mumme74/CarTransporter/README.md

# CarTransporter

This repository is for the electronics systems used to make car transporter

Electronic control of airsuspension
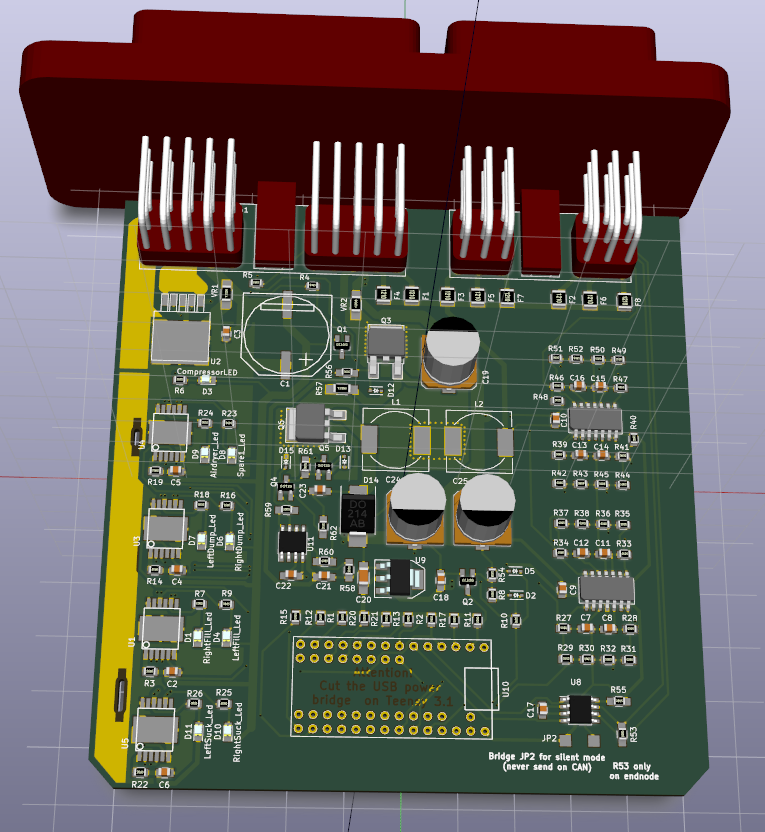
[picture p1: electronics/AirSuspension/airsuspension.png]
pcb


Electronic parkbrakes
