mumme74/CarTransporter/firmware/parkbrake_ECU/readme.txt

*****************************************************************************
** ChibiOS/RT port for ARM-Cortex-M4 STM32F373                            **
*****************************************************************************

** TARGET **

This firmware is supposed to run on the parkbrake baord sesigned within this respoitory
