mumme74/CarTransporter/Airsuspension.odt

L-fill

L-dump

L-suck

R-fill

R-dump

R-suck

SAAB transport Airsuspension

Pneumatic circuit

M

P

system-pressure sensor

Compressor temp. sensor

RR

RF

LR

LF

T

Airdryer bleed valve

R-fill

R-dump

L-dump

L-fill

L-pressure sensor

R-pressure sensor

P

P

Engine vacuum

R-suck

L-suck

Electric circuit inputs

15

5A

1 2 3 1 2 3 1 2 3 1 2 3 1 2 3 Can_hi Can_lo Can_hi Can_lo 120Ω 120Ω K2 30pin K1 30pin A2 18pin A1 18pin B2 18pin B1 18pin C3 18pin C2 18pin C1 18pin D3 18pin D2 18pin D1 18pin E3 18pin E2 18pin E1 18pin F1 18pin H2 30pin H3 30pin G1 30pin H1 30pin

2 (signal)

1 (5V feed)

3 (gnd)

!! TODO

Dbl check pinouts

2 (signal)

1 (5V feed)

3 (gnd)

!! TODO

Dbl check pinouts

P

1 = brown (12V)

2 = black (out 0-5V)

3 = blue (0V)

P

1 = brown (12V)

2 = black (out 0-5V)

3 = blue (0V)

P

1 = brown (12V)

2 = black (out 0-5V)

3 = blue (0V)

t-

Screen node

Park brake node

Left height sensor

Right height sensor

System pressure

Left pressure

Right pressure

Compressor

Temp

Sensor GND

1.5 black

1.5 blue

0.75 blue

0.75 blue

0.75 blue

0.75 brown

0.75 brown

0.75 brown

0.75 orange

0.75 white

0.75 red

0.75 brown

0.75 brown

0.75 yellow

0.75 yellow

0.75 gray

0.75 orange

0.75 yellow

0.75 violet

0.75 green

0.75 green/gray

Electric circuit outputs

30

Note!

2 fuses to distribute load

30A

15A

M M A2 30pin A1 30pin A3 30pin B1 30pin B2 30pin F1 30pin C1 30pin C2 30pin E1 30pin F3 30pin E3 30pin G3 30pin F2 30pin E2 30pin G2 30pin D1 30pin D2 30pin D3 30pin C3 30pin

t+

30

86

30A

Airdryer heater and bleed valve

Compressor

1.5 yellow

1,5 green

6 red

6 red

1.5 gray

1.5 darkblue

1.5 blue

1.5 violett

1.5 green

1.5 white

1.5 orange

1.5 black

1.5 black

1.5 black

1.5 black

6 black

Power GND

1.5 black

Sensor GND and Power GND must be 2 separate groundpoints

87

85

1.5 yellow

6 yellow
