mumme74/CarTransporter/Parkbrake.odt

Parkbrake Car transporter

5A

10A

5A

30

15

58

54

2017-01-08

Rd 1,5

680 1k 1k Can_hi Can_lo Can_hi Can_lo 120Ω 120Ω A2 30pin C3 18pin F3 18pin E3 18pin B1 30pin A1 30pin H3 30pin G3 30pin C1 30pin D1 30pin F3 30pin E3 30pin D2 30pin D3 30pin B2 30pin B3 30pin C2 30pin C3 30pin

Release

Activate

30

31

Non

Invert

Invert

58

15

Backlight

Parkbrake Light

Screen node

Suspension node

5A

5A

Bk 0,75

Bu 0,75

Bu 2,5

Or 0,75

0.75 green

0.75 green/gray

Wh 1,5

Ye 0,75

Gr 0,75

Gr 0,75

Bu 1,5

At cabin/rear section

ABS

L+ sensor

L- sensor

R+ sensor

R- sensor

LF sensor

RF sensor

LR sensor

RR sensor

Bu 2,5

Bu 1,5

D3 18pin A3 30pin

J2 30pin J3 30pin J1 30pin B3 18pin B2 18pin B1 18pin E1 30pin F1 30pin F1 18pin E1 18pin A2 18pin A1 18pin K3 30pin K2 30pin K1 30pin

30A

30A

30

At cabin/rear section

M M M M A3 18pin E2 18pin F2 18pin F2 30pin E2 30pin C1 18pin C2 18pin D1 18pin D2 18pin H1 30pin H2 30pin G1 30pin G2 30pin

30A

30A

Suspension

2.5 black

Power GND

6 black

4 connectorpins to distribute power

RR motor

RF motor

LF motor

LR motor

Pwr Rear

Pwr Front

+ 4 wh

- 4 bn

- 4 bu

- 4 sv

- 4 ye

+ 4 gn/gr

+ 4 gr

+ 4 rd

4 red

4 red

6 red

6 red

2.5 black

Power GND

6 black
