mumme74/CarTransporter/electronics/Parkbrake/Parkbrake.ods

Reference | Quantity | Value | Footprint | Datasheet | part | farnell
C1 C11 C12 C13 C16 C18 C19 C2 C20 C23 C25 C26 C27 C3 C30 C32 C34 C37 C39 C4 C42 C47 C48 C5 C57 C59 C6 C60 C61 C62 C64 C65 C66 C67 C68 C69 C70 C71 C9 C94 C95 C98 | 42 | 100n | Capacitors_SMD:C_0805 |  | 0805B104J500CT | 2496940
C10 C14 C17 C21 C24 C28 C31 C33 C50 C52 C54 C56 C7 C74 C75 C76 C77 C78 C79 C80 C81 C82 C87 C88 C89 C90 C91 | 27 | 1u | Capacitors_SMD:C_1206 |  | GRM31MR71E105JA01L | 2362126
C35 | 1 | 470p | Capacitors_SMD:C_0805 |  | 0805N471J500CT | 2497037
C36 | 1 | 10u | Capacitors_Tantalum_SMD:TantalC_SizeC_EIA-6032_Wave |  | T491C106K035AT | 1457464
C38 | 1 | 680u | Capacitors_Tantalum_SMD:TantalC_SizeD_EIA-7343_Wave |  | TPSE687K006R0060 | 2283882
C40 C41 C92 C93 | 4 | 10u | myfootprints:CP_0805 |  | TMCP0J106KTRF | 2491430
C43 C58 C63 C96 C97 C99 | 6 | 1n | Capacitors_SMD:C_0805 |  | GRM2165C1H102JA01D | 2494247
C44 C45 | 2 | 26p | Capacitors_SMD:C_0805 |  | 0805N270J500CT | 2497027
C46 | 1 | 4.7u | myfootprints:CP_0805 |  | TMCP0J475KTRF | 2491429
C49 C51 C53 C55 | 4 | 10n | Capacitors_SMD:C_0805 |  | 0805B103J500CT | 2496936
C72 C73 | 2 | 33uF | myfootprints:CP_1206 |  | 293D336X96R3A2TE3 | 1754149
C15 C22 C29 C8 | 4 | 220nF | Capacitors_SMD:C_1206 |  | 1206B224J500CT | 2497088
C83 C84 C85 C86 | 4 | 47n | Capacitors_SMD:C_0805 |  | 0805B473J500CT | 2496981
D10 | 1 | RF_Release | LEDs:LED_0805 |  | KP-2012LSGC | 2463991
D11 | 1 | RF_tighten | LEDs:LED_0805 |  | KP-2012SRC-PRV | 1318244
D12 | 1 | RR_Release | LEDs:LED_0805 |  | KP-2012LSGC | 2463991
D13 | 1 | RR_Tighten | LEDs:LED_0805 |  | KP-2012SRC-PRV | 1318244
D14 D15 D16 D17 D18 D19 D20 D21 D22 D23 D24 D25 | 12 | 1n4148W | Diodes_SMD:SOD-323 |  | 1N4148WS | 1466524
D26 | 1 | min 40V 1A | Diodes_SMD:SOD-123 |  | NTS260SFT1G | 2473419
D27 | 1 | min 1.5A | Diodes_SMD:SOD-123 |  | NTS260SFT1G | 2473419
D28 D29 D31 D32 D33 D34 | 6 | 3.3V | Diodes_SMD:SOD-323 |  | MM3Z3V3ST1G | 2463489
D3 D30 D35 D36 D37 D38 D39 D4 D40 D41 | 10 | 1n4148w | Diodes_SMD:SOD-323 |  | 1N4148WS | 1466524
D1 D2 D5 | 3 | 10v | Diodes_SMD:SOD-323 |  | MM3Z10VT1G | 1431190
D6 | 1 | LF_Release | LEDs:LED_0805 |  | KP-2012LSGC | 2463991
D7 | 1 | LF_Tighten | LEDs:LED_0805 |  | KP-2012SRC-PRV | 1318244
D8 | 1 | LR_Release | LEDs:LED_0805 |  | KP-2012LSGC | 2463991
D9 | 1 | LR_Tighten | LEDs:LED_0805 |  | KP-2012SRC-PRV | 1318244
Ha1 | 1 | Box |  |  | 5810130042 | 1282197
Ha2 | 1 | cooling_fin |  |  | 5810000021 | 1282203
Ha3 | 1 | conn_18pin |  |  | 581-01-18-023 | 2099333
Ha4 | 1 | connector_pins |  |  | 4250000872 | 1282209
Ha5 | 1 | box_socket |  |  | 5810148007 | 1282184
Ha6 | 1 | fin_left |  |  | 5810000020 | 1282204
Ha7 | 1 | conn_30pin |  |  | 581-01-30-029 | 2143771
Ha8 | 1 | sealplug_need_10 |  |  | 581-00-00-011 | 2099332
JP1 | 1 | BOOT0 | Resistors_SMD:R_0805_HandSoldering |  | RC1206JR-070RL | 9240276
JP10 | 1 | RF_passth+ | Resistors_SMD:R_0805_HandSoldering |  | RC1206JR-070RL | 9240276
JP11 | 1 | RF+_to_in | Resistors_SMD:R_0805_HandSoldering |  | RC1206JR-070RL | 9240276
JP12 | 1 | soft_R_out- | Resistors_SMD:R_0805_HandSoldering |  | RC1206JR-070RL | 9240276
JP13 | 1 | RF_passth- | Resistors_SMD:R_0805_HandSoldering |  | RC1206JR-070RL | 9240276
JP14 | 1 | RF-_to_in | Resistors_SMD:R_0805_HandSoldering |  | RC1206JR-070RL | 9240276
JP2 | 1 | Jumper_NO_Small | Resistors_SMD:R_0805_HandSoldering |  | RC1206JR-070RL | 9240276
JP3 | 1 | soft_L_out+ | Resistors_SMD:R_0805_HandSoldering |  | RC1206JR-070RL | 9240276
JP4 | 1 | L_passth+ | Resistors_SMD:R_0805_HandSoldering |  | RC1206JR-070RL | 9240276
JP5 | 1 | LF+_to_in | Resistors_SMD:R_0805_HandSoldering |  | RC1206JR-070RL | 9240276
JP6 | 1 | soft_L_out- | Resistors_SMD:R_0805_HandSoldering |  | RC1206JR-070RL | 9240276
JP7 | 1 | L_passth- | Resistors_SMD:R_0805_HandSoldering |  | RC1206JR-070RL | 9240276
JP8 | 1 | LF-_to_in | Resistors_SMD:R_0805_HandSoldering |  | RC1206JR-070RL | 9240276
JP9 | 1 | soft_R_out+ | Resistors_SMD:R_0805_HandSoldering |  | RC1206JR-070RL | 9240276
L1 | 1 | 10uH | myfootprints:inductor_sd54 |  | LQH32CN100K33L | 9522204
L2 | 1 | 33uH | myfootprints:inductor_sd54 |  | SD54-333MLB | 2526983
P1 | 1 | Conn48pin
P2 | 1 | JTAG | Socket_Strips:Socket_Strip_Straight_1x08 |  | 61300811121 | 2356160
P3 | 1 | UART | Socket_Strips:Socket_Strip_Straight_1x03 |  | 826629-3 | 3418297
Q1 Q2 Q31 | 3 | BSS138 | TO_SOT_Packages_SMD:SOT-323 |  | BSS138PW | 1907611
Q3 Q4 | 2 | P-ch -40V 0.0035ohm | TO_SOT_Packages_SMD:TO-252-2Lead |  | PD90P04P4-05 | 2480840
Q32 | 1 | NTS4173 | TO_SOT_Packages_SMD:SOT-323 |  | NTS4173PT1G | 2533203
Q5 Q6 | 2 | BSS308 | TO_SOT_Packages_SMD:SOT-23 |  | BSS308PE H6327 | 2432719
Q12 Q13 Q18 Q19 Q24 Q25 Q30 Q33 Q7 | 9 | NX3008CBKS | SOT363:SOT-363 |  | NX3008CBKS | 2069539
Q10 Q11 Q14 Q15 Q16 Q17 Q20 Q21 Q22 Q23 Q26 Q27 Q28 Q29 Q8 Q9 | 16 | IPD031N06L3 G | TO_SOT_Packages_SMD:TO-252-2Lead |  | IPD031N06L3 G | 2480814
R102 | 1 | 560 | Resistors_SMD:R_0805 |  | MC01W08051560R | 9333363
R103 | 1 | 2.2k | Resistors_SMD:R_Array_Concave_4x0603 |  | EXB38V222JV | 2060102
R104 R110 | 2 | 1k | Resistors_SMD:R_Array_Concave_4x0603 |  | EXB38V102JV | 2060100
R105 | 1 | 100k | Resistors_SMD:R_0805 |  | MC01W08051100K | 9332405
R107 | 1 | 2k | Resistors_SMD:R_0805 |  | MC01W080512K | 9332766
R108 R109 | 2 | 1M | Resistors_SMD:R_0805 |  | MC01W080511M | 9332413
R111 R112 R113 R114 | 4 | 15k | Resistors_SMD:R_0805 |  | ERJP06F1502V | 1750772
R115 R116 | 2 | 16.9k | Resistors_SMD:R_0805 |  | MC01W0805116K9 | 2141858
R17 R34 R51 R68 | 4 | 43 | Resistors_SMD:R_0805 |  | MC01W0805143R | 9333240
R20 R21 R22 R24 R37 R38 R39 R41 R54 R55 R56 R58 R71 R72 R73 R75 | 16 | 0.002 | Resistors_SMD:R_1206 |  | ULR1S-R002FT2 | 1621962
R19 R23 R36 R40 R53 R57 R70 R74 | 8 | 100 | Resistors_SMD:R_0805 |  | MC01W08051100R | 9332375
R14 R15 R25 R26 R31 R32 R42 R43 R48 R49 R59 R60 R65 R66 R76 R77 | 16 | 10 | Resistors_SMD:R_0805 |  | WF08P10R0FTL | 2502783
R101 R106 R3 R4 R6 R7 R8 R84 R9 R99 | 10 | 1k | Resistors_SMD:R_0805 |  | MC01W080511K | 9332383
R1 R10 R100 R11 R117 R118 R119 R12 R120 R13 R16 R18 R2 R27 R28 R29 R30 R33 R35 R44 R45 R46 R47 R5 R50 R52 R61 R62 R63 R64 R67 R69 R78 R83 R86 R88 R90 R91 R94 R95 R96 R97 R98 | 43 | 10k | Resistors_SMD:R_0805 |  | MC01W0805110K | 9332391
R79 | 1 | 0.150 1/2W | Resistors_SMD:R_1206 |  | WW12PR150FTL | 2503066
R80 R82 | 2 | 220k | Resistors_SMD:R_0805 |  | MC01W08051220K | 9332839
R81 | 1 | 12k | Resistors_SMD:R_0805 |  | MC01W0805112K | 9332502
R85 | 1 | 3k | Resistors_SMD:R_0805 |  | MC01W080513K | 9332995
R87 | 1 | 255 | Resistors_SMD:R_0805 |  | ERJ6ENF2550V | 2303484
R89 | 1 | 120 | Resistors_SMD:R_0805 |  | MC01W08051120R | 9332480
R92 R93 | 2 | 330 | Resistors_SMD:R_0805 |  | MC01W08051330R | 9333037
U1 U3 | 2 | 74LVC00 | Housings_SSOP:TSSOP-14_4.4x5mm_Pitch0.65mm |  | SN74LVC00APWR |  | 1105931
U2 U35 U4 | 3 | 74LVC08 | Housings_SSOP:TSSOP-14_4.4x5mm_Pitch0.65mm |  | 74LVC08APW-Q100.11 | 2445097
U21 | 1 | MIC2619 | TO_SOT_Packages_SMD:SOT-23-6 |  | MIC2619YD6-TR | 2509963
U22 | 1 | MC34063 | Housings_SOIC:SOIC-8_3.9x4.9mm_Pitch1.27mm |  | MC34063ABD-TR | 1087205
U23 | 1 | LD1117S33CTR | TO_SOT_Packages_SMD:SOT-223 |  | LD1117S33CTR | 1467779
U24 | 1 | CAT25160_EEPROM | Housings_SSOP:TSSOP-8_4.4x3mm_Pitch0.65mm |  | CAT25160YI-GT3 | 2534647
U25 | 1 | STM32F373RBTx | Housings_QFP:LQFP-64_10x10mm_Pitch0.5mm |  | STM32F373RBT6 | 2333277
U26 | 1 | SN65HVD1050D | Housings_SOIC:SOIC-8_3.9x4.9mm_Pitch1.27mm |  | SN65HVD1050D | 1220984
U27 | 1 | SN74LVC245ADBR | Housings_SSOP:SSOP-20_5.3x7.2mm_Pitch0.65mm |  | SN74LVC245ADBR | 1595415
U28 | 1 | SN74HC20 | Housings_SSOP:TSSOP-14_4.4x5mm_Pitch0.65mm |  | SN74HC20PW | 1741207
U29 | 1 | SN74HC02 | Housings_SSOP:TSSOP-14_4.4x5mm_Pitch0.65mm |  | SN74HC02PWR | 9590927
U30 | 1 | SN74HC132 | Housings_SSOP:TSSOP-14_4.4x5mm_Pitch0.65mm |  | SN74HC132PWR | 2342491
U31 U32 | 2 | MAX232 | Housings_SSOP:TSSOP-16_4.4x5mm_Pitch0.65mm |  | MAX202IPW | 2335478
U33 U34 | 2 | NCV1124 | Housings_SOIC:SOIC-8_3.9x4.9mm_Pitch1.27mm |  | NCV1124DR2G | 2534601
U13 U17 U5 U9 | 4 | LM2903 | Housings_SSOP:TSSOP-8_4.4x3mm_Pitch0.65mm |  | LM2903PT | 1094243
U11 U15 U19 U7 | 4 | ZXCT1082 | TO_SOT_Packages_SMD:SOT-23-5 |  | ZXCT1082E5TA | 1904025
U10 U12 U14 U16 U18 U20 U6 U8 | 8 | IRS2304 | Housings_SOIC:SOIC-8_3.9x4.9mm_Pitch1.27mm |  | IRS2304SPBF | 1498208
VR1 VR2 VR3 | 3 | VR | Resistors_SMD:R_1206 |  | VCAS120614A300DP | 2346678
W1 | 1 | TP_Safe_to_release | Measurement_Points:Measurement_Point_Round-SMD-Pad_Small
W2 | 1 | TP_Tighten_cmd | Measurement_Points:Measurement_Point_Round-SMD-Pad_Small
Y1 | 1 | 24Mhz | Crystals:ABM3 |  | ABM3-24.000MHZ-D2Y-T | 2467794
