mumme74/CarTransporter/electronics/Parkbrake/Parkbrake.kicad_pcb

## KiCad design electronics/Parkbrake/Parkbrake.kicad_pcb (2018-07-20)

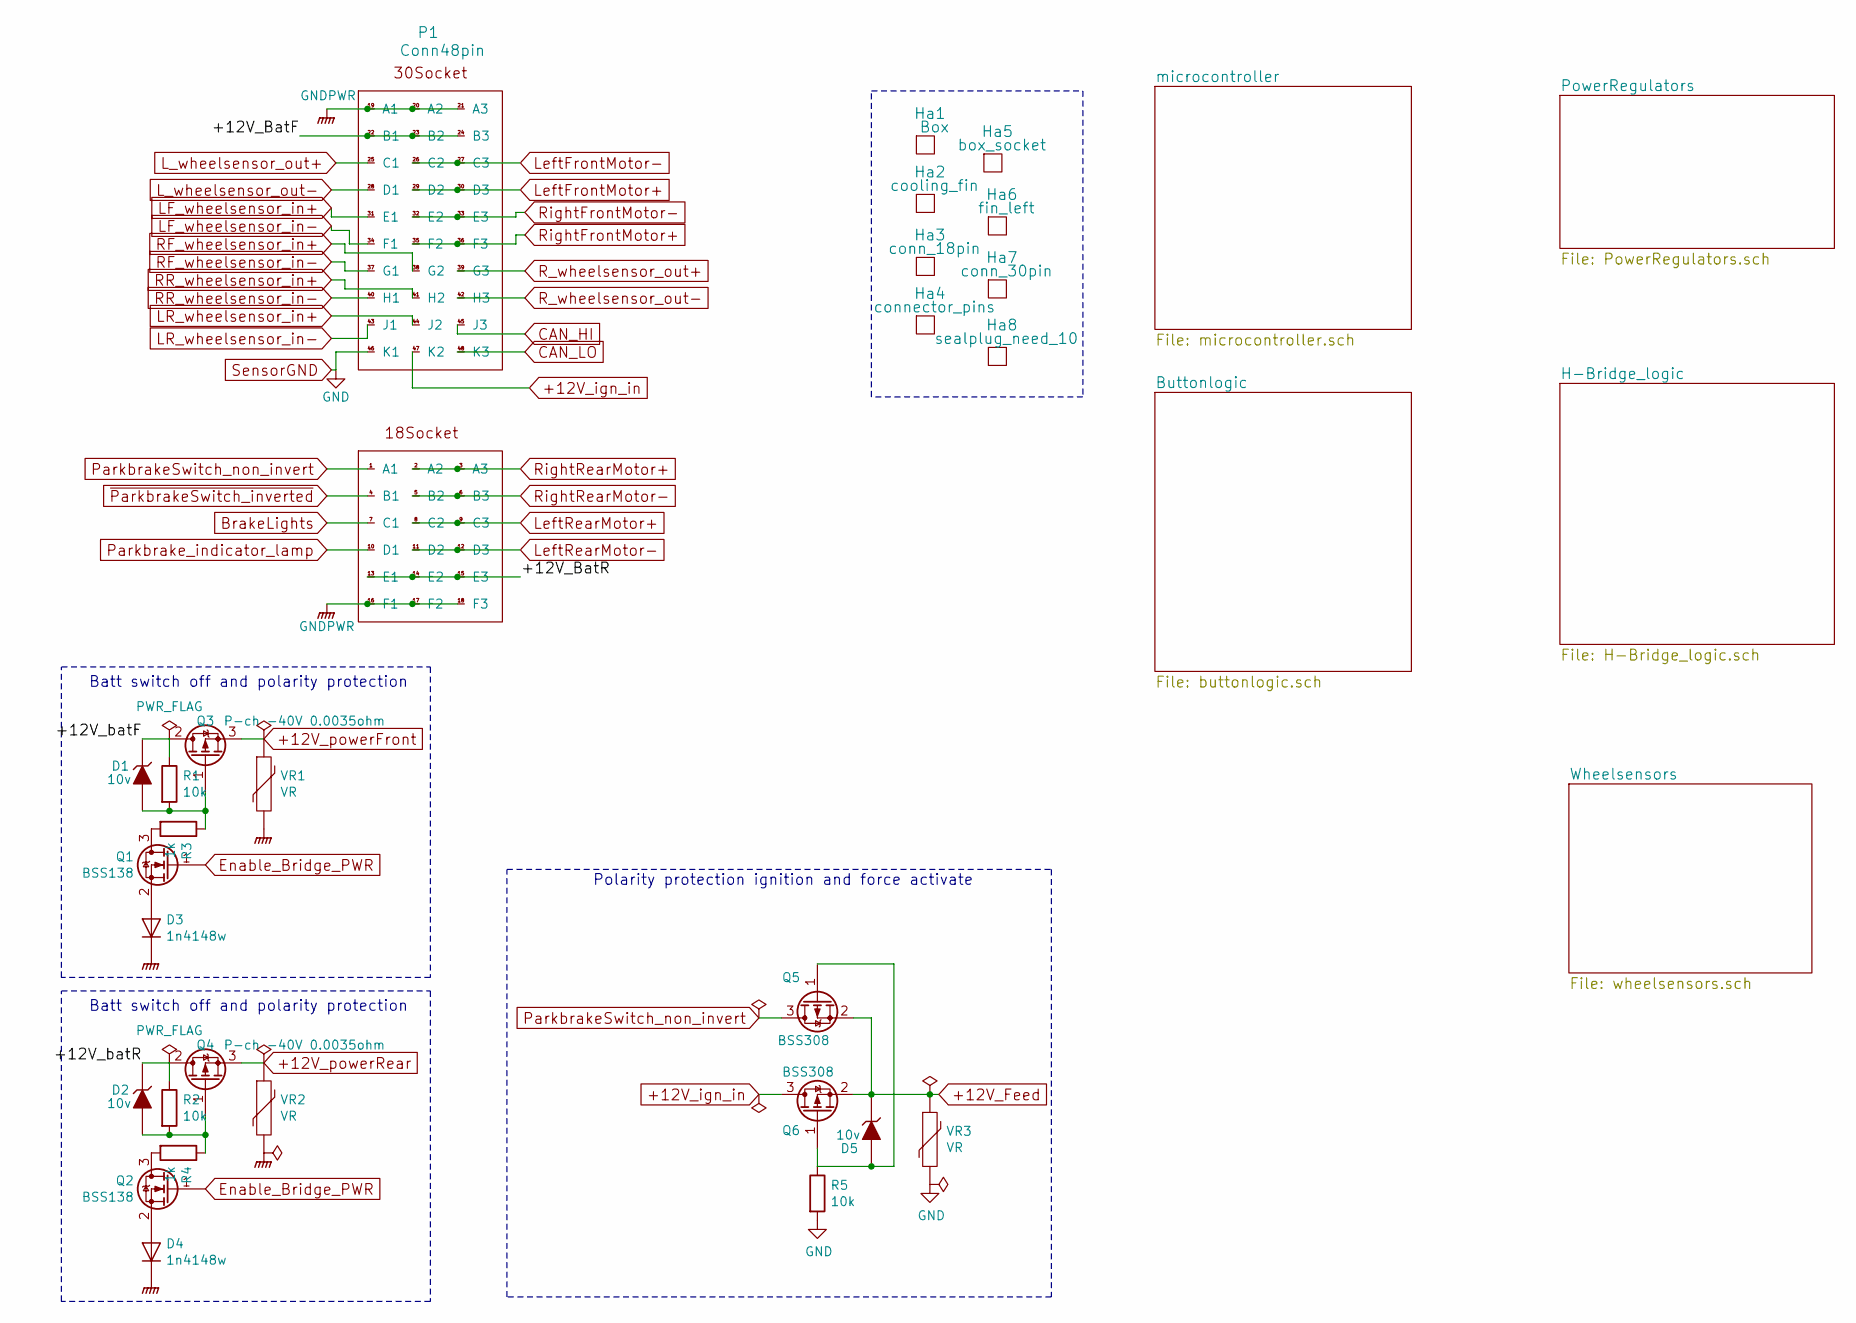
[picture p2: schematic Parkbrake.sch]

Parts:
D1, D2, D5: 10v; SOD-323; part MM3Z10VT1G; farnell 1431190
D3, D4: 1n4148w; SOD-323; part 1N4148WS; farnell 1466524
Ha1: Box; part 5810130042; farnell 1282197
Ha2: cooling_fin; part 5810000021; farnell 1282203
Ha3: conn_18pin; part 581-01-18-023; farnell 2099333
Ha4: connector_pins; part 4250000872; farnell 1282209
Ha5: box_socket; part 5810148007; farnell 1282184
Ha6: fin_left; part 5810000020; farnell 1282204
Ha7: conn_30pin; part 581-01-30-029; farnell 2143771
Ha8: sealplug_need_10; part 581-00-00-011; farnell 2099332
P1: Conn48pin
Q1, Q2: BSS138; SOT-323; part BSS138PW; farnell 1907611
Q3, Q4: P-ch -40V 0.0035ohm; TO-252-2Lead; part PD90P04P4-05; farnell 2480840
Q5, Q6: BSS308; SOT-23; part BSS308PE H6327; farnell 2432719
R1, R2, R5: 10k; R_0805; part MC01W0805110K; farnell 9332391
R3, R4: 1k; R_0805; part MC01W080511K; farnell 9332383
VR1, VR2, VR3: VR; R_1206; part VCAS120614A300DP; farnell 2346678

Connections:
+12V_Feed: D5.1 (K), Q5.2 (S), Q6.2 (S), VR3.1; also elsewhere on the board
+12V_ign_in: P1.47 (K2), Q6.3 (D); also elsewhere on the board
+12V_powerFront: Q3.3 (S), VR1.1; also elsewhere on the board
+12V_powerRear: Q4.3 (S), VR2.1; also elsewhere on the board
/+12V_BatF: D1.1 (K), P1.22 (B1), P1.23 (B2), P1.24 (B3), Q3.2 (D), R1.1
/+12V_BatR: D2.1 (K), P1.13 (E1), P1.14 (E2), P1.15 (E3), Q4.2 (D), R2.1
BrakeLights: P1.7 (C1); also elsewhere on the board
CAN_HI: P1.45 (J3); also elsewhere on the board
CAN_LO: P1.48 (K3); also elsewhere on the board
Enable_Bridge_PWR: Q1.1 (G), Q2.1 (G); also elsewhere on the board
GNDPWR: D3.1 (K), D4.1 (K), P1.16 (F1), P1.17 (F2), P1.18 (F3), P1.19 (A1), P1.20 (A2), P1.21 (A3), VR1.2, VR2.2; also elsewhere on the board
LF_wheelsensor_in+: P1.31 (E1); also elsewhere on the board
LF_wheelsensor_in-: P1.34 (F1); also elsewhere on the board
LR_wheelsensor_in+: P1.44 (J2); also elsewhere on the board
LR_wheelsensor_in-: P1.40 (H1), P1.43 (J1), P1.46 (K1), R5.2, VR3.2; also elsewhere on the board
L_wheelsensor_out+: P1.25 (C1); also elsewhere on the board
L_wheelsensor_out-: P1.28 (D1); also elsewhere on the board
LeftFrontMotor+: P1.29 (D2), P1.30 (D3); also elsewhere on the board
LeftFrontMotor-: P1.26 (C2), P1.27 (C3); also elsewhere on the board
LeftRearMotor+: P1.8 (C2), P1.9 (C3); also elsewhere on the board
LeftRearMotor-: P1.11 (D2), P1.12 (D3); also elsewhere on the board
unnamed: D1.2 (A), Q3.1 (G), R1.2, R3.1
unnamed: D2.2 (A), Q4.1 (G), R2.2, R4.1
unnamed: D3.2 (A), Q1.2 (S)
unnamed: D4.2 (A), Q2.2 (S)
unnamed: D5.2 (A), Q5.1 (G), Q6.1 (G), R5.1
unnamed: Q1.3 (D), R3.2
unnamed: Q2.3 (D), R4.2
ParkbrakeSwitch_non_invert: P1.1 (A1), Q5.3 (D); also elsewhere on the board
Parkbrake_indicator_lamp: P1.10 (D1); also elsewhere on the board
RF_wheelsensor_in+: P1.38 (G2); also elsewhere on the board
RF_wheelsensor_in-: P1.37 (G1); also elsewhere on the board
RR_wheelsensor_in+: P1.41 (H2); also elsewhere on the board
R_wheelsensor_out+: P1.39 (G3); also elsewhere on the board
R_wheelsensor_out-: P1.42 (H3); also elsewhere on the board
RightFrontMotor+: P1.35 (F2), P1.36 (F3); also elsewhere on the board
RightFrontMotor-: P1.32 (E2), P1.33 (E3); also elsewhere on the board
RightRearMotor+: P1.2 (A2), P1.3 (A3); also elsewhere on the board
RightRearMotor-: P1.5 (B2), P1.6 (B3); also elsewhere on the board
~ParkbrakeSwitch_inverted: P1.4 (B1); also elsewhere on the board

Notes on the sheet:
Batt switch off and polarity protection
Polarity protection ignition and force activate

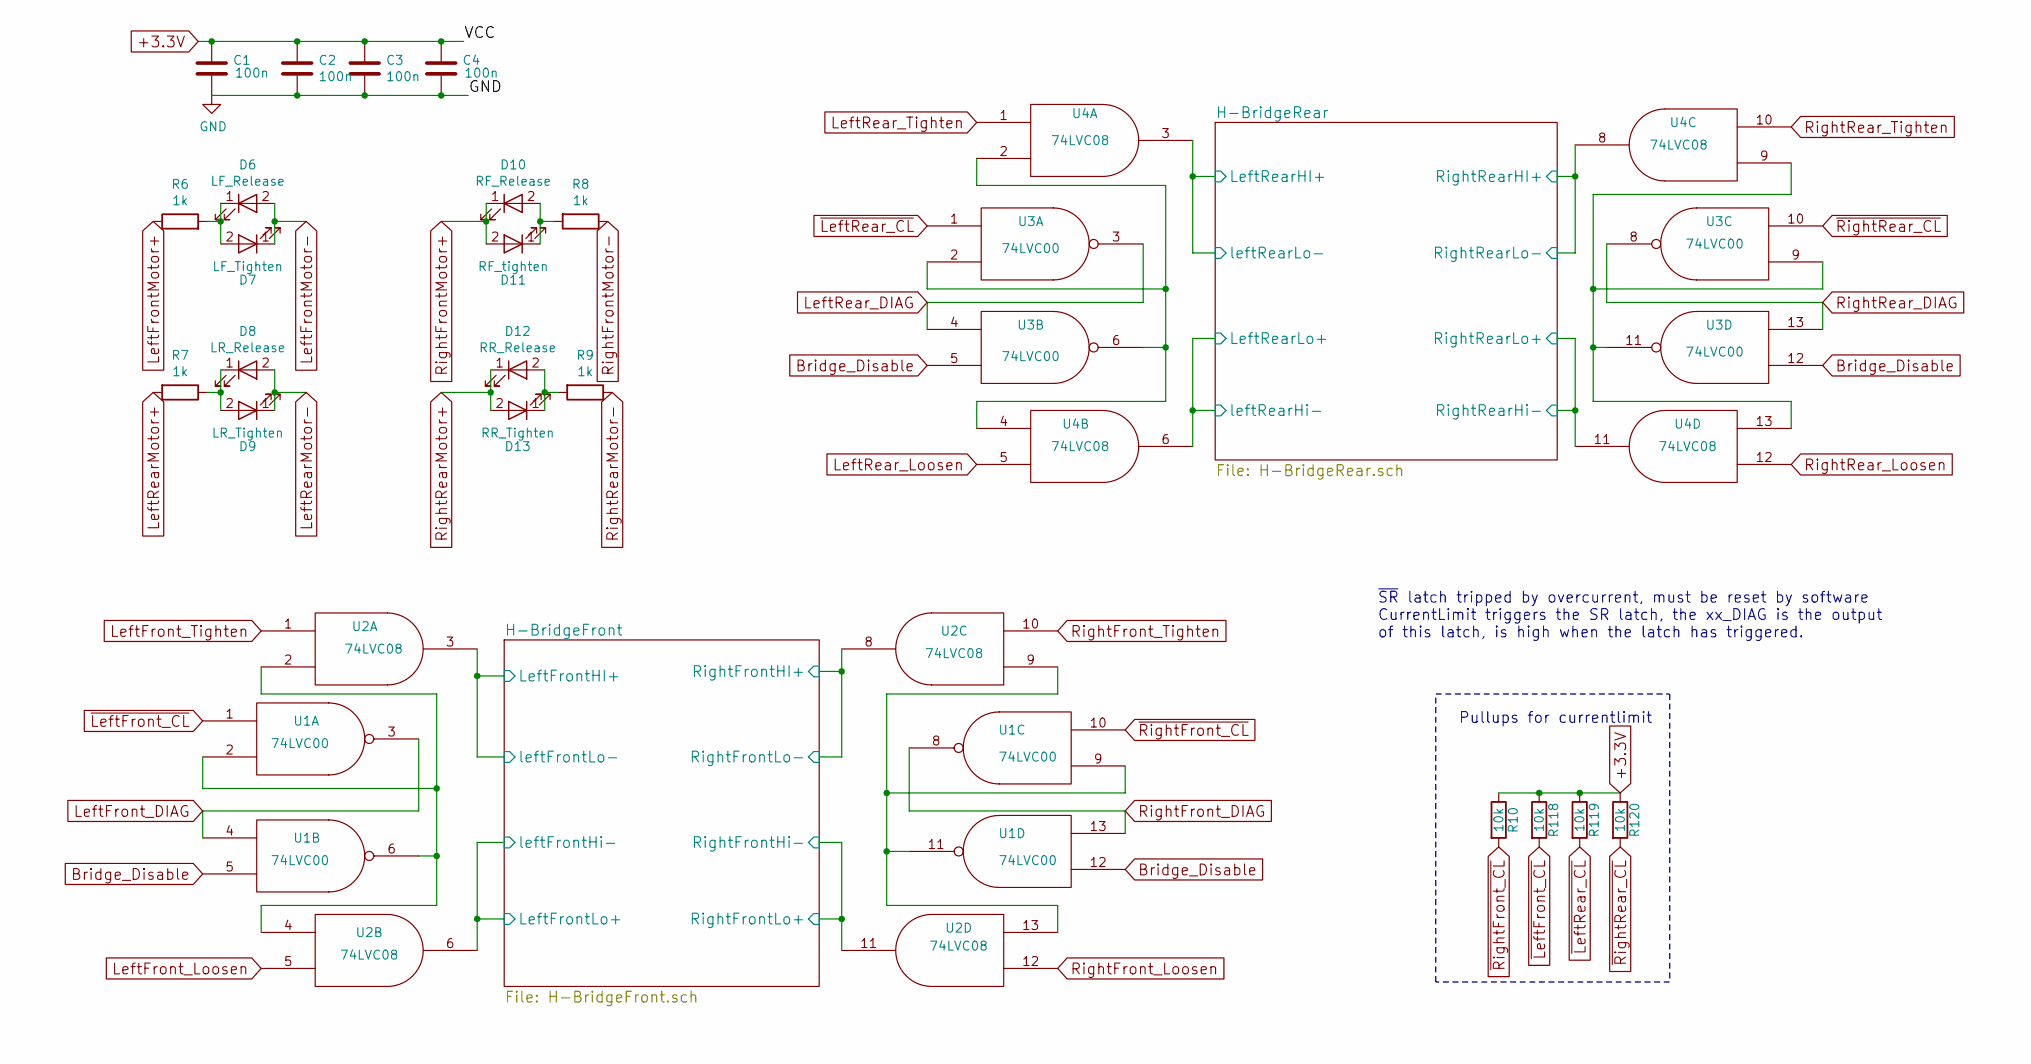
[picture p3: schematic H-Bridge_logic.sch]

Parts:
C1, C2, C3, C4: 100n; C_0805; part 0805B104J500CT; farnell 2496940
D6: LF_Release; LED_0805; part KP-2012LSGC; farnell 2463991
D7: LF_Tighten; LED_0805; part KP-2012SRC-PRV; farnell 1318244
D8: LR_Release; LED_0805; part KP-2012LSGC; farnell 2463991
D9: LR_Tighten; LED_0805; part KP-2012SRC-PRV; farnell 1318244
D10: RF_Release; LED_0805; part KP-2012LSGC; farnell 2463991
D11: RF_tighten; LED_0805; part KP-2012SRC-PRV; farnell 1318244
D12: RR_Release; LED_0805; part KP-2012LSGC; farnell 2463991
D13: RR_Tighten; LED_0805; part KP-2012SRC-PRV; farnell 1318244
R6, R7, R8, R9: 1k; R_0805; part MC01W080511K; farnell 9332383
R10, R118, R119, R120: 10k; R_0805; part MC01W0805110K; farnell 9332391
U1, U3: 74LVC00; TSSOP-14_4.4x5mm_Pitch0.65mm; part SN74LVC00APWR; farnell 1105931
U2, U4: 74LVC08; TSSOP-14_4.4x5mm_Pitch0.65mm; part 74LVC08APW-Q100.11; farnell 2445097

Connections:
+3.3V: C1.1, C2.1, C3.1, C4.1, R10.1, R118.1, R119.1, R120.1, U1.14 (VCC), U2.14 (VCC), U3.14 (VCC), U4.14 (VCC); also elsewhere on the board
/H-Bridge_logic/H-BridgeFront/LeftFrontHI+: U2.3; also elsewhere on the board
/H-Bridge_logic/H-BridgeFront/LeftFrontLo+: U2.6; also elsewhere on the board
/H-Bridge_logic/H-BridgeFront/RightFrontHI+: U2.8; also elsewhere on the board
/H-Bridge_logic/H-BridgeFront/RightFrontHi-: U2.11; also elsewhere on the board
/H-Bridge_logic/H-BridgeRear/LeftRearHI+: U4.3; also elsewhere on the board
/H-Bridge_logic/H-BridgeRear/LeftRearLo+: U4.6; also elsewhere on the board
/H-Bridge_logic/H-BridgeRear/RightRearHI+: U4.8; also elsewhere on the board
/H-Bridge_logic/H-BridgeRear/RightRearHi-: U4.11; also elsewhere on the board
Bridge_Disable: U1.5, U1.12, U3.5, U3.12; also elsewhere on the board
LR_wheelsensor_in-: C1.2, C2.2, C3.2, C4.2, U1.7 (GND), U2.7 (GND), U3.7 (GND), U4.7 (GND); also elsewhere on the board
LeftFrontMotor+: R6.1; also elsewhere on the board
LeftFrontMotor-: D6.2 (A), D7.1 (K); also elsewhere on the board
LeftFront_DIAG: U1.3, U1.4; also elsewhere on the board
LeftFront_Loosen: U2.5; also elsewhere on the board
LeftFront_Tighten: U2.1; also elsewhere on the board
LeftRearMotor+: R7.2; also elsewhere on the board
LeftRearMotor-: D8.2 (A), D9.1 (K); also elsewhere on the board
LeftRear_DIAG: U3.3, U3.4; also elsewhere on the board
LeftRear_Loosen: U4.5; also elsewhere on the board
LeftRear_Tighten: U4.1; also elsewhere on the board
unnamed: D6.1 (K), D7.2 (A), R6.2
unnamed: D8.1 (K), D9.2 (A), R7.1
unnamed: D10.2 (A), D11.1 (K), R8.2
unnamed: D12.2 (A), D13.1 (K), R9.2
unnamed: U1.2, U1.6, U2.2, U2.4
unnamed: U1.9, U1.11, U2.9, U2.13
unnamed: U3.2, U3.6, U4.2, U4.4
unnamed: U3.9, U3.11, U4.9, U4.13
RightFrontMotor+: D10.1 (K), D11.2 (A); also elsewhere on the board
RightFrontMotor-: R8.1; also elsewhere on the board
RightFront_DIAG: U1.8, U1.13; also elsewhere on the board
RightFront_Loosen: U2.12; also elsewhere on the board
RightFront_Tighten: U2.10; also elsewhere on the board
RightRearMotor+: D12.1 (K), D13.2 (A); also elsewhere on the board
RightRearMotor-: R9.1; also elsewhere on the board
RightRear_DIAG: U3.8, U3.13; also elsewhere on the board
RightRear_Loosen: U4.12; also elsewhere on the board
RightRear_Tighten: U4.10; also elsewhere on the board
~LeftFront_CL: R118.2, U1.1; also elsewhere on the board
~LeftRear_CL: R119.2, U3.1; also elsewhere on the board
~RightFront_CL: R10.2, U1.10; also elsewhere on the board
~RightRear_CL: R120.2, U3.10; also elsewhere on the board

Notes on the sheet:
~SR~ latch tripped by overcurrent, must be reset by software CurrentLimit triggers the SR latch, the xx_DIAG is the output of this latch, is high when the latch has triggered.
Pullups for currentlimit

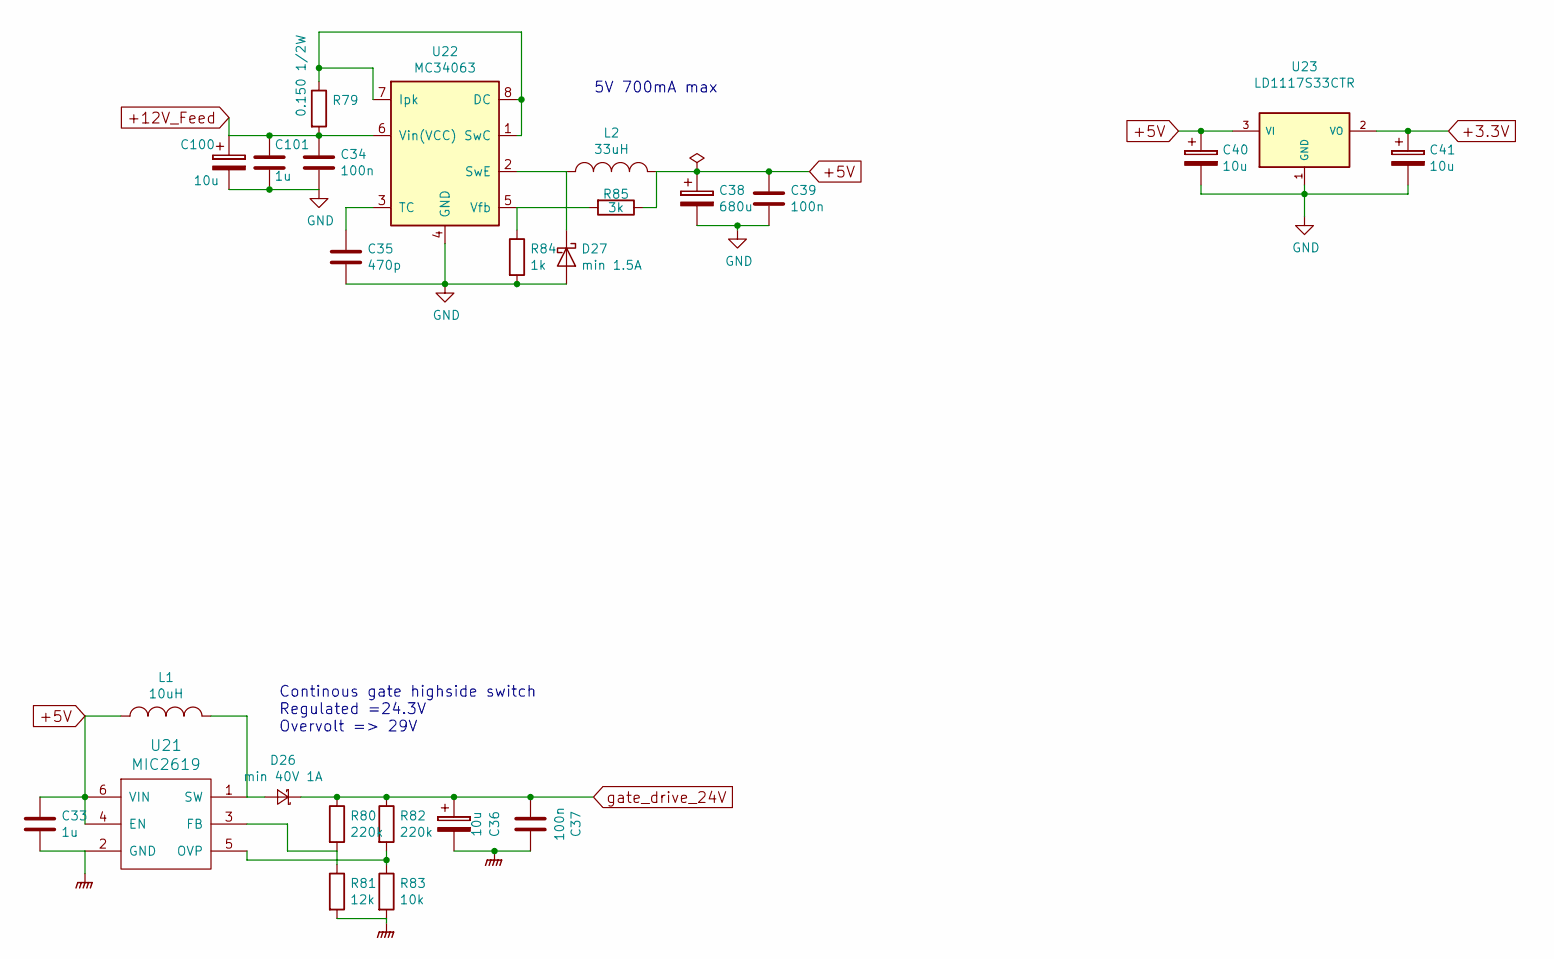
[picture p4: schematic PowerRegulators.sch]

Parts:
C33, C101: 1u; C_1206; part GRM31MR71E105JA01L; farnell 2362126
C34, C37, C39: 100n; C_0805; part 0805B104J500CT; farnell 2496940
C35: 470p; C_0805; part 0805N471J500CT; farnell 2497037
C36: 10u; TantalC_SizeC_EIA-6032_Wave; part T491C106K035AT; farnell 1457464
C38: 680u; TantalC_SizeD_EIA-7343_Wave; part TPSE687K006R0060; farnell 2283882
C40, C41, C100: 10u; CP_0805; part TMCP0J106KTRF; farnell 2491430
D26: min 40V 1A; SOD-123; part NTS260SFT1G; farnell 2473419
D27: min 1.5A; SOD-123; part NTS260SFT1G; farnell 2473419
L1: 10uH; inductor_sd54; part LQH32CN100K33L; farnell 9522204
L2: 33uH; inductor_sd54; part SD54-333MLB; farnell 2526983
R79: 0.150 1/2W; R_1206; part WW12PR150FTL; farnell 2503066
R80, R82: 220k; R_0805; part MC01W08051220K; farnell 9332839
R81: 12k; R_0805; part MC01W0805112K; farnell 9332502
R83: 10k; R_0805; part MC01W0805110K; farnell 9332391
R84: 1k; R_0805; part MC01W080511K; farnell 9332383
R85: 3k; R_0805; part MC01W080513K; farnell 9332995
U21: MIC2619; SOT-23-6; part MIC2619YD6-TR; farnell 2509963
U22: MC34063; SOIC-8_3.9x4.9mm_Pitch1.27mm; part MC34063ABD-TR; farnell 1087205
U23: LD1117S33CTR; SOT-223; part LD1117S33CTR; farnell 1467779

Connections:
+3.3V: C41.1, U23.2 (VO); also elsewhere on the board
+5V: C33.1, C38.1, C39.1, C40.1, L1.1, L2.2, R85.1, U21.4 (EN), U21.6 (VIN), U23.3 (VI); also elsewhere on the board
+12V_Feed: C34.1, C100.1, C101.1, R79.2, U22.6 (Vin(VCC)); also elsewhere on the board
GNDPWR: C33.2, C36.2, C37.1, R81.2, R83.2, U21.2 (GND); also elsewhere on the board
LR_wheelsensor_in-: C34.2, C35.2, C38.2, C39.2, C40.2, C41.2, C100.2, C101.2, D27.2 (A), R84.2, U22.4 (GND), U23.1 (GND); also elsewhere on the board
unnamed: C35.1, U22.3 (TC)
unnamed: D26.2 (A), L1.2, U21.1 (SW)
unnamed: D27.1 (K), L2.1, U22.2 (SwE)
unnamed: R79.1, U22.1 (SwC), U22.7 (Ipk), U22.8 (DC)
unnamed: R80.2, R81.1, U21.3 (FB)
unnamed: R82.2, R83.1, U21.5 (OVP)
unnamed: R84.1, R85.2, U22.5 (Vfb)
gate_drive_24V: C36.1, C37.2, D26.1 (K), R80.1, R82.1; also elsewhere on the board

Notes on the sheet:
Continous gate highside switch Regulated =24.3V Overvolt => 29V
5V 700mA max

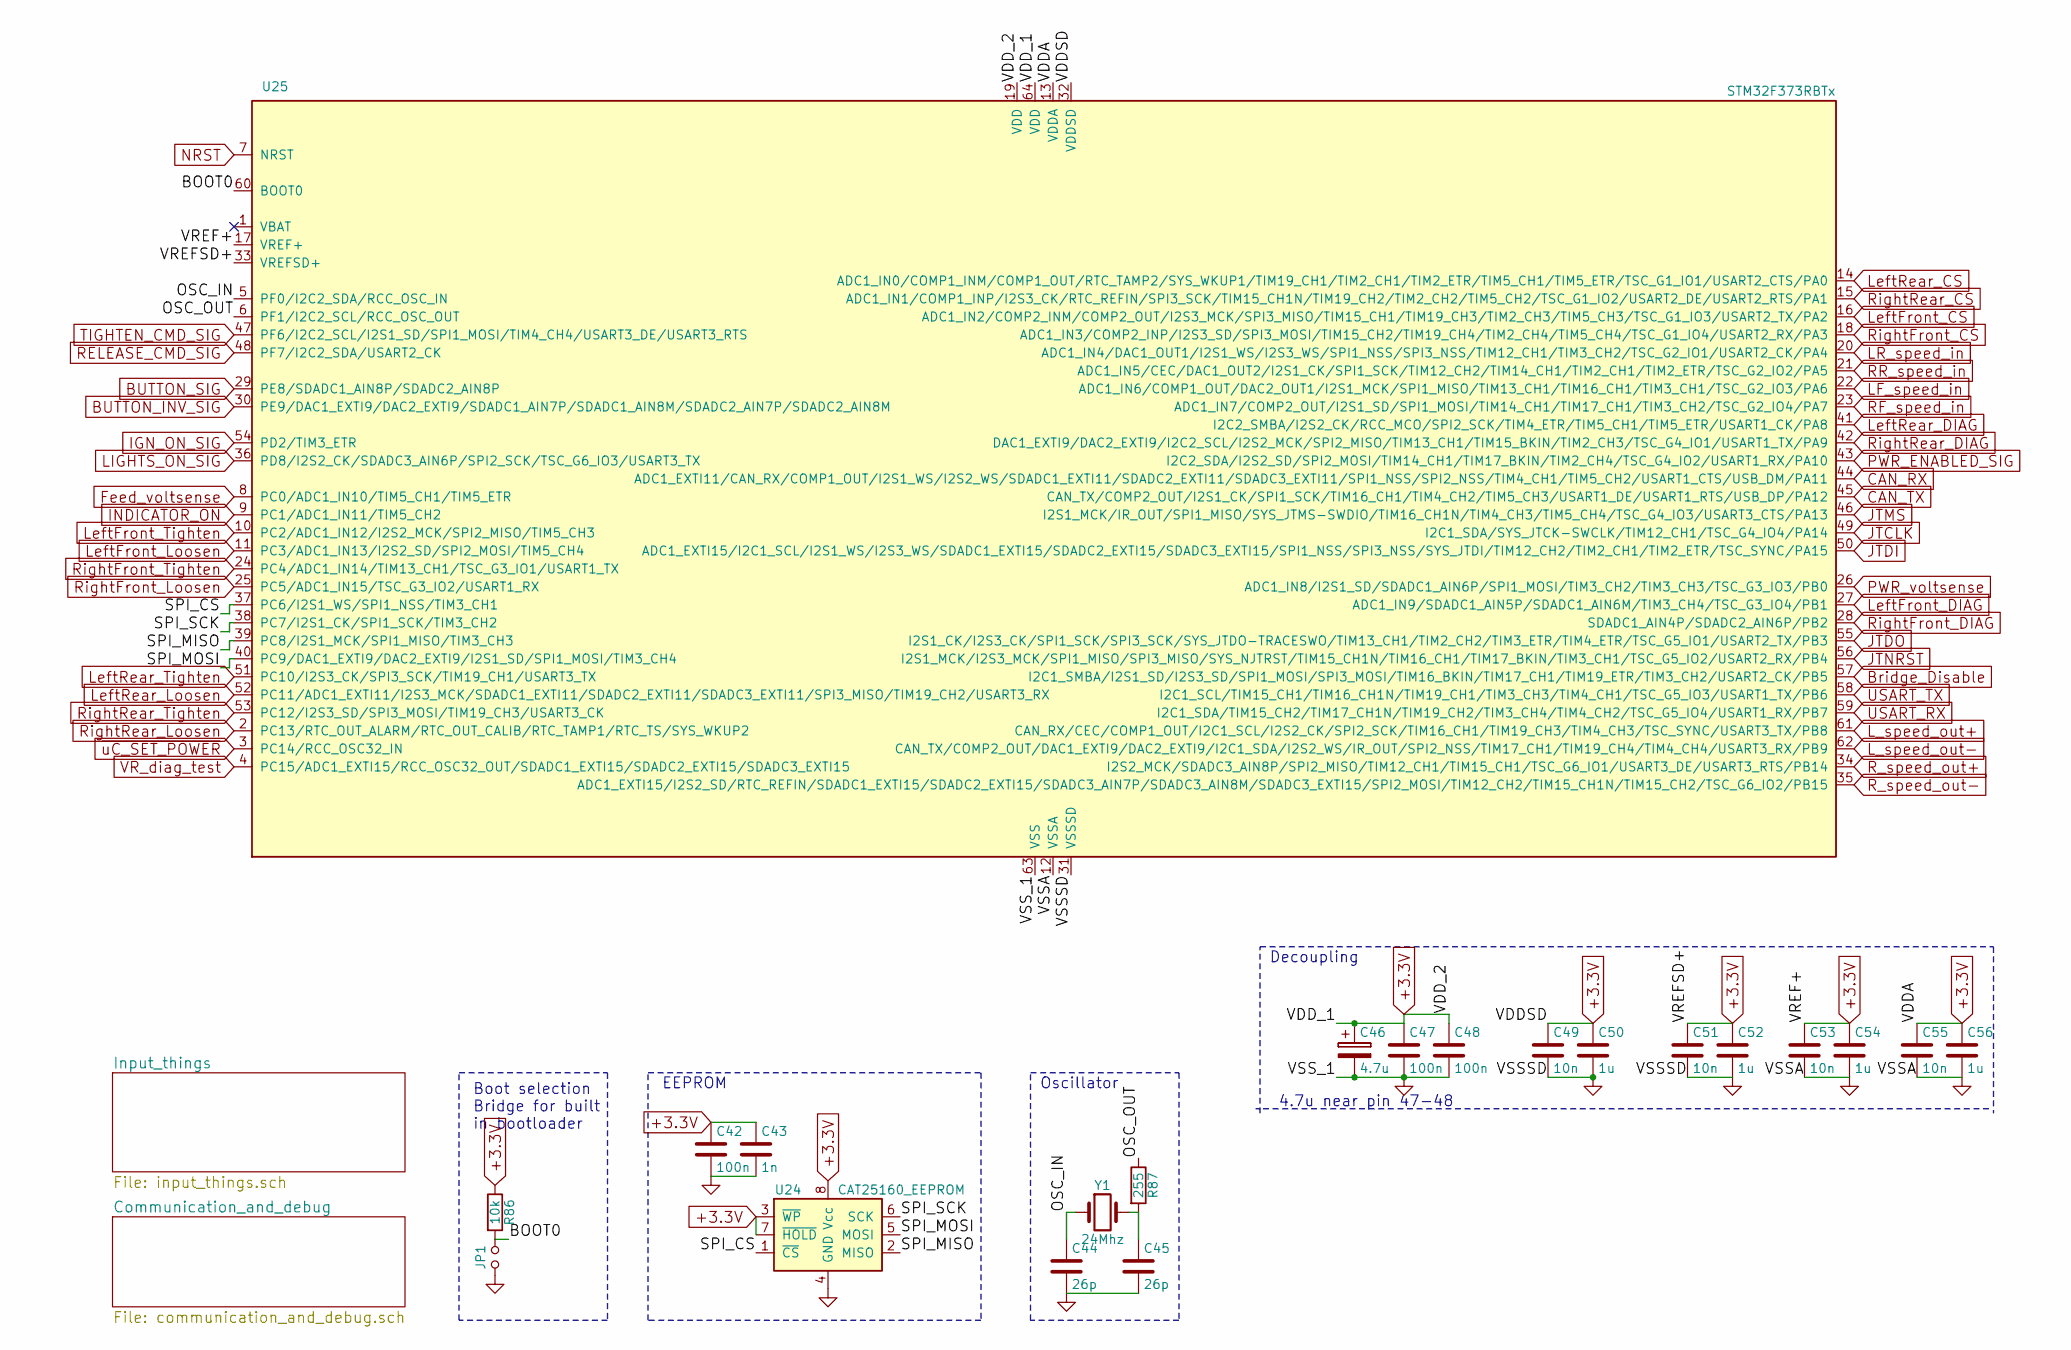
[picture p5: schematic microcontroller.sch]

Parts:
C42, C47, C48: 100n; C_0805; part 0805B104J500CT; farnell 2496940
C43: 1n; C_0805; part GRM2165C1H102JA01D; farnell 2494247
C44, C45: 26p; C_0805; part 0805N270J500CT; farnell 2497027
C46: 4.7u; CP_0805; part TMCP0J475KTRF; farnell 2491429
C49, C51, C53, C55: 10n; C_0805; part 0805B103J500CT; farnell 2496936
C50, C52, C54, C56: 1u; C_1206; part GRM31MR71E105JA01L; farnell 2362126
JP1: BOOT0; R_0805_HandSoldering; part RC1206JR-070RL; farnell 9240276
R86: 10k; R_0805; part MC01W0805110K; farnell 9332391
R87: 255; R_0805; part ERJ6ENF2550V; farnell 2303484
U24: CAT25160_EEPROM; TSSOP-8_4.4x3mm_Pitch0.65mm; part CAT25160YI-GT3; farnell 2534647
U25: STM32F373RBTx; LQFP-64_10x10mm_Pitch0.5mm; part STM32F373RBT6; farnell 2333277
Y1: 24Mhz; ABM3; part ABM3-24.000MHZ-D2Y-T; farnell 2467794

Connections:
+3.3V: C42.1, C43.1, C46.1, C47.1, C48.1, C49.1, C50.1, C51.1, C52.1, C53.1, C54.1, C55.1, C56.1, R86.1, U24.3 (~WP), U24.7 (~HOLD), U24.8 (Vcc), U25.13 (VDDA), U25.17 (VREF+), U25.19 (VDD), U25.32 (VDDSD), U25.33 (VREFSD+), U25.64 (VDD); also elsewhere on the board
/microcontroller/BOOT0: JP1.2, R86.2, U25.60 (BOOT0)
/microcontroller/OSC_IN: C44.1, U25.5 (PF0/I2C2_SDA/RCC_OSC_IN), Y1.1
/microcontroller/OSC_OUT: R87.1, U25.6 (PF1/I2C2_SCL/RCC_OSC_OUT)
/microcontroller/SPI_CS: U24.1 (~CS), U25.37 (PC6/I2S1_WS/SPI1_NSS/TIM3_CH1)
/microcontroller/SPI_MISO: U24.2 (MISO), U25.39 (PC8/I2S1_MCK/SPI1_MISO/TIM3_CH3)
/microcontroller/SPI_MOSI: U24.5 (MOSI), U25.40 (PC9/DAC1_EXTI9/DAC2_EXTI9/I2S1_SD/SPI1_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)
/microcontroller/SPI_SCK: U24.6 (SCK), U25.38 (PC7/I2S1_CK/SPI1_SCK/TIM3_CH2)
BUTTON_INV_SIG: U25.30 (PE9/DAC1_EXTI9/DAC2_EXTI9/SDADC1_AIN7P/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); also elsewhere on the board
BUTTON_SIG: U25.29 (PE8/SDADC1_AIN8P/SDADC2_AIN8P); also elsewhere on the board
Bridge_Disable: U25.57 (I2C1_SMBA/I2S1_SD/I2S3_SD/SPI1_MOSI/SPI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); also elsewhere on the board
CAN_RX: U25.44 (ADC1_EXTI11/CAN_RX/COMP1_OUT/I2S1_WS/I2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); also elsewhere on the board
CAN_TX: U25.45 (CAN_TX/COMP2_OUT/I2S1_CK/SPI1_SCK/TIM16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); also elsewhere on the board
Feed_voltsense: U25.8 (PC0/ADC1_IN10/TIM5_CH1/TIM5_ETR); also elsewhere on the board
IGN_ON_SIG: U25.54 (PD2/TIM3_ETR); also elsewhere on the board
INDICATOR_ON: U25.9 (PC1/ADC1_IN11/TIM5_CH2); also elsewhere on the board
JTCLK: U25.49 (I2C1_SDA/SYS_JTCK-SWCLK/TIM12_CH1/TSC_G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); also elsewhere on the board
JTDI: U25.50 (ADC1_EXTI15/I2C1_SCL/I2S1_WS/I2S3_WS/SD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); also elsewhere on the board
JTDO: U25.55 (I2S1_CK/I2S3_CK/SPI1_SCK/SPI3_SCK/SYS_J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); also elsewhere on the board
JTMS: U25.46 (I2S1_MCK/IR_OUT/SPI1_MISO/SYS_JTMS-SWDI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); also elsewhere on the board
JTNRST: U25.56 (I2S1_MCK/I2S3_MCK/SPI1_MISO/SPI3_MISO/S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); also elsewhere on the board
LF_speed_in: U25.22 (ADC1_IN6/COMP1_OUT/DAC2_OUT1/I2S1_MCK/S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); also elsewhere on the board
LIGHTS_ON_SIG: U25.36 (PD8/I2S2_CK/SDADC3_AIN6P/SPI2_SCK/TSC_G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); also elsewhere on the board
LR_speed_in: U25.20 (ADC1_IN4/DAC1_OUT1/I2S1_WS/I2S3_WS/SPI1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); also elsewhere on the board
LR_wheelsensor_in-: C42.2, C43.2, C44.2, C45.2, C46.2, C47.2, C48.2, C49.2, C50.2, C51.2, C52.2, C53.2, C54.2, C55.2, C56.2, JP1.1, U24.4 (GND), U25.12 (VSSA), U25.31 (VSSSD), U25.63 (VSS); also elsewhere on the board
L_speed_out+: U25.61 (CAN_RX/CEC/COMP1_OUT/I2C1_SCL/I2S2_CK/S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); also elsewhere on the board
L_speed_out-: U25.62 (CAN_TX/COMP2_OUT/DAC1_EXTI9/DAC2_EXTI9/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); also elsewhere on the board
LeftFront_CS: U25.16 (ADC1_IN2/COMP2_INM/COMP2_OUT/I2S3_MCK/S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); also elsewhere on the board
LeftFront_DIAG: U25.27 (ADC1_IN9/SDADC1_AIN5P/SDADC1_AIN6M/TIM3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); also elsewhere on the board
LeftFront_Loosen: U25.11 (PC3/ADC1_IN13/I2S2_SD/SPI2_MOSI/TIM5_CH4); also elsewhere on the board
LeftFront_Tighten: U25.10 (PC2/ADC1_IN12/I2S2_MCK/SPI2_MISO/TIM5_C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); also elsewhere on the board
LeftRear_CS: U25.14 (ADC1_IN0/COMP1_INM/COMP1_OUT/RTC_TAMP2/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); also elsewhere on the board
LeftRear_DIAG: U25.41 (I2C2_SMBA/I2S2_CK/RCC_MCO/SPI2_SCK/TIM4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); also elsewhere on the board
LeftRear_Loosen: U25.52 (PC11/ADC1_EXTI11/I2S3_MCK/SDADC1_EXTI11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); also elsewhere on the board
LeftRear_Tighten: U25.51 (PC10/I2S3_CK/SPI3_SCK/TIM19_CH1/USART3_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); also elsewhere on the board
NRST: U25.7 (NRST); also elsewhere on the board
unnamed: C45.1, R87.2, Y1.2
PWR_ENABLED_SIG: U25.43 (I2C2_SDA/I2S2_SD/SPI2_MOSI/TIM14_CH1/TI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); also elsewhere on the board
PWR_voltsense: U25.26 (ADC1_IN8/I2S1_SD/SDADC1_AIN6P/SPI1_MOSI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); also elsewhere on the board
RELEASE_CMD_SIG: U25.48 (PF7/I2C2_SDA/USART2_CK); also elsewhere on the board
RF_speed_in: U25.23 (ADC1_IN7/COMP2_OUT/I2S1_SD/SPI1_MOSI/TI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); also elsewhere on the board
RR_speed_in: U25.21 (ADC1_IN5/CEC/DAC1_OUT2/I2S1_CK/SPI1_SCK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); also elsewhere on the board
R_speed_out+: U25.34 (I2S2_MCK/SDADC3_AIN8P/SPI2_MISO/TIM12_C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); also elsewhere on the board
R_speed_out-: U25.35 (ADC1_EXTI15/I2S2_SD/RTC_REFIN/SDADC1_EX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); also elsewhere on the board
RightFront_CS: U25.18 (ADC1_IN3/COMP2_INP/I2S3_SD/SPI3_MOSI/TI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); also elsewhere on the board
RightFront_DIAG: U25.28 (SDADC1_AIN4P/SDADC2_AIN6P/PB2); also elsewhere on the board
RightFront_Loosen: U25.25 (PC5/ADC1_IN15/TSC_G3_IO2/USART1_RX); also elsewhere on the board
RightFront_Tighten: U25.24 (PC4/ADC1_IN14/TIM13_CH1/TSC_G3_IO1/USAR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); also elsewhere on the board
RightRear_CS: U25.15 (ADC1_IN1/COMP1_INP/I2S3_CK/RTC_REFIN/SP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); also elsewhere on the board
RightRear_DIAG: U25.42 (DAC1_EXTI9/DAC2_EXTI9/I2C2_SCL/I2S2_MCK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); also elsewhere on the board
RightRear_Loosen: U25.2 (PC13/RTC_OUT_ALARM/RTC_OUT_CALIB/RTC_TA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); also elsewhere on the board
RightRear_Tighten: U25.53 (PC12/I2S3_SD/SPI3_MOSI/TIM19_CH3/USART3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); also elsewhere on the board
TIGHTEN_CMD_SIG: U25.47 (PF6/I2C2_SCL/I2S1_SD/SPI1_MOSI/TIM4_CH4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); also elsewhere on the board
USART_RX: U25.59 (I2C1_SDA/TIM15_CH2/TIM17_CH1N/TIM19_CH2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); also elsewhere on the board
USART_TX: U25.58 (I2C1_SCL/TIM15_CH1/TIM16_CH1N/TIM19_CH1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); also elsewhere on the board
VR_diag_test: U25.4 (PC15/ADC1_EXTI15/RCC_OSC32_OUT/SDADC1_E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); also elsewhere on the board
~uC_SET_POWER: U25.3 (PC14/RCC_OSC32_IN); also elsewhere on the board

Notes on the sheet:
4.7u near pin 47-48
Oscillator
Decoupling
Boot selection Bridge for built in bootloader
EEPROM
