mumme74/CarTransporter/electronics/Parkbrake/Parkbrake.kicad_pcb

## KiCad design electronics/Parkbrake/Parkbrake.kicad_pcb (continued)

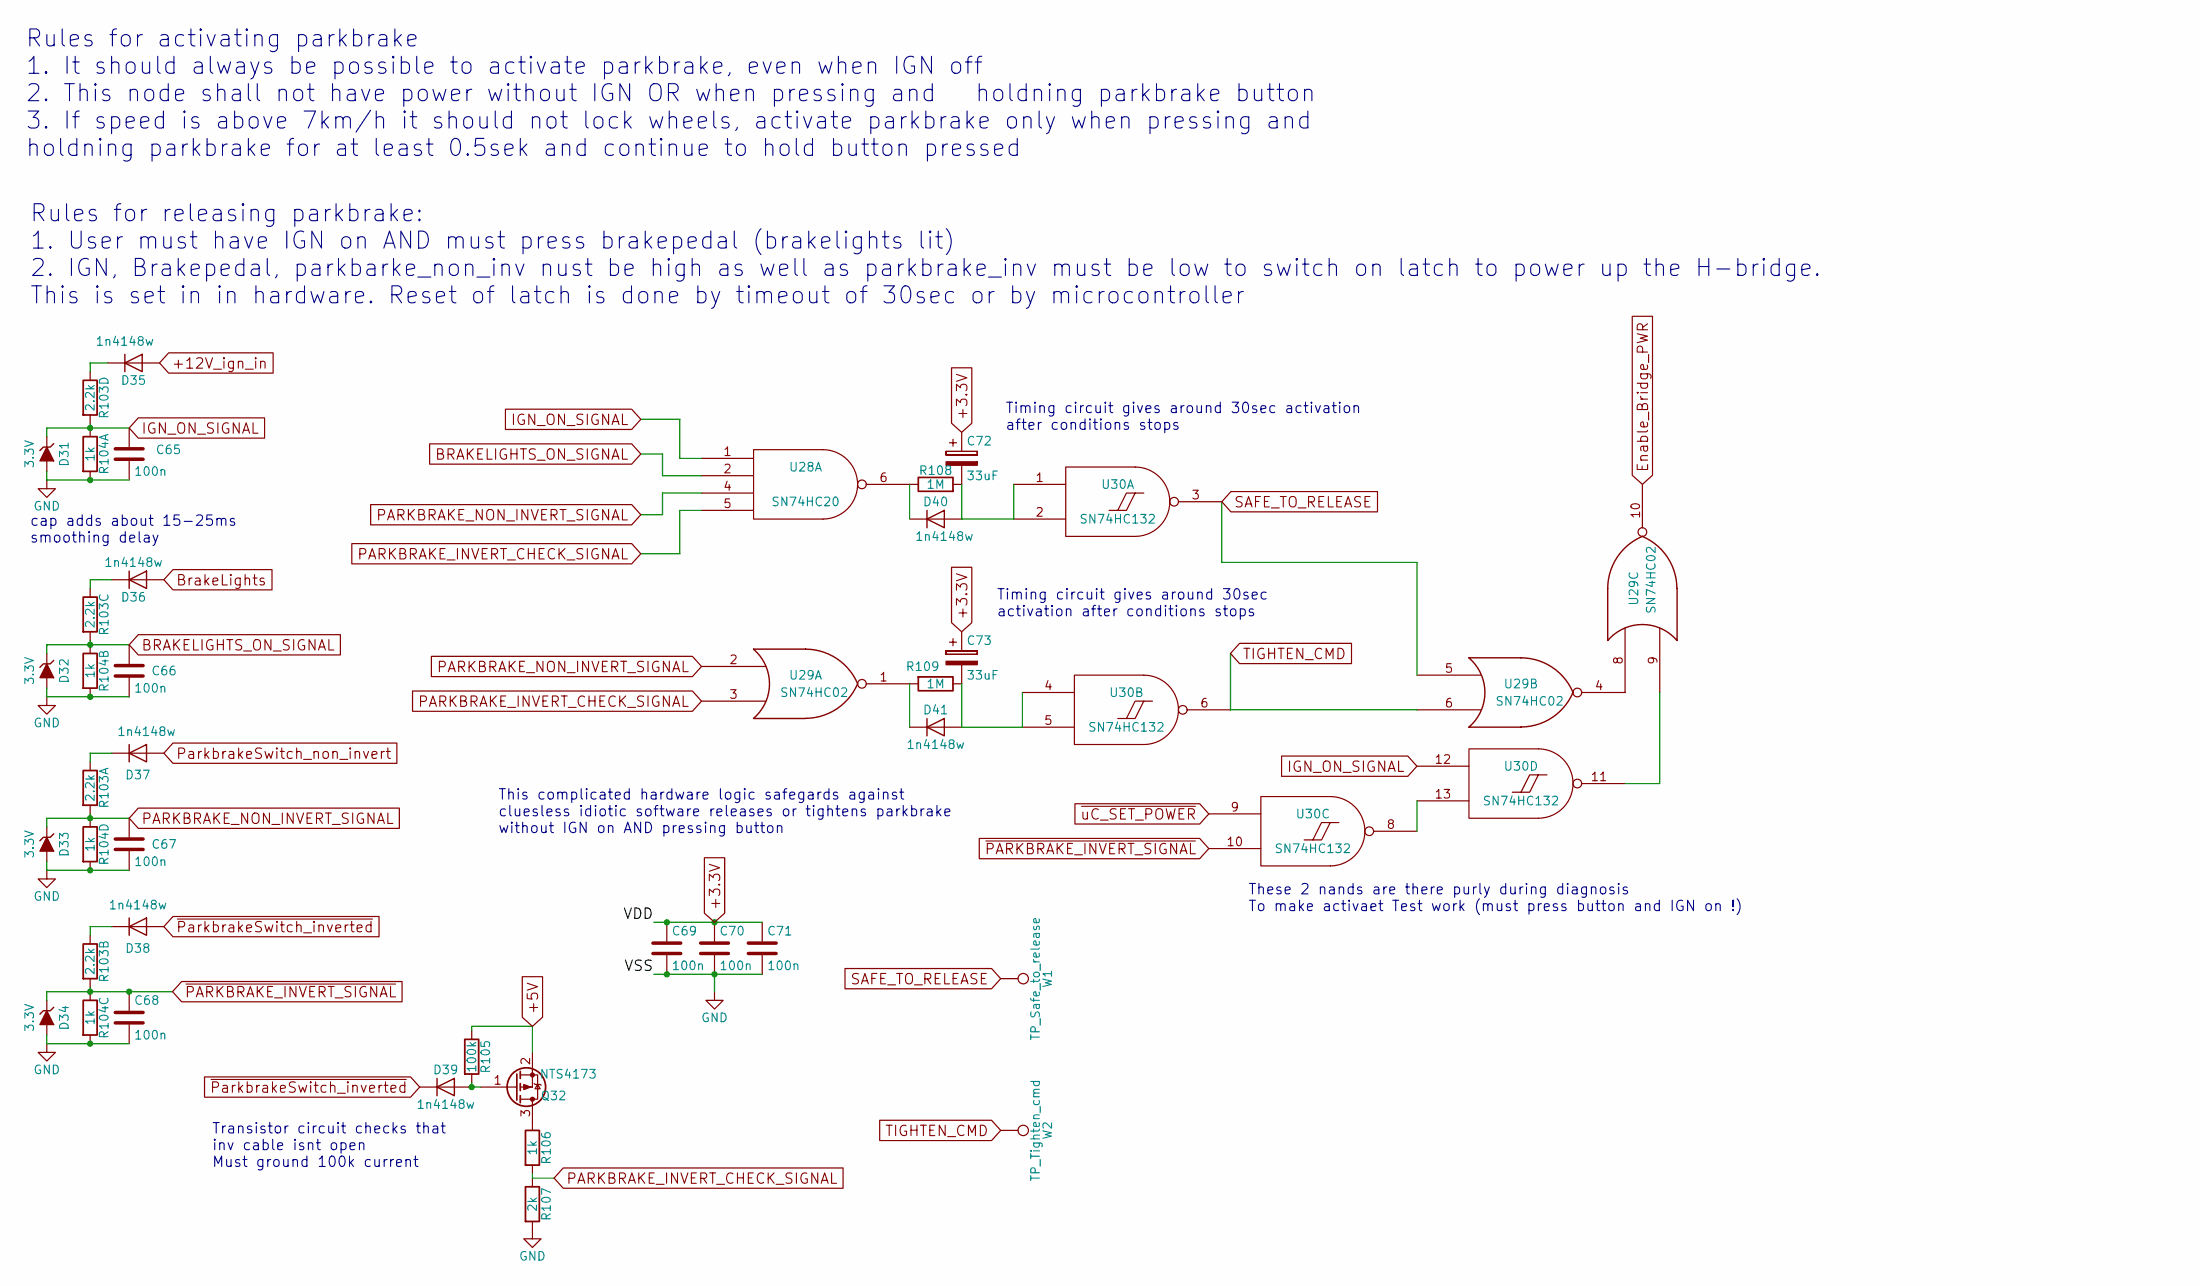
[picture p6: schematic buttonlogic.sch]

Parts:
C65, C66, C67, C68, C69, C70, C71: 100n; C_0805; part 0805B104J500CT; farnell 2496940
C72, C73: 33uF; CP_1206; part 293D336X96R3A2TE3; farnell 1754149
D31, D32, D33, D34: 3.3V; SOD-323; part MM3Z3V3ST1G; farnell 2463489
D35, D36, D37, D38, D39, D40, D41: 1n4148w; SOD-323; part 1N4148WS; farnell 1466524
Q32: NTS4173; SOT-323; part NTS4173PT1G; farnell 2533203
R103: 2.2k; R_Array_Concave_4x0603; part EXB38V222JV; farnell 2060102
R104: 1k; R_Array_Concave_4x0603; part EXB38V102JV; farnell 2060100
R105: 100k; R_0805; part MC01W08051100K; farnell 9332405
R106: 1k; R_0805; part MC01W080511K; farnell 9332383
R107: 2k; R_0805; part MC01W080512K; farnell 9332766
R108, R109: 1M; R_0805; part MC01W080511M; farnell 9332413
U28: SN74HC20; TSSOP-14_4.4x5mm_Pitch0.65mm; part SN74HC20PW; farnell 1741207
U29: SN74HC02; TSSOP-14_4.4x5mm_Pitch0.65mm; part SN74HC02PWR; farnell 9590927
U30: SN74HC132; TSSOP-14_4.4x5mm_Pitch0.65mm; part SN74HC132PWR; farnell 2342491
W1: TP_Safe_to_release; Measurement_Point_Round-SMD-Pad_Small
W2: TP_Tighten_cmd; Measurement_Point_Round-SMD-Pad_Small

Connections:
+3.3V: C69.1, C70.1, C71.1, C72.1, C73.1, U28.14 (VCC), U29.14 (VCC), U30.14 (VCC); also elsewhere on the board
+5V: Q32.2 (S), R105.1; also elsewhere on the board
+12V_ign_in: D35.2 (A); also elsewhere on the board
BRAKELIGHTS_ON_SIGNAL: C66.1, D32.1 (K), R103.6, R104.2, U28.2; also elsewhere on the board
BrakeLights: D36.2 (A); also elsewhere on the board
Enable_Bridge_PWR: U29.10; also elsewhere on the board
IGN_ON_SIGNAL: C65.1, D31.1 (K), R103.5, R104.1, U28.1, U30.12; also elsewhere on the board
LR_wheelsensor_in-: C65.2, C66.2, C67.2, C68.2, C69.2, C70.2, C71.2, D31.2 (A), D32.2 (A), D33.2 (A), D34.2 (A), R104.5, R104.6, R104.7, R104.8, R107.2, U28.7 (GND), U29.7 (GND), U30.7 (GND); also elsewhere on the board
unnamed: C72.2, D40.2 (A), R108.2, U30.1, U30.2
unnamed: C73.2, D41.2 (A), R109.1, U30.4, U30.5
unnamed: D35.1 (K), R103.4
unnamed: D36.1 (K), R103.3
unnamed: D37.1 (K), R103.1
unnamed: D38.1 (K), R103.2
unnamed: D39.2 (A), Q32.1 (G), R105.2
unnamed: D40.1 (K), R108.1, U28.6
unnamed: D41.1 (K), R109.2, U29.1
unnamed: Q32.3 (D), R106.1
unnamed: U29.4, U29.8
unnamed: U29.9, U30.11
unnamed: U30.8, U30.13
PARKBRAKE_INVERT_CHECK_SIGNAL: R106.2, R107.1, U28.5, U29.3
PARKBRAKE_NON_INVERT_SIGNAL: C67.1, D33.1 (K), R103.8, R104.4, U28.4, U29.2; also elsewhere on the board
ParkbrakeSwitch_non_invert: D37.2 (A); also elsewhere on the board
SAFE_TO_RELEASE: U29.5, U30.3, W1.1; also elsewhere on the board
TIGHTEN_CMD: U29.6, U30.6, W2.1; also elsewhere on the board
~PARKBRAKE_INVERT_SIGNAL: C68.1, D34.1 (K), R103.7, R104.3, U30.10; also elsewhere on the board
~ParkbrakeSwitch_inverted: D38.2 (A), D39.1 (K); also elsewhere on the board
~uC_SET_POWER: U30.9; also elsewhere on the board

Notes on the sheet:
Rules for activating parkbrake 1. It should always be possible to activate parkbrake, even when IGN off 2. This node shall not have power without IGN OR when pressing and holdning parkbrake button 3. If speed is above 7km/h it should not lock wheels, activate parkbrake only when pressing and holdni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
Rules for releasing parkbrake: 1. User must have IGN on AND must press brakepedal (brakelights lit) 2. IGN, Brakepedal, parkbarke_non_inv nust be high as well as parkbrake_inv must be low to switch on latch to power up the H-bridge. This is set in in hardware. Reset of latch is done by timeout of 3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
cap adds about 15-25ms smoothing delay
Transistor circuit checks that inv cable isnt open Must ground 100k current
Timing circuit gives around 30sec activation after conditions stops
Timing circuit gives around 30sec activation after conditions stops
This complicated hardware logic safegards against cluesless idiotic software releases or tightens parkbrake without IGN on AND pressing button
These 2 nands are there purly during diagnosis To make activaet Test work (must press button and IGN on !)

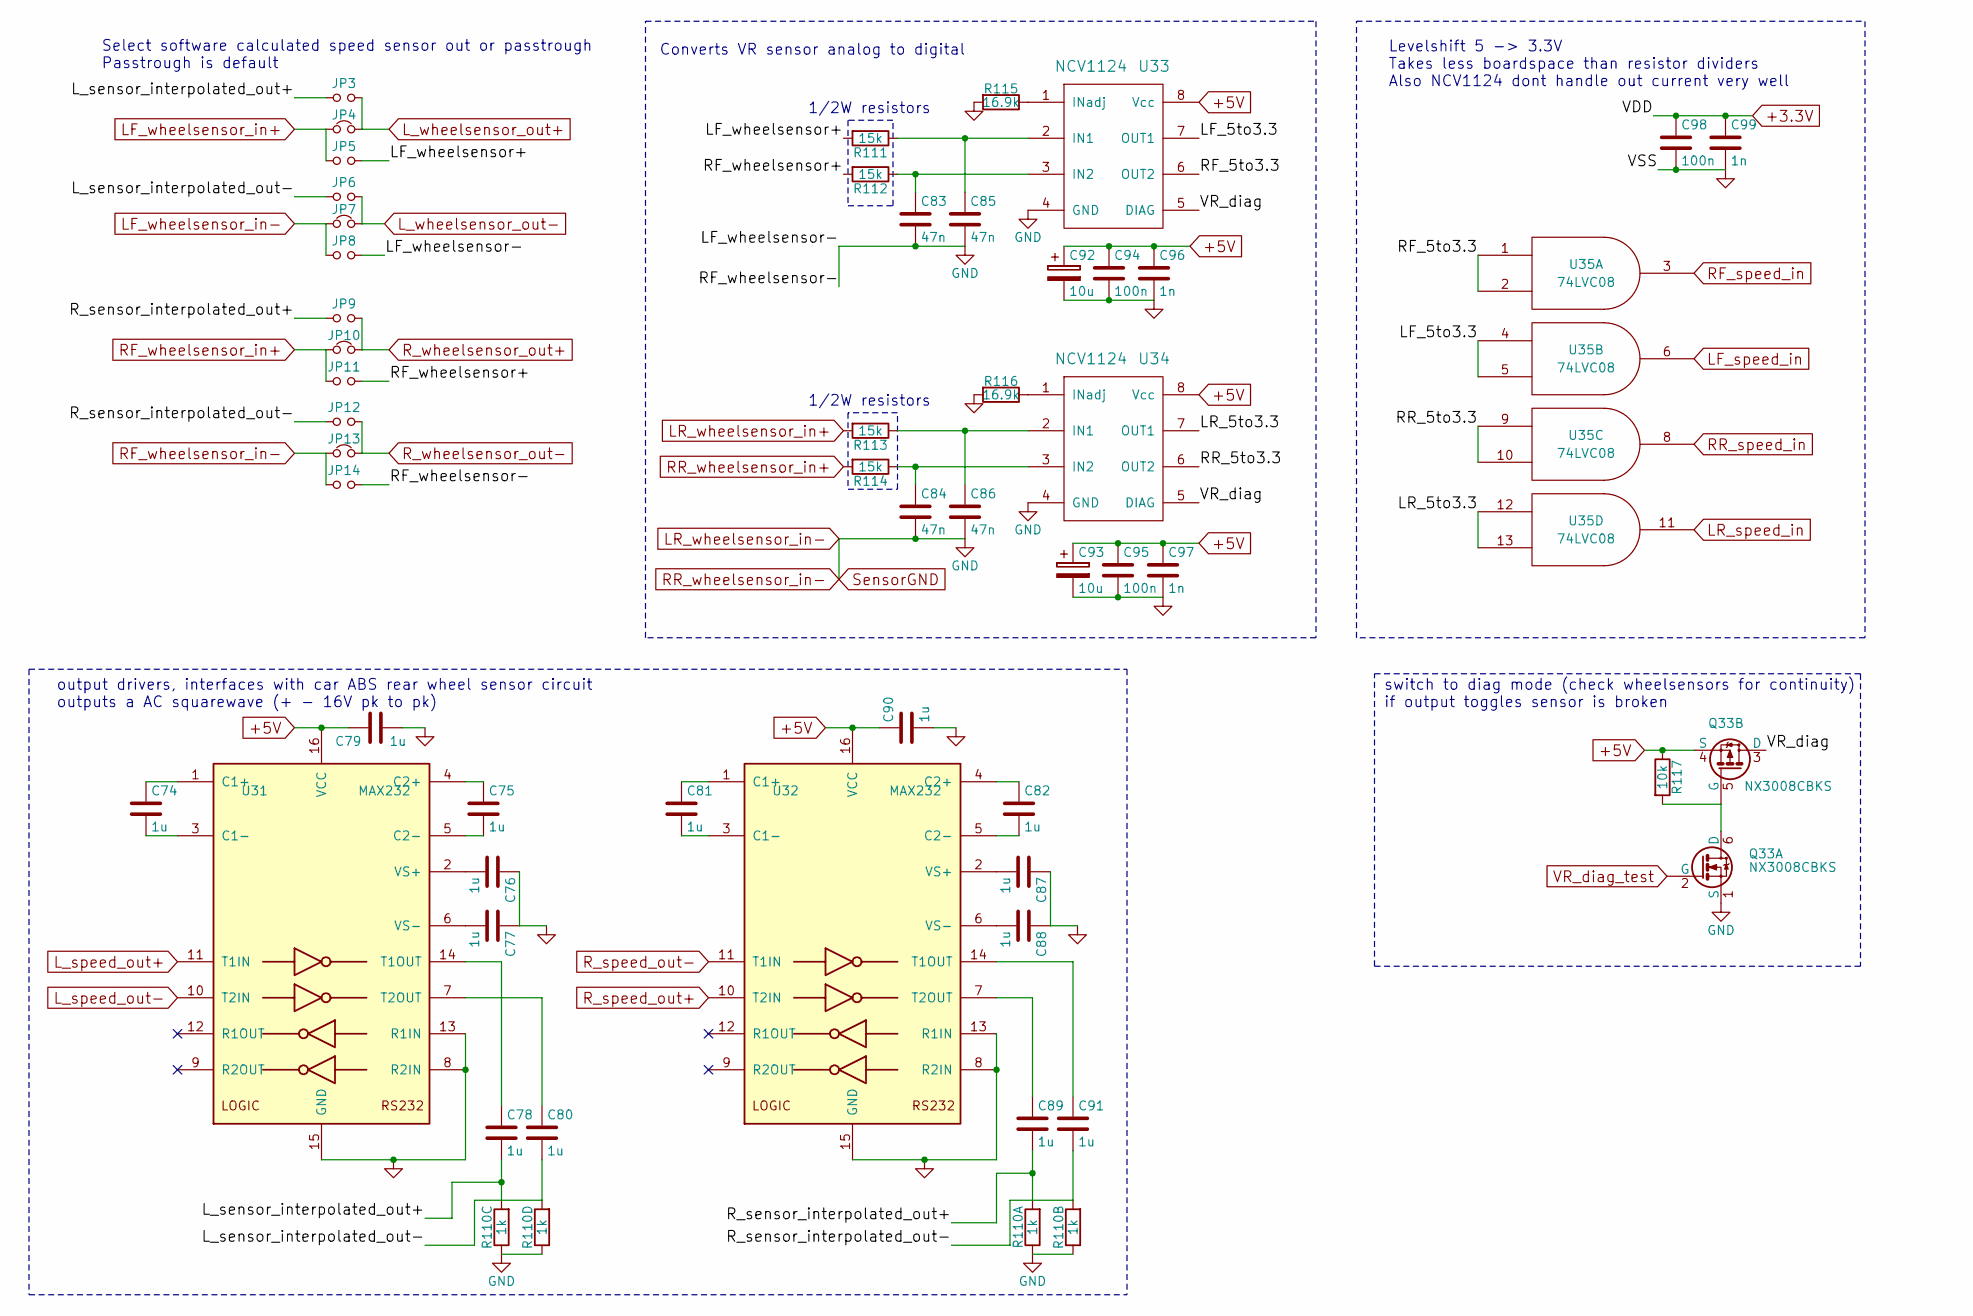
[picture p7: schematic wheelsensors.sch]

Parts:
C74, C75, C76, C77, C78, C79, C80, C81, C82, C87, C88, C89, C90, C91: 1u; C_1206; part GRM31MR71E105JA01L; farnell 2362126
C83, C84, C85, C86: 47n; C_0805; part 0805B473J500CT; farnell 2496981
C92, C93: 10u; CP_0805; part TMCP0J106KTRF; farnell 2491430
C94, C95, C98: 100n; C_0805; part 0805B104J500CT; farnell 2496940
C96, C97, C99: 1n; C_0805; part GRM2165C1H102JA01D; farnell 2494247
JP3: soft_L_out+; R_0805_HandSoldering; part RC1206JR-070RL; farnell 9240276
JP4: L_passth+; R_0805_HandSoldering; part RC1206JR-070RL; farnell 9240276
JP5: LF+_to_in; R_0805_HandSoldering; part RC1206JR-070RL; farnell 9240276
JP6: soft_L_out-; R_0805_HandSoldering; part RC1206JR-070RL; farnell 9240276
JP7: L_passth-; R_0805_HandSoldering; part RC1206JR-070RL; farnell 9240276
JP8: LF-_to_in; R_0805_HandSoldering; part RC1206JR-070RL; farnell 9240276
JP9: soft_R_out+; R_0805_HandSoldering; part RC1206JR-070RL; farnell 9240276
JP10: RF_passth+; R_0805_HandSoldering; part RC1206JR-070RL; farnell 9240276
JP11: RF+_to_in; R_0805_HandSoldering; part RC1206JR-070RL; farnell 9240276
JP12: soft_R_out-; R_0805_HandSoldering; part RC1206JR-070RL; farnell 9240276
JP13: RF_passth-; R_0805_HandSoldering; part RC1206JR-070RL; farnell 9240276
JP14: RF-_to_in; R_0805_HandSoldering; part RC1206JR-070RL; farnell 9240276
Q33: NX3008CBKS; SOT-363; part NX3008CBKS; farnell 2069539
R110: 1k; R_Array_Concave_4x0603; part EXB38V102JV; farnell 2060100
R111, R112, R113, R114: 15k; R_0805; part ERJP06F1502V; farnell 1750772
R115, R116: 16.9k; R_0805; part MC01W0805116K9; farnell 2141858
R117: 10k; R_0805; part MC01W0805110K; farnell 9332391
U31, U32: MAX232; TSSOP-16_4.4x5mm_Pitch0.65mm; part MAX202IPW; farnell 2335478
U33, U34: NCV1124; SOIC-8_3.9x4.9mm_Pitch1.27mm; part NCV1124DR2G; farnell 2534601
U35: 74LVC08; TSSOP-14_4.4x5mm_Pitch0.65mm; part 74LVC08APW-Q100.11; farnell 2445097

Connections:
+3.3V: C98.1, C99.1, U35.14 (VCC); also elsewhere on the board
+5V: C79.1, C90.1, C92.1, C93.1, C94.1, C95.1, C96.1, C97.1, Q33.4 (S), R117.1, U31.16 (VCC), U32.16 (VCC), U33.8 (Vcc), U34.8 (Vcc); also elsewhere on the board
/Wheelsensors/LF_5to3.3: U33.7 (OUT1), U35.4, U35.5
/Wheelsensors/LF_wheelsensor+: JP5.2, R111.2
/Wheelsensors/LR_5to3.3: U34.7 (OUT1), U35.12, U35.13
/Wheelsensors/L_sensor_interpolated_out+: C78.2, JP3.1, R110.6
/Wheelsensors/L_sensor_interpolated_out-: C80.2, JP6.1, R110.5
/Wheelsensors/RF_5to3.3: U33.6 (OUT2), U35.1, U35.2
/Wheelsensors/RF_wheelsensor+: JP11.2, R112.2
/Wheelsensors/RR_5to3.3: U34.6 (OUT2), U35.9, U35.10
/Wheelsensors/R_sensor_interpolated_out+: C89.2, JP9.1, R110.8
/Wheelsensors/R_sensor_interpolated_out-: C91.2, JP12.1, R110.7
/Wheelsensors/VR_diag: Q33.3 (D), U33.5 (DIAG), U34.5 (DIAG)
LF_speed_in: U35.6; also elsewhere on the board
LF_wheelsensor_in+: JP4.1, JP5.1; also elsewhere on the board
LF_wheelsensor_in-: JP7.1, JP8.1; also elsewhere on the board
LR_speed_in: U35.11; also elsewhere on the board
LR_wheelsensor_in+: R113.2; also elsewhere on the board
LR_wheelsensor_in-: C76.1, C77.1, C79.2, C83.2, C84.2, C85.2, C86.2, C87.1, C88.1, C90.2, C92.2, C93.2, C94.2, C95.2, C96.2, C97.2, C98.2, C99.2, JP8.2, JP14.2, Q33.1 (S), R110.1, R110.2, R110.3, R110.4, R115.2, R116.2, U31.8 (R2IN), U31.13 (R1IN), U31.15 (GND), U32.8 (R2IN), U32.13 (R1IN), U32.15 (GND), U33.4 (GND), U34.4 (GND), U35.7 (GND); also elsewhere on the board
L_speed_out+: U31.11 (T1IN); also elsewhere on the board
L_speed_out-: U31.10 (T2IN); also elsewhere on the board
L_wheelsensor_out+: JP3.2, JP4.2; also elsewhere on the board
L_wheelsensor_out-: JP6.2, JP7.2; also elsewhere on the board
unnamed: C74.1, U31.1 (C1+)
unnamed: C74.2, U31.3 (C1-)
unnamed: C75.1, U31.4 (C2+)
unnamed: C75.2, U31.5 (C2-)
unnamed: C76.2, U31.2 (VS+)
unnamed: C77.2, U31.6 (VS-)
unnamed: C78.1, U31.14 (T1OUT)
unnamed: C80.1, U31.7 (T2OUT)
unnamed: C81.1, U32.1 (C1+)
unnamed: C81.2, U32.3 (C1-)
unnamed: C82.1, U32.4 (C2+)
unnamed: C82.2, U32.5 (C2-)
unnamed: C83.1, R112.1, U33.3 (IN2)
unnamed: C84.1, R114.1, U34.3 (IN2)
unnamed: C85.1, R111.1, U33.2 (IN1)
unnamed: C86.1, R113.1, U34.2 (IN1)
unnamed: C87.2, U32.2 (VS+)
unnamed: C88.2, U32.6 (VS-)
unnamed: C89.1, U32.7 (T2OUT)
unnamed: C91.1, U32.14 (T1OUT)
unnamed: Q33.5 (G), Q33.6 (D), R117.2
unnamed: R115.1, U33.1 (INadj)
unnamed: R116.1, U34.1 (INadj)
RF_speed_in: U35.3; also elsewhere on the board
RF_wheelsensor_in+: JP10.1, JP11.1; also elsewhere on the board
RF_wheelsensor_in-: JP13.1, JP14.1; also elsewhere on the board
RR_speed_in: U35.8; also elsewhere on the board
RR_wheelsensor_in+: R114.2; also elsewhere on the board
R_speed_out+: U32.10 (T2IN); also elsewhere on the board
R_speed_out-: U32.11 (T1IN); also elsewhere on the board
R_wheelsensor_out+: JP9.2, JP10.2; also elsewhere on the board
R_wheelsensor_out-: JP12.2, JP13.2; also elsewhere on the board
VR_diag_test: Q33.2 (G); also elsewhere on the board

Notes on the sheet:
Select software calculated speed sensor out or passtrough Passtrough is default
1/2W resistors
output drivers, interfaces with car ABS rear wheel sensor circuit outputs a AC squarewave (+ - 16V pk to pk)
Converts VR sensor analog to digital
switch to diag mode (check wheelsensors for continuity) if output toggles sensor is broken
Levelshift 5 -> 3.3V Takes less boardspace than resistor dividers Also NCV1124 dont handle out current very well

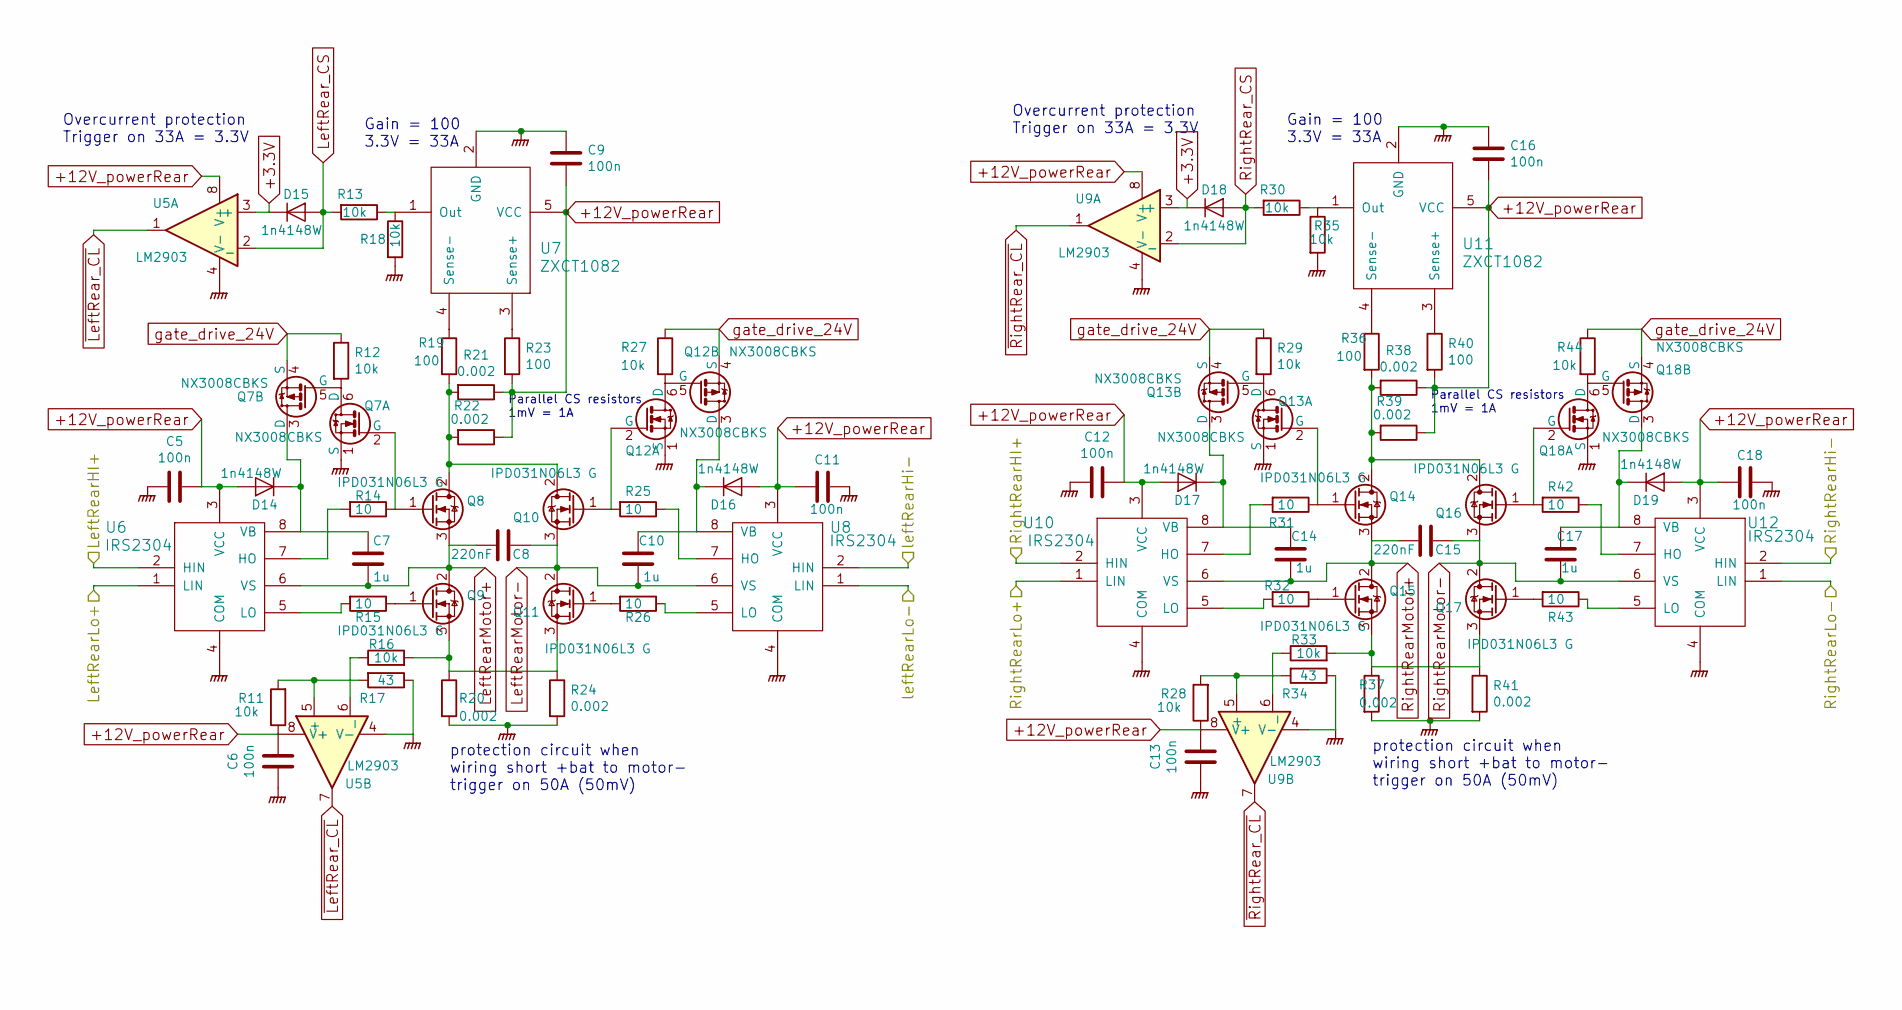
[picture p8: schematic H-BridgeRear.sch]

Parts:
C5, C6, C9, C11, C12, C13, C16, C18: 100n; C_0805; part 0805B104J500CT; farnell 2496940
C7, C10, C14, C17: 1u; C_1206; part GRM31MR71E105JA01L; farnell 2362126
C8, C15: 220nF; C_1206; part 1206B224J500CT; farnell 2497088
D14, D15, D16, D17, D18, D19: 1n4148W; SOD-323; part 1N4148WS; farnell 1466524
Q7, Q12, Q13, Q18: NX3008CBKS; SOT-363; part NX3008CBKS; farnell 2069539
Q8, Q9, Q10, Q11, Q14, Q15, Q16, Q17: IPD031N06L3 G; TO-252-2Lead; part IPD031N06L3 G; farnell 2480814
R11, R12, R13, R16, R18, R27, R28, R29, R30, R33, R35, R44: 10k; R_0805; part MC01W0805110K; farnell 9332391
R14, R15, R25, R26, R31, R32, R42, R43: 10; R_0805; part WF08P10R0FTL; farnell 2502783
R17, R34: 43; R_0805; part MC01W0805143R; farnell 9333240
R19, R23, R36, R40: 100; R_0805; part MC01W08051100R; farnell 9332375
R20, R21, R22, R24, R37, R38, R39, R41: 0.002; R_1206; part ULR1S-R002FT2; farnell 1621962
U5, U9: LM2903; TSSOP-8_4.4x3mm_Pitch0.65mm; part LM2903PT; farnell 1094243
U6, U8, U10, U12: IRS2304; SOIC-8_3.9x4.9mm_Pitch1.27mm; part IRS2304SPBF; farnell 1498208
U7, U11: ZXCT1082; SOT-23-5; part ZXCT1082E5TA; farnell 1904025

Connections:
+3.3V: D15.1 (K), D18.1 (K), U5.3 (+), U9.3 (+); also elsewhere on the board
+12V_powerRear: C5.1, C6.1, C9.2, C11.2, C12.1, C13.1, C16.2, C18.2, D14.2 (A), D16.2 (A), D17.2 (A), D19.2 (A), R11.1, R21.1, R22.1, R23.2, R28.1, R38.1, R39.1, R40.2, U5.8 (V+), U6.3 (VCC), U7.5 (VCC), U8.3 (VCC), U9.8 (V+), U10.3 (VCC), U11.5 (VCC), U12.3 (VCC); also elsewhere on the board
/H-Bridge_logic/H-BridgeRear/LeftRearHI+: U6.2 (HIN), U8.1 (LIN); also elsewhere on the board
/H-Bridge_logic/H-BridgeRear/LeftRearLo+: U6.1 (LIN), U8.2 (HIN); also elsewhere on the board
/H-Bridge_logic/H-BridgeRear/RightRearHI+: U10.2 (HIN), U12.1 (LIN); also elsewhere on the board
/H-Bridge_logic/H-BridgeRear/RightRearHi-: U10.1 (LIN), U12.2 (HIN); also elsewhere on the board
GNDPWR: C5.2, C6.2, C9.1, C11.1, C12.2, C13.2, C16.1, C18.1, Q7.1 (S), Q12.1 (S), Q13.1 (S), Q18.1 (S), R17.1, R18.2, R20.2, R24.2, R34.1, R35.2, R37.2, R41.2, U5.4 (V-), U6.4 (COM), U7.2 (GND), U8.4 (COM), U9.4 (V-), U10.4 (COM), U11.2 (GND), U12.4 (COM); also elsewhere on the board
LeftRearMotor+: C7.1, C8.2, Q8.3 (S), Q9.2 (D), U6.6 (VS); also elsewhere on the board
LeftRearMotor-: C8.1, C10.1, Q10.3 (S), Q11.2 (D), U8.6 (VS); also elsewhere on the board
LeftRear_CS: D15.2 (A), R13.2, U5.2 (_); also elsewhere on the board
unnamed: C7.2, D14.1 (K), Q7.3 (D), U6.8 (VB)
unnamed: C10.2, D16.1 (K), Q12.3 (D), U8.8 (VB)
unnamed: C14.2, D17.1 (K), Q13.3 (D), U10.8 (VB)
unnamed: C17.1, D19.1 (K), Q18.3 (D), U12.8 (VB)
unnamed: Q7.2 (G), Q8.1 (G), R14.1
unnamed: Q7.5 (G), Q7.6 (D), R12.2
unnamed: Q9.1 (G), R15.1
unnamed: Q10.1 (G), Q12.2 (G), R25.2
unnamed: Q8.2 (D), Q10.2 (D), R19.2, R21.2, R22.2
unnamed: Q11.1 (G), R26.2
unnamed: Q9.3 (S), Q11.3 (S), R16.2, R20.1, R24.1
unnamed: Q12.5 (G), Q12.6 (D), R27.2
unnamed: Q13.2 (G), Q14.1 (G), R31.1
unnamed: Q13.5 (G), Q13.6 (D), R29.2
unnamed: Q14.2 (D), Q16.2 (D), R36.2, R38.2, R39.2
unnamed: Q15.1 (G), R32.1
unnamed: Q15.3 (S), Q17.3 (S), R33.2, R37.1, R41.1
unnamed: Q16.1 (G), Q18.2 (G), R42.2
unnamed: Q17.1 (G), R43.2
unnamed: Q18.5 (G), Q18.6 (D), R44.2
unnamed: R11.2, R17.2, U5.5 (+)
unnamed: R13.1, R18.1, U7.1 (Out)
unnamed: R14.2, U6.7 (HO)
unnamed: R15.2, U6.5 (LO)
unnamed: R16.1, U5.6 (_)
unnamed: R19.1, U7.4 (Sense-)
unnamed: R23.1, U7.3 (Sense+)
unnamed: R25.1, U8.7 (HO)
unnamed: R26.1, U8.5 (LO)
unnamed: R28.2, R34.2, U9.5 (+)
unnamed: R30.1, R35.1, U11.1 (Out)
unnamed: R31.2, U10.7 (HO)
unnamed: R32.2, U10.5 (LO)
unnamed: R33.1, U9.6 (_)
unnamed: R36.1, U11.4 (Sense-)
unnamed: R40.1, U11.3 (Sense+)
unnamed: R42.1, U12.7 (HO)
unnamed: R43.1, U12.5 (LO)
RightRearMotor+: C14.1, C15.2, Q14.3 (S), Q15.2 (D), U10.6 (VS); also elsewhere on the board
RightRearMotor-: C15.1, C17.2, Q16.3 (S), Q17.2 (D), U12.6 (VS); also elsewhere on the board
RightRear_CS: D18.2 (A), R30.2, U9.2 (_); also elsewhere on the board
gate_drive_24V: Q7.4 (S), Q12.4 (S), Q13.4 (S), Q18.4 (S), R12.1, R27.1, R29.1, R44.1; also elsewhere on the board
~LeftRear_CL: U5.1, U5.7; also elsewhere on the board
~RightRear_CL: U9.1, U9.7; also elsewhere on the board

Notes on the sheet:
Parallel CS resistors 1mV = 1A
protection circuit when wiring short +bat to motor- trigger on 50A (50mV)
Gain = 100 3.3V = 33A
Overcurrent protection Trigger on 33A = 3.3V

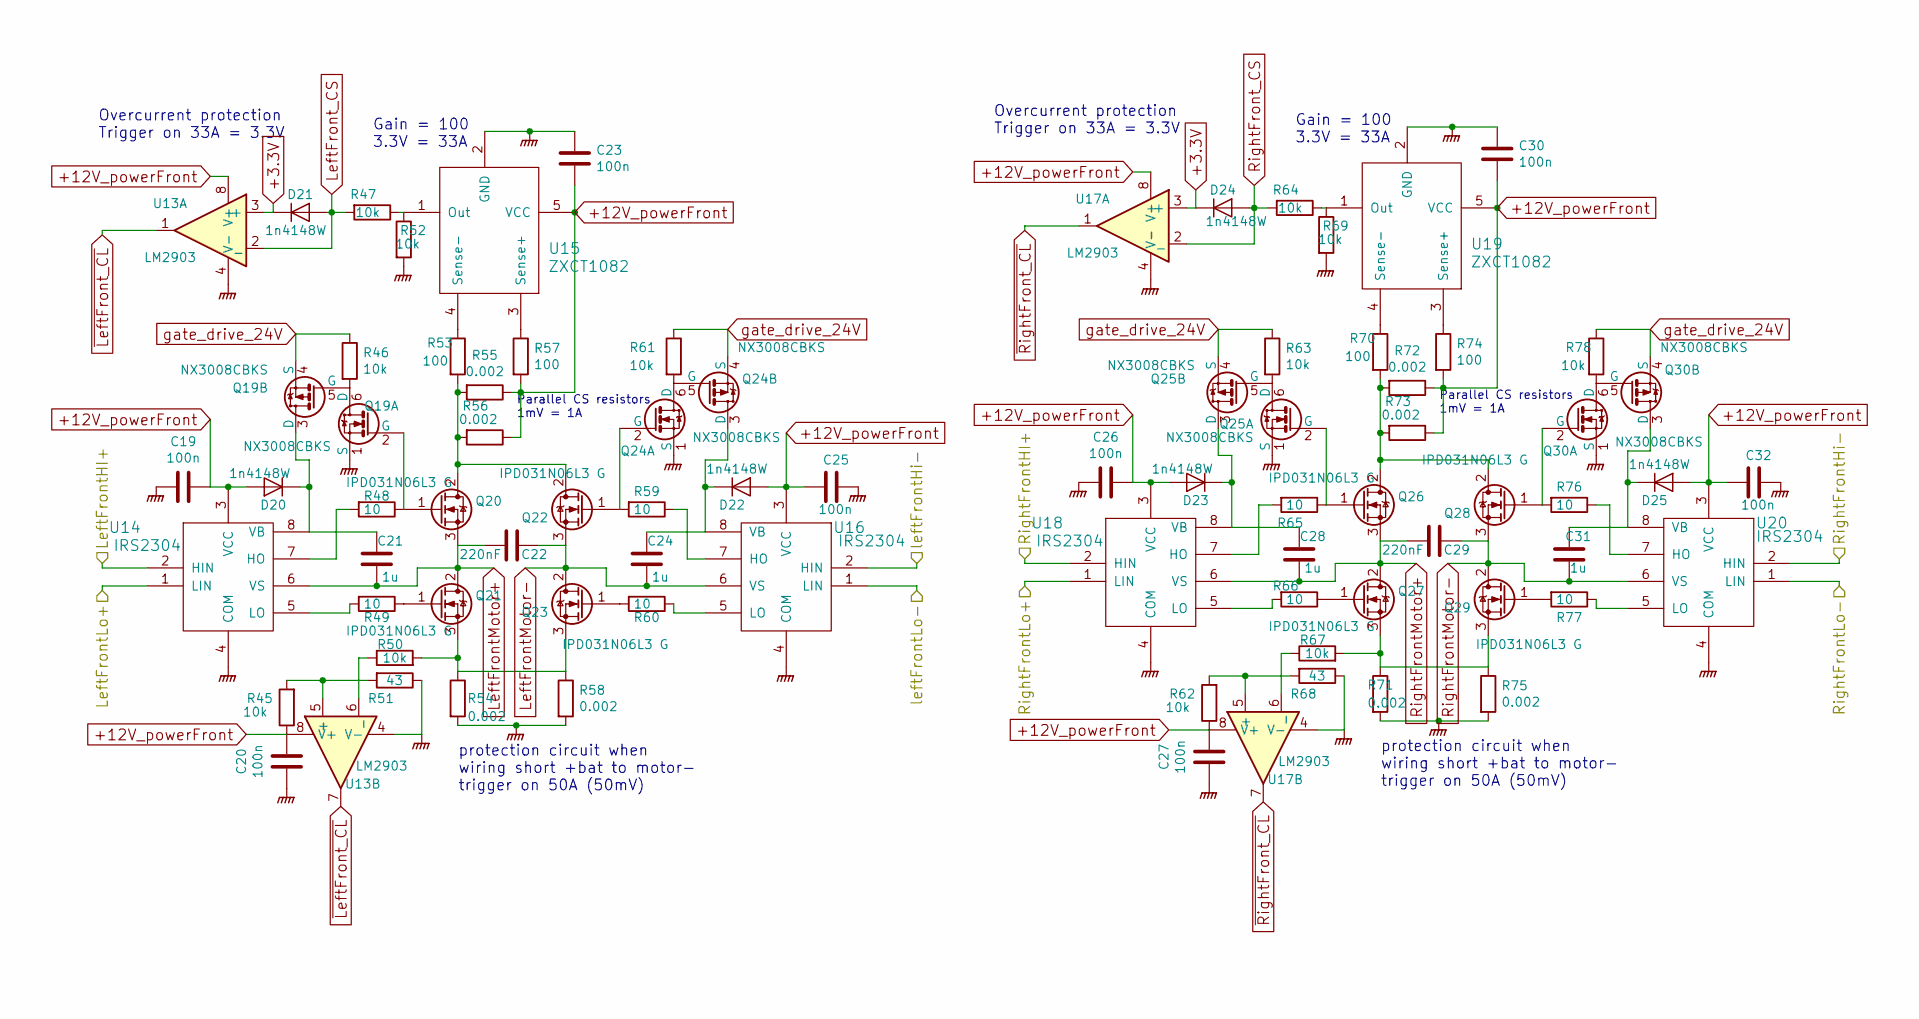
[picture p9: schematic H-BridgeFront.sch]

Parts:
C19, C20, C23, C25, C26, C27, C30, C32: 100n; C_0805; part 0805B104J500CT; farnell 2496940
C21, C24, C28, C31: 1u; C_1206; part GRM31MR71E105JA01L; farnell 2362126
C22, C29: 220nF; C_1206; part 1206B224J500CT; farnell 2497088
D20, D21, D22, D25: 1n4148W; SOD-323; part 1N4148WS; farnell 1466524
D23, D24: 1n4148W; SOD-323; part 1N4148WS; farnell 2433353
Q19, Q24, Q25, Q30: NX3008CBKS; SOT-363; part NX3008CBKS; farnell 2069539
Q20, Q21, Q22, Q23, Q26, Q27, Q28, Q29: IPD031N06L3 G; TO-252-2Lead; part IPD031N06L3 G; farnell 2480814
R45, R46, R47, R50, R52, R61, R62, R63, R64, R67, R69, R78: 10k; R_0805; part MC01W0805110K; farnell 9332391
R48, R49, R59, R60, R65, R66, R76, R77: 10; R_0805; part WF08P10R0FTL; farnell 2502783
R51, R68: 43; R_0805; part MC01W0805143R; farnell 9333240
R53, R57, R70, R74: 100; R_0805; part MC01W08051100R; farnell 9332375
R54, R55, R56, R58, R71, R72, R73, R75: 0.002; R_1206; part ULR1S-R002FT2; farnell 1621962
U13, U17: LM2903; TSSOP-8_4.4x3mm_Pitch0.65mm; part LM2903PT; farnell 1094243
U14, U16, U18, U20: IRS2304; SOIC-8_3.9x4.9mm_Pitch1.27mm; part IRS2304SPBF; farnell 1498208
U15, U19: ZXCT1082; SOT-23-5; part ZXCT1082E5TA; farnell 1904025

Connections:
+3.3V: D21.1 (K), D24.1 (K), U13.3 (+), U17.3 (+); also elsewhere on the board
+12V_powerFront: C19.1, C20.1, C23.2, C25.2, C26.1, C27.1, C30.2, C32.2, D20.2 (A), D22.2 (A), D23.2 (A), D25.2 (A), R45.1, R55.1, R56.1, R57.2, R62.1, R72.1, R73.1, R74.2, U13.8 (V+), U14.3 (VCC), U15.5 (VCC), U16.3 (VCC), U17.8 (V+), U18.3 (VCC), U19.5 (VCC), U20.3 (VCC); also elsewhere on the board
/H-Bridge_logic/H-BridgeFront/LeftFrontHI+: U14.2 (HIN), U16.1 (LIN); also elsewhere on the board
/H-Bridge_logic/H-BridgeFront/LeftFrontLo+: U14.1 (LIN), U16.2 (HIN); also elsewhere on the board
/H-Bridge_logic/H-BridgeFront/RightFrontHI+: U18.2 (HIN), U20.1 (LIN); also elsewhere on the board
/H-Bridge_logic/H-BridgeFront/RightFrontHi-: U18.1 (LIN), U20.2 (HIN); also elsewhere on the board
GNDPWR: C19.2, C20.2, C23.1, C25.1, C26.2, C27.2, C30.1, C32.1, Q19.1 (S), Q24.1 (S), Q25.1 (S), Q30.1 (S), R51.1, R52.2, R54.2, R58.2, R68.1, R69.2, R71.2, R75.2, U13.4 (V-), U14.4 (COM), U15.2 (GND), U16.4 (COM), U17.4 (V-), U18.4 (COM), U19.2 (GND), U20.4 (COM); also elsewhere on the board
LeftFrontMotor+: C21.1, C22.2, Q20.3 (S), Q21.2 (D), U14.6 (VS); also elsewhere on the board
LeftFrontMotor-: C22.1, C24.1, Q22.3 (S), Q23.2 (D), U16.6 (VS); also elsewhere on the board
LeftFront_CS: D21.2 (A), R47.2, U13.2 (_); also elsewhere on the board
unnamed: C21.2, D20.1 (K), Q19.3 (D), U14.8 (VB)
unnamed: C24.2, D22.1 (K), Q24.3 (D), U16.8 (VB)
unnamed: C28.2, D23.1 (K), Q25.3 (D), U18.8 (VB)
unnamed: C31.1, D25.1 (K), Q30.3 (D), U20.8 (VB)
unnamed: Q19.2 (G), Q20.1 (G), R48.1
unnamed: Q19.5 (G), Q19.6 (D), R46.2
unnamed: Q20.2 (D), Q22.2 (D), R53.2, R55.2, R56.2
unnamed: Q21.1 (G), R49.1
unnamed: Q21.3 (S), Q23.3 (S), R50.2, R54.1, R58.1
unnamed: Q22.1 (G), Q24.2 (G), R59.2
unnamed: Q23.1 (G), R60.2
unnamed: Q24.5 (G), Q24.6 (D), R61.2
unnamed: Q25.2 (G), Q26.1 (G), R65.1
unnamed: Q25.5 (G), Q25.6 (D), R63.2
unnamed: Q26.2 (D), Q28.2 (D), R70.2, R72.2, R73.2
unnamed: Q27.1 (G), R66.1
unnamed: Q27.3 (S), Q29.3 (S), R67.2, R71.1, R75.1
unnamed: Q28.1 (G), Q30.2 (G), R76.2
unnamed: Q29.1 (G), R77.2
unnamed: Q30.5 (G), Q30.6 (D), R78.2
unnamed: R45.2, R51.2, U13.5 (+)
unnamed: R47.1, R52.1, U15.1 (Out)
unnamed: R48.2, U14.7 (HO)
unnamed: R49.2, U14.5 (LO)
unnamed: R50.1, U13.6 (_)
unnamed: R53.1, U15.4 (Sense-)
unnamed: R57.1, U15.3 (Sense+)
unnamed: R59.1, U16.7 (HO)
unnamed: R60.1, U16.5 (LO)
unnamed: R62.2, R68.2, U17.5 (+)
unnamed: R64.1, R69.1, U19.1 (Out)
unnamed: R65.2, U18.7 (HO)
unnamed: R66.2, U18.5 (LO)
unnamed: R67.1, U17.6 (_)
unnamed: R70.1, U19.4 (Sense-)
unnamed: R74.1, U19.3 (Sense+)
unnamed: R76.1, U20.7 (HO)
unnamed: R77.1, U20.5 (LO)
RightFrontMotor+: C28.1, C29.2, Q26.3 (S), Q27.2 (D), U18.6 (VS); also elsewhere on the board
RightFrontMotor-: C29.1, C31.2, Q28.3 (S), Q29.2 (D), U20.6 (VS); also elsewhere on the board
RightFront_CS: D24.2 (A), R64.2, U17.2 (_); also elsewhere on the board
gate_drive_24V: Q19.4 (S), Q24.4 (S), Q25.4 (S), Q30.4 (S), R46.1, R61.1, R63.1, R78.1; also elsewhere on the board
~LeftFront_CL: U13.1, U13.7; also elsewhere on the board
~RightFront_CL: U17.1, U17.7; also elsewhere on the board

Notes on the sheet:
Parallel CS resistors 1mV = 1A
protection circuit when wiring short +bat to motor- trigger on 50A (50mV)
Gain = 100 3.3V = 33A
Overcurrent protection Trigger on 33A = 3.3V

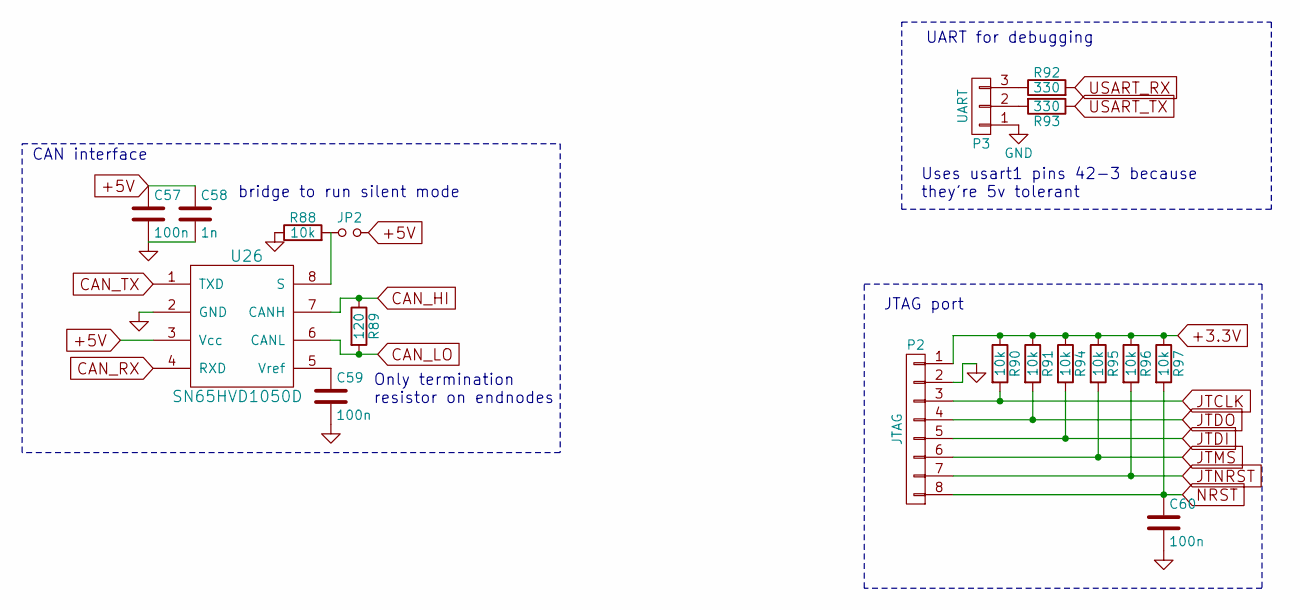
[picture p10: schematic communication_and_debug.sch]

Parts:
C57, C59, C60: 100n; C_0805; part 0805B104J500CT; farnell 2496940
C58: 1n; C_0805; part GRM2165C1H102JA01D; farnell 2494247
JP2: Jumper_NO_Small; R_0805_HandSoldering; part RC1206JR-070RL; farnell 9240276
P2: JTAG; Socket_Strip_Straight_1x08; part 61300811121; farnell 2356160
P3: UART; Socket_Strip_Straight_1x03; part 826629-3; farnell 3418297
R88, R90, R91, R94, R95, R96, R97: 10k; R_0805; part MC01W0805110K; farnell 9332391
R89: 120; R_0805; part MC01W08051120R; farnell 9332480
R92, R93: 330; R_0805; part MC01W08051330R; farnell 9333037
U26: SN65HVD1050D; SOIC-8_3.9x4.9mm_Pitch1.27mm; part SN65HVD1050D; farnell 1220984

Connections:
+3.3V: P2.1, R90.1, R91.1, R94.1, R95.1, R96.1, R97.1; also elsewhere on the board
+5V: C57.1, C58.1, JP2.2, U26.3 (Vcc); also elsewhere on the board
CAN_HI: R89.1, U26.7 (CANH); also elsewhere on the board
CAN_LO: R89.2, U26.6 (CANL); also elsewhere on the board
CAN_RX: U26.4 (RXD); also elsewhere on the board
CAN_TX: U26.1 (TXD); also elsewhere on the board
JTCLK: P2.3, R90.2; also elsewhere on the board
JTDI: P2.5, R94.2; also elsewhere on the board
JTDO: P2.4, R91.2; also elsewhere on the board
JTMS: P2.6, R95.2; also elsewhere on the board
JTNRST: P2.7, R96.2; also elsewhere on the board
LR_wheelsensor_in-: C57.2, C58.2, C59.2, C60.2, P2.2, P3.1, R88.1, U26.2 (GND); also elsewhere on the board
NRST: C60.1, P2.8, R97.2; also elsewhere on the board
unnamed: C59.1, U26.5 (Vref)
unnamed: JP2.1, R88.2, U26.8 (S)
unnamed: P3.2, R93.2
unnamed: P3.3, R92.1
USART_RX: R92.2; also elsewhere on the board
USART_TX: R93.1; also elsewhere on the board

Notes on the sheet:
CAN interface
bridge to run silent mode
Uses usart1 pins 42-3 because they're 5v tolerant
UART for debugging
JTAG port
Only termination resistor on endnodes
