mumme74/CarTransporter/electronics/Parkbrake/Parkbrake.kicad_pcb

## KiCad design electronics/Parkbrake/Parkbrake.kicad_pcb (continued)

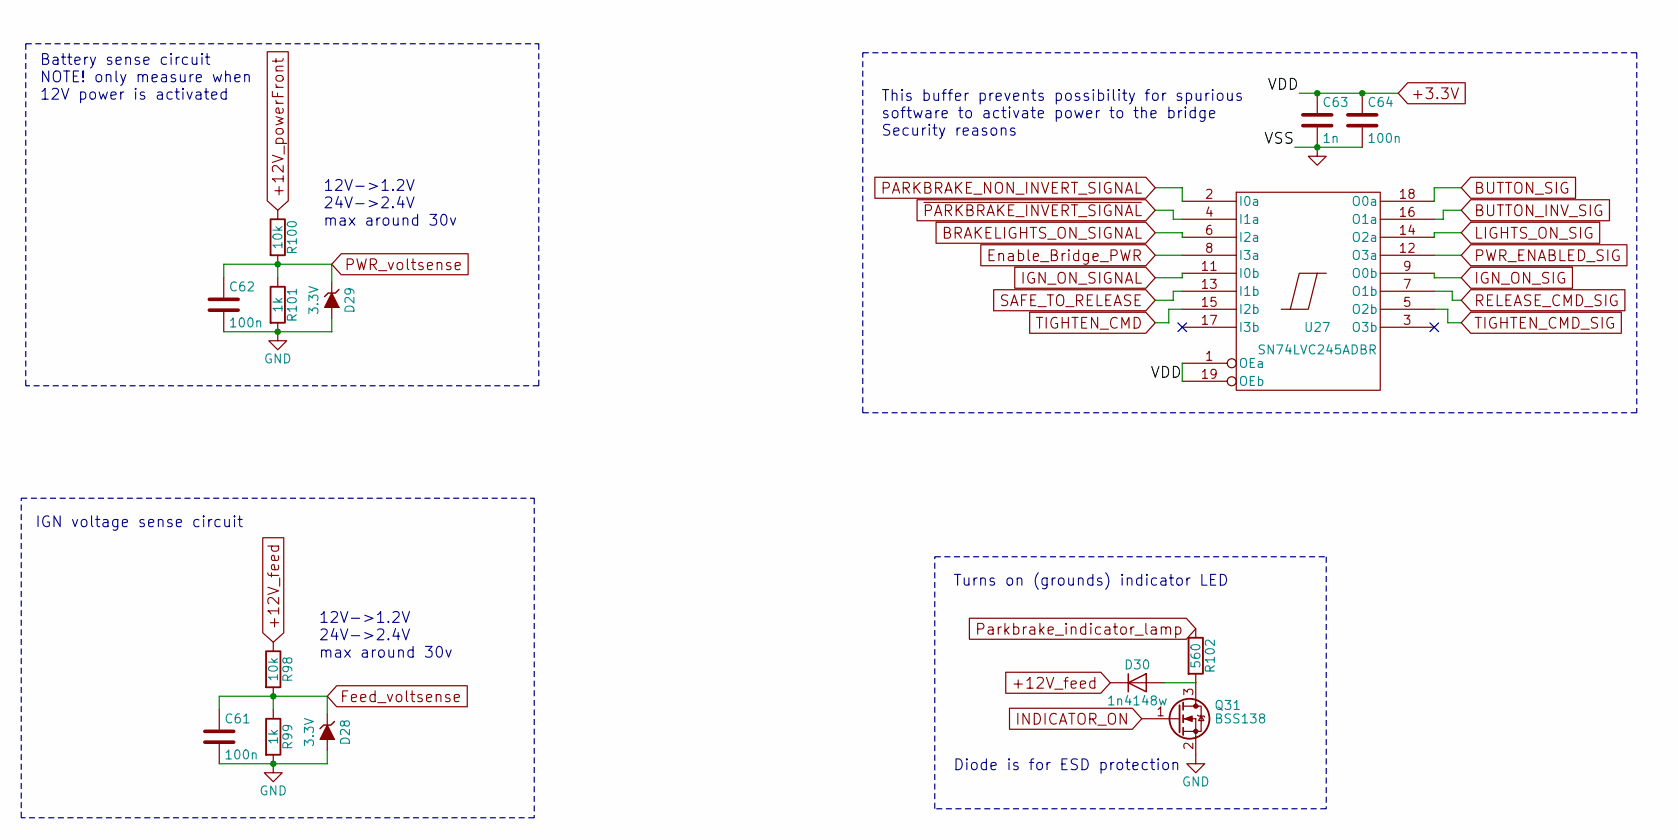
[picture p11: schematic input_things.sch]

Parts:
C61, C62, C64: 100n; C_0805; part 0805B104J500CT; farnell 2496940
C63: 1n; C_0805; part GRM2165C1H102JA01D; farnell 2494247
D28, D29: 3.3V; SOD-323; part MM3Z3V3ST1G; farnell 2463489
D30: 1n4148w; SOD-323; part 1N4148WS; farnell 1466524
Q31: BSS138; SOT-323; part BSS138PW; farnell 1907611
R98, R100: 10k; R_0805; part MC01W0805110K; farnell 9332391
R99, R101: 1k; R_0805; part MC01W080511K; farnell 9332383
R102: 560; R_0805; part MC01W08051560R; farnell 9333363
U27: SN74LVC245ADBR; SSOP-20_5.3x7.2mm_Pitch0.65mm; part SN74LVC245ADBR; farnell 1595415

Connections:
+3.3V: C63.1, C64.1, U27.1 (OEa), U27.19 (OEb), U27.20 (VCC); also elsewhere on the board
+12V_Feed: D30.1 (K), R98.1; also elsewhere on the board
+12V_powerFront: R100.1; also elsewhere on the board
BRAKELIGHTS_ON_SIGNAL: U27.6 (I2a); also elsewhere on the board
BUTTON_INV_SIG: U27.16 (O1a); also elsewhere on the board
BUTTON_SIG: U27.18 (O0a); also elsewhere on the board
Enable_Bridge_PWR: U27.8 (I3a); also elsewhere on the board
Feed_voltsense: C61.1, D28.1 (K), R98.2, R99.1; also elsewhere on the board
IGN_ON_SIG: U27.9 (O0b); also elsewhere on the board
IGN_ON_SIGNAL: U27.11 (I0b); also elsewhere on the board
INDICATOR_ON: Q31.1 (G); also elsewhere on the board
LIGHTS_ON_SIG: U27.14 (O2a); also elsewhere on the board
LR_wheelsensor_in-: C61.2, C62.2, C63.2, C64.2, D28.2 (A), D29.2 (A), Q31.2 (S), R99.2, R101.2, U27.10 (GND); also elsewhere on the board
unnamed: D30.2 (A), Q31.3 (D), R102.2
PARKBRAKE_NON_INVERT_SIGNAL: U27.2 (I0a); also elsewhere on the board
PWR_ENABLED_SIG: U27.12 (O3a); also elsewhere on the board
PWR_voltsense: C62.1, D29.1 (K), R100.2, R101.1; also elsewhere on the board
Parkbrake_indicator_lamp: R102.1; also elsewhere on the board
RELEASE_CMD_SIG: U27.7 (O1b); also elsewhere on the board
SAFE_TO_RELEASE: U27.13 (I1b); also elsewhere on the board
TIGHTEN_CMD: U27.15 (I2b); also elsewhere on the board
TIGHTEN_CMD_SIG: U27.5 (O2b); also elsewhere on the board
~PARKBRAKE_INVERT_SIGNAL: U27.4 (I1a); also elsewhere on the board

Notes on the sheet:
This buffer prevents possibility for spurious software to activate power to the bridge Security reasons
Battery sense circuit NOTE! only measure when 12V power is activated
12V->1.2V 24V->2.4V max around 30v
IGN voltage sense circuit
Turns on (grounds) indicator LED
Diode is for ESD protection

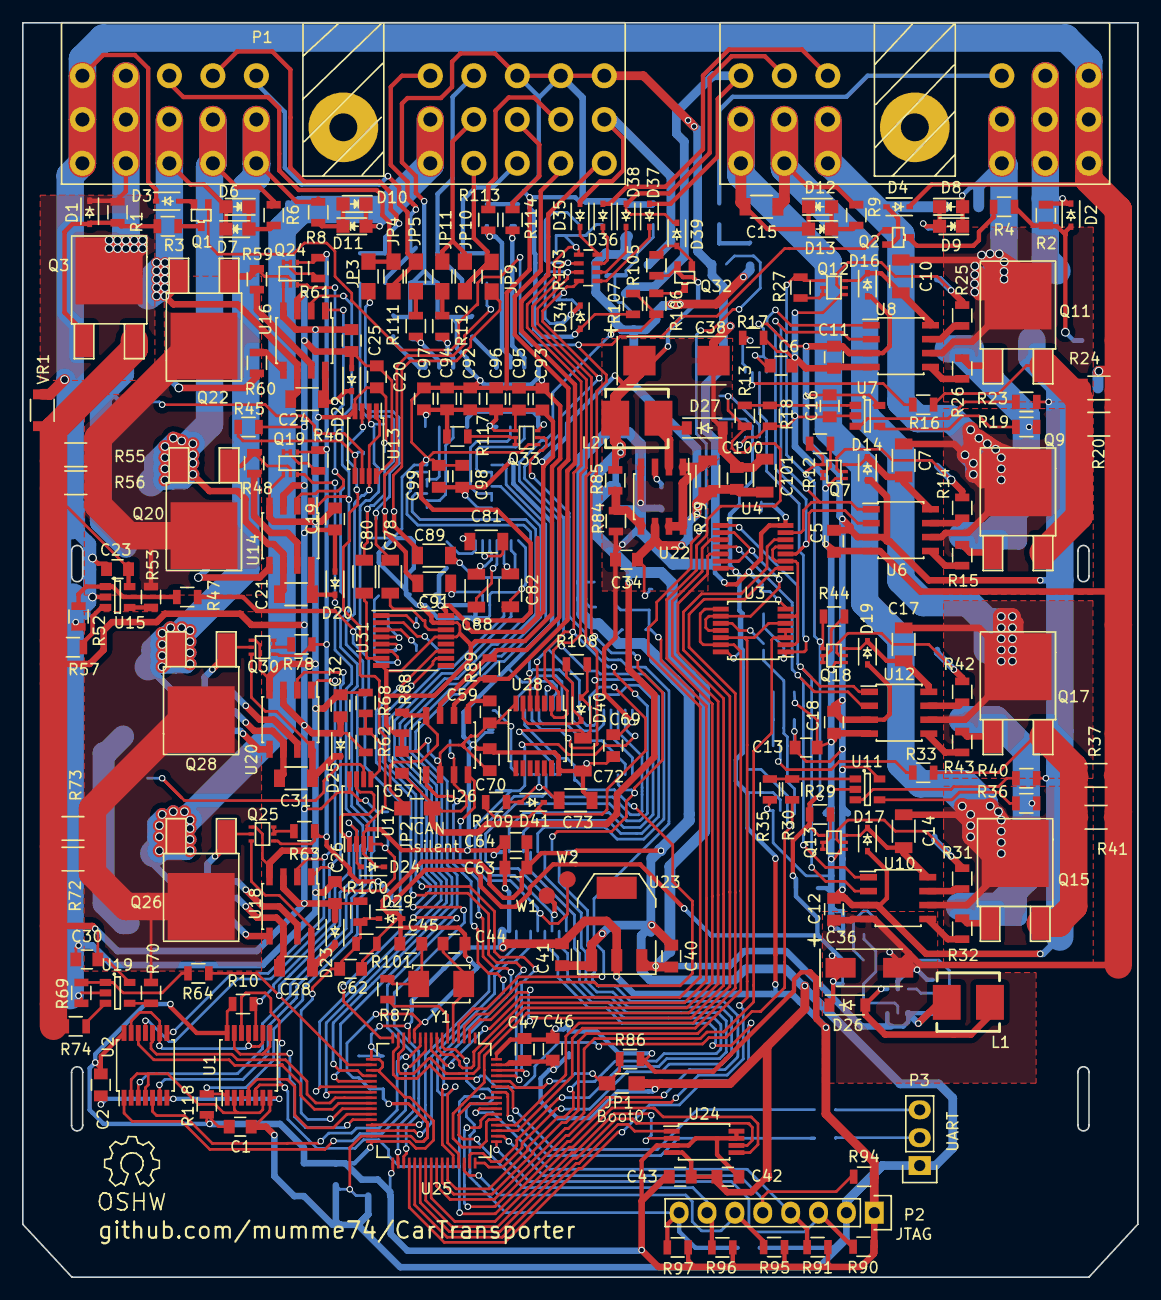
[picture p12: board Parkbrake.kicad_pcb from above]

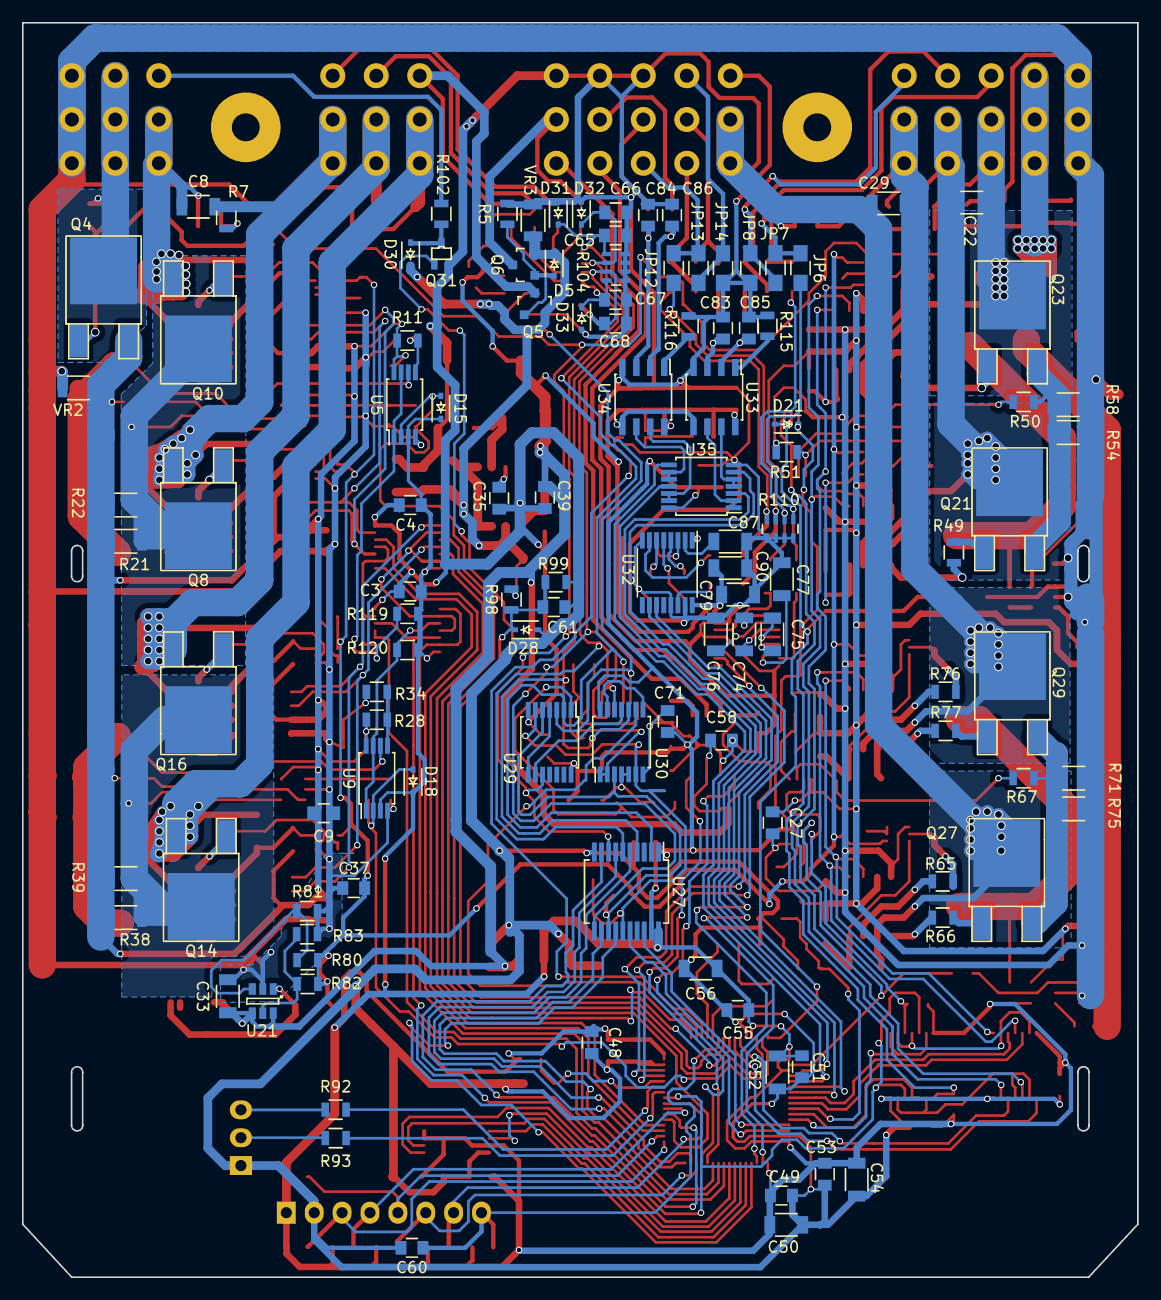
[picture p13: board Parkbrake.kicad_pcb from below]

Board: 2 copper layers, 101.6 x 114.3 mm, 355 parts (114 on the bottom side), 260 nets.
