mumme74/CarTransporter/electronics/Parkbrake_switch/Parkbrake_switch.kicad_pcb

## KiCad design electronics/Parkbrake_switch/Parkbrake_switch.kicad_pcb (2018-07-11)

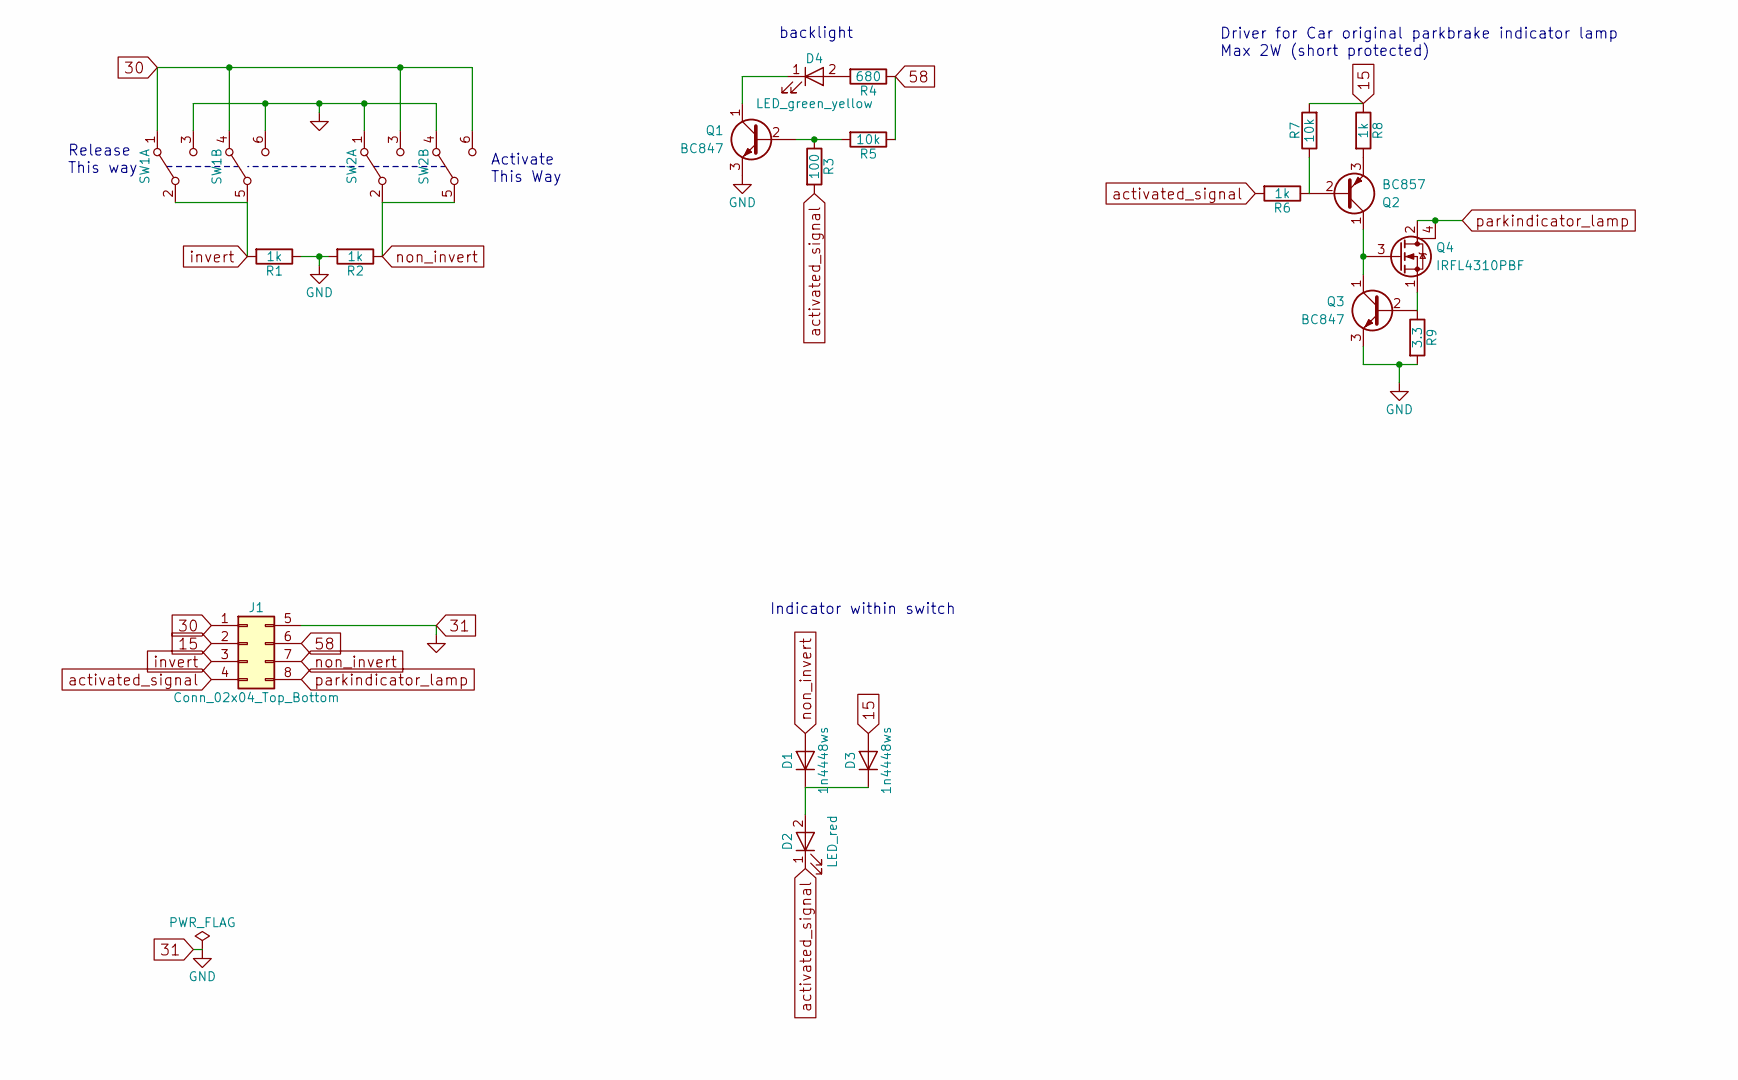
[picture p14: schematic Parkbrake_switch.sch]

Parts:
D1, D3: 1n4448ws; SOD-323; farnell 2453724
D2: LED_red; LED_0603; farnell 2687488
D4: LED_green_yellow; LED_0603; farnell 2762558
J1: Conn_02x04_Top_Bottom; Pin_Header_Straight_2x04_Pitch2.54mm; farnell 2356133
Q1, Q3: BC847; SOT-23; farnell 1574344
Q2: BC857; SOT-23; farnell 1773640
Q4: IRFL4310PBF; SOT-223; farnell 2101414
R1, R2, R6, R8: 1k; R_0805; farnell 2447587
R3: 100; R_0805; farnell 2694094
R4: 680; R_0805; farnell 1653028
R5, R7: 10k; R_0805; farnell 2446870
R9: 3.3; R_0805; farnell 2447656
SW1, SW2: SW_DPDT_x2; SPPH410100; farnell 1435768

Connections:
15: D3.2 (A), J1.2, R7.2, R8.1
30: J1.1, SW1.1 (A), SW1.4 (A), SW2.3 (C), SW2.6 (C)
31: J1.5, Q1.3 (E), Q3.3 (E), R1.1, R2.2, R9.2, SW1.3 (C), SW1.6 (C), SW2.1 (A), SW2.4 (A)
58: J1.6, R4.1, R5.1
unnamed: D1.1 (K), D2.2 (A), D3.1 (K)
unnamed: D4.1 (K), Q1.1 (C)
unnamed: D4.2 (A), R4.2
unnamed: Q1.2 (B), R3.1, R5.2
unnamed: Q2.1 (C), Q3.1 (C), Q4.3 (G)
unnamed: Q2.2 (B), R6.1, R7.1
unnamed: Q2.3 (E), R8.2
unnamed: Q3.2 (B), Q4.1 (S), R9.1
activated_signal: D2.1 (K), J1.4, R3.2, R6.2
invert: J1.3, R1.2, SW1.2 (B), SW1.5 (B)
non_invert: D1.2 (A), J1.7, R2.1, SW2.2 (B), SW2.5 (B)
parkindicator_lamp: J1.8, Q4.2 (D), Q4.4 (D)

Notes on the sheet:
backlight
Driver for Car original parkbrake indicator lamp Max 2W (short protected)
Indicator within switch
Release This way
Activate This Way

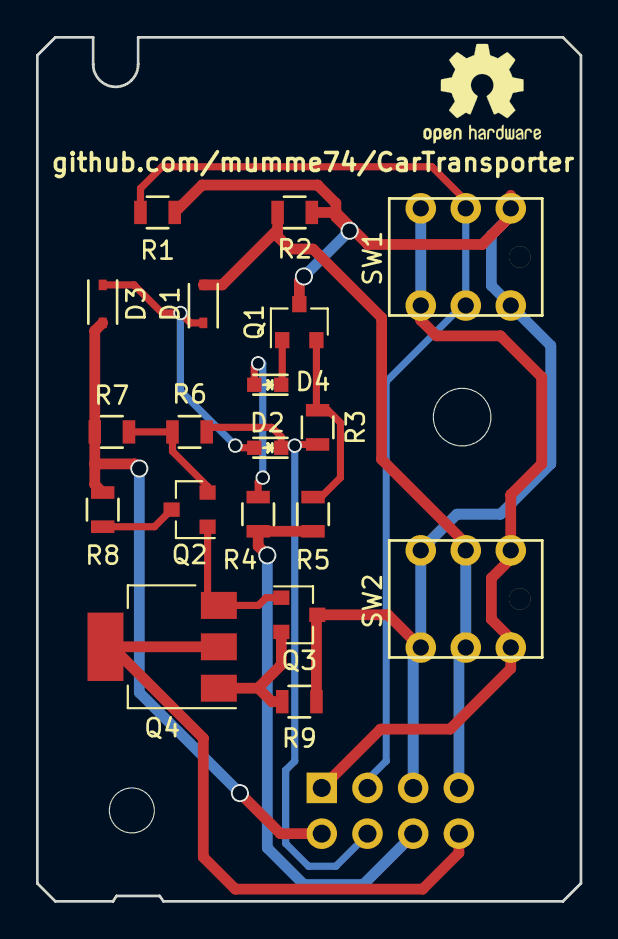
[picture p15: board Parkbrake_switch.kicad_pcb from above]

Board: 2 copper layers, 30.2 x 48.0 mm, 20 parts (1 on the bottom side), 16 nets.
