mumme74/CarTransporter/electronics/AirSuspension/airsuspension_controller.kicad_pcb

## KiCad design electronics/AirSuspension/airsuspension_controller.kicad_pcb (2016-04-02)

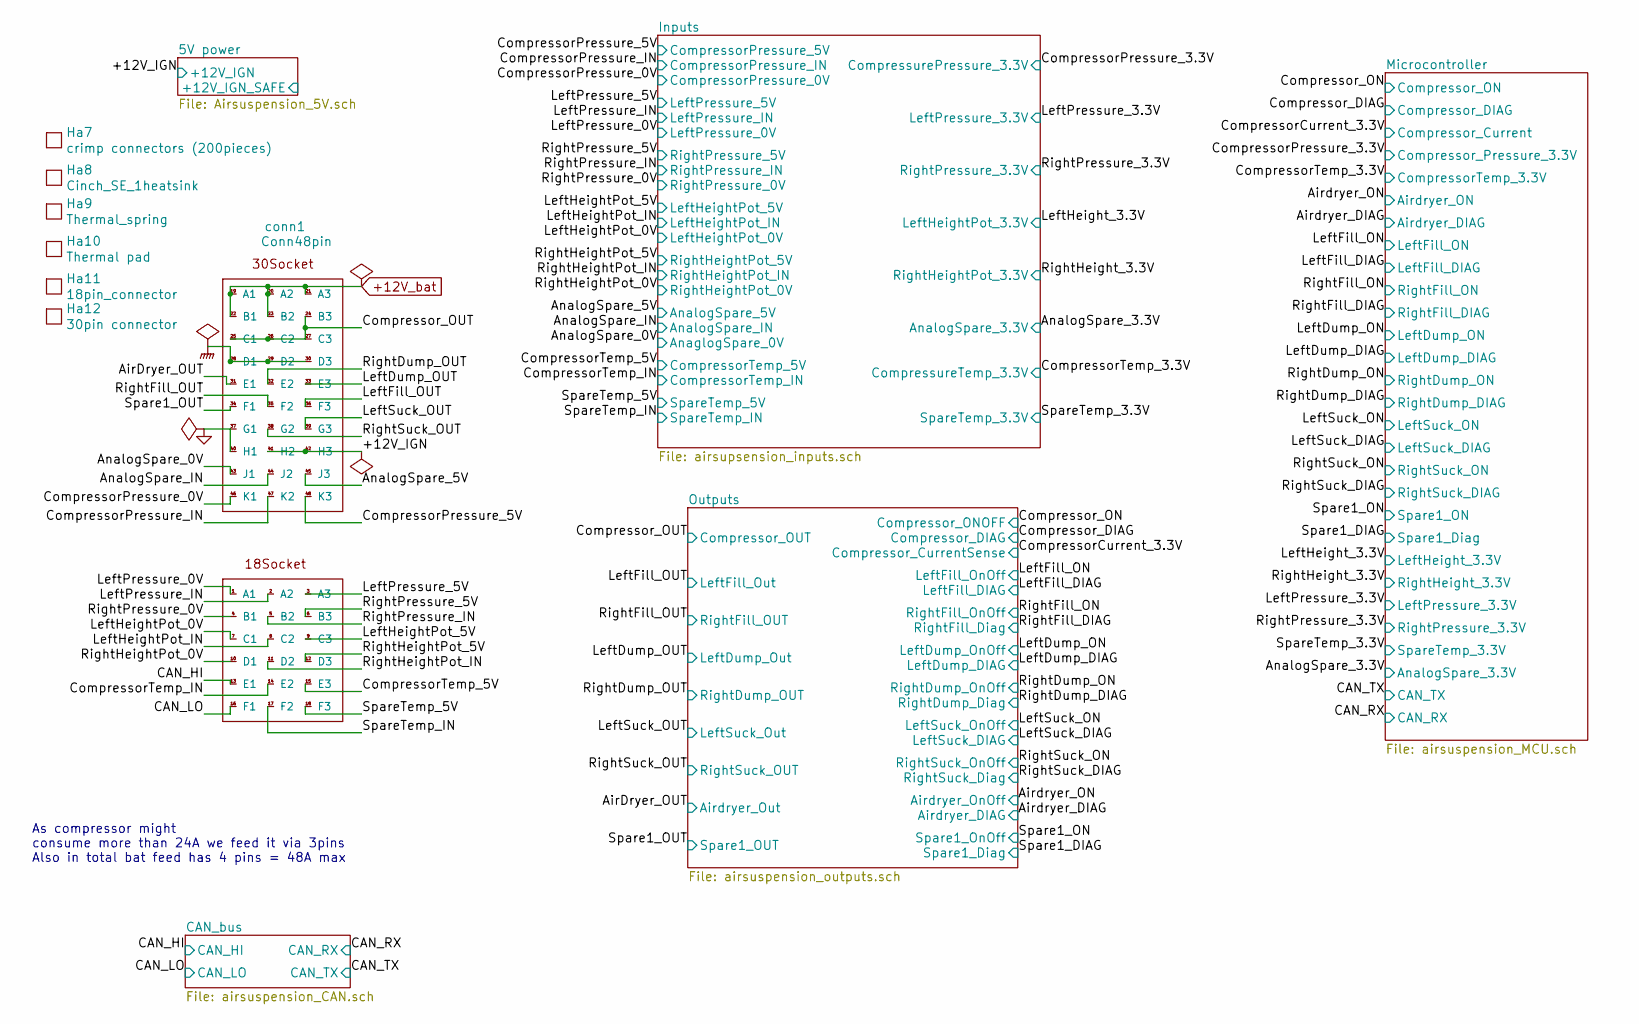
[picture p16: schematic airsuspension_controller.sch, ECU controller airsuspension]

Parts:
Ha7: crimp connectors (200pieces); part 4250000873; farnell 1282210
Ha8: Cinch_SE_1heatsink; part 5810130042; farnell 1282197
Ha9: Thermal_spring; part 5810000021; farnell 1282203
Ha10: Thermal pad; part FCTS73-05N; farnell 2289473
Ha11: 18pin_connector; part 5810118023; farnell 1282205
Ha12: 30pin connector; part 5810130028; farnell 1282206
conn1: Conn48pin; part 5810148007; farnell 1282184

Connections:
+12V_bat: conn1.19 (A1), conn1.20 (A2), conn1.21 (A3), conn1.22 (B1), conn1.23 (B2); also elsewhere on the board
/+12V_IGN: conn1.41 (H2), conn1.42 (H3); also elsewhere on the board
/AirDryer_OUT: conn1.31 (E1); also elsewhere on the board
/AnalogSpare_5V: conn1.45 (J3); also elsewhere on the board
/AnalogSpare_IN: conn1.44 (J2); also elsewhere on the board
/CAN_HI: conn1.13 (E1); also elsewhere on the board
/CAN_LO: conn1.16 (F1); also elsewhere on the board
/CompressorPressure_5V: conn1.48 (K3); also elsewhere on the board
/CompressorPressure_IN: conn1.47 (K2); also elsewhere on the board
/CompressorTemp_5V: conn1.15 (E3); also elsewhere on the board
/CompressorTemp_IN: conn1.14 (E2); also elsewhere on the board
/Compressor_OUT: conn1.24 (B3), conn1.25 (C1), conn1.26 (C2), conn1.27 (C3); also elsewhere on the board
/LeftDump_OUT: conn1.33 (E3); also elsewhere on the board
/LeftFill_OUT: conn1.36 (F3); also elsewhere on the board
/LeftHeightPot_5V: conn1.9 (C3); also elsewhere on the board
/LeftHeightPot_IN: conn1.8 (C2); also elsewhere on the board
/LeftPressure_5V: conn1.3 (A3); also elsewhere on the board
/LeftPressure_IN: conn1.2 (A2); also elsewhere on the board
/LeftSuck_OUT: conn1.39 (G3); also elsewhere on the board
/RightDump_OUT: conn1.32 (E2); also elsewhere on the board
/RightFill_OUT: conn1.35 (F2); also elsewhere on the board
/RightHeightPot_5V: conn1.12 (D3); also elsewhere on the board
/RightHeightPot_IN: conn1.11 (D2); also elsewhere on the board
/RightPressure_5V: conn1.6 (B3); also elsewhere on the board
/RightPressure_IN: conn1.5 (B2); also elsewhere on the board
/RightSuck_OUT: conn1.38 (G2); also elsewhere on the board
/Spare1_OUT: conn1.34 (F1); also elsewhere on the board
/SpareTemp_5V: conn1.18 (F3); also elsewhere on the board
/SpareTemp_IN: conn1.17 (F2); also elsewhere on the board
GND: conn1.1 (A1), conn1.4 (B1), conn1.7 (C1), conn1.10 (D1), conn1.37 (G1), conn1.40 (H1), conn1.43 (J1), conn1.46 (K1); also elsewhere on the board
GNDPWR: conn1.28 (D1), conn1.29 (D2), conn1.30 (D3); also elsewhere on the board

Notes on the sheet:
As compressor might consume more than 24A we feed it via 3pins Also in total bat feed has 4 pins = 48A max

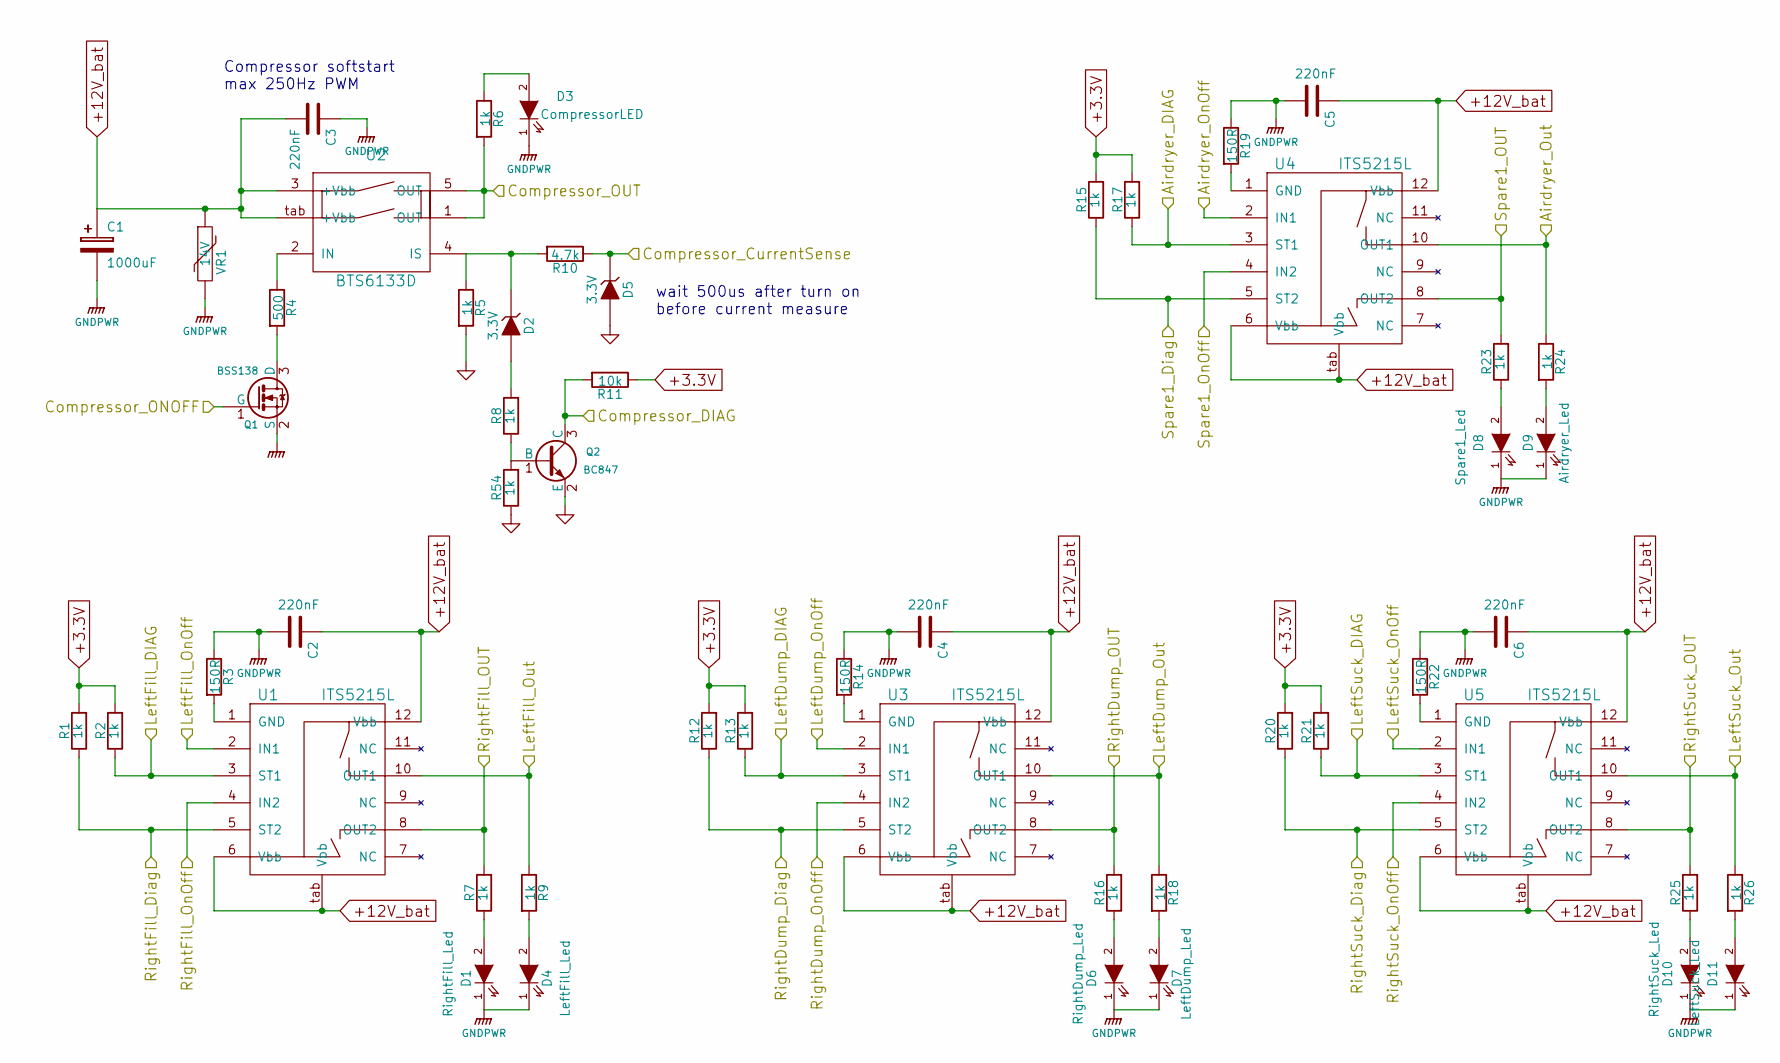
[picture p17: schematic airsuspension_outputs.sch]

Parts:
C1: 1000uF; SMD_Cap_16x16.5; part EEEFK1H102AM; farnell 1850136
C2, C3, C4, C5, C6: 220nF; C_0805; part C0805C224K5RACTU; farnell 1288261
D1: RightFill_Led; LED_0805; part KP-2012CGCK; farnell 2290331
D2, D5: 3.3V; SOD-323; part PDZ3.3B.115; farnell 1757856
D3: CompressorLED; LED_0805; part KP-2012CGCK; farnell 2290331
D4: LeftFill_Led; LED_0805; part KP-2012CGCK; farnell 2290331
D6: RightDump_Led; LED_0805; part KP-2012CGCK; farnell 2290331
D7: LeftDump_Led; LED_0805; part KP-2012CGCK; farnell 2290331
D8: Spare1_Led; LED_0805; part KP-2012CGCK; farnell 2290331
D9: Airdryer_Led; LED_0805; part KP-2012CGCK; farnell 2290331
D10: RightSuck_Led; LED_0805; part KP-2012CGCK; farnell 2290331
D11: LeftSuck_Led; LED_0805; part KP-2012CGCK; farnell 2290331
Q1: BSS138; SOT-23_Handsoldering; part BSS138BK; farnell 2053833
Q2: BC847; SOT-23_Handsoldering; part BC847; farnell 1773609
R1, R2, R5, R6, R7, R8, R9, R12, R13, R15, R16, R17, R18, R20, R21, R23, R24, R25, R26, R54: 1k; R_0805; farnell 9332383
R3, R14, R19, R22: 150R; R_0805; farnell 1469877
R4: 500; R_0805; farnell 1469936
R10: 4.7k; R_0805; farnell 2333572
R11: 10k; R_0805; farnell 9332391
U1, U3, U4, U5: ITS5215L; PG-DSO-12-2; part ITS5215L; farnell 1426197
U2: BTS6133D; bts6133d; part BTS6133D; farnell 1440811
VR1: 14V; R_1206_HandSoldering; part V14MLA1206NHAUTO; farnell 1863849

Connections:
+3.3V: R1.2, R2.2, R11.1, R12.2, R13.2, R15.2, R17.2, R20.2, R21.2; also elsewhere on the board
+12V_bat: C1.1, C2.1, C3.2, C4.1, C5.1, C6.1, U1.6 (Vbb), U1.12 (Vbb), U1.tab (Vbb), U2.3 (+Vbb), U2.tab (+Vbb), U3.6 (Vbb), U3.12 (Vbb), U3.tab (Vbb), U4.6 (Vbb), U4.12 (Vbb), U4.tab (Vbb), U5.6 (Vbb), U5.12 (Vbb), U5.tab (Vbb), VR1.1; also elsewhere on the board
/AirDryer_OUT: R24.1, U4.10 (OUT1); also elsewhere on the board
/Airdryer_DIAG: R17.1, U4.3 (ST1); also elsewhere on the board
/Airdryer_ON: U4.2 (IN1); also elsewhere on the board
/CompressorCurrent_3.3V: D5.1 (K), R10.1; also elsewhere on the board
/Compressor_DIAG: Q2.3 (C), R11.2; also elsewhere on the board
/Compressor_ON: Q1.1 (G); also elsewhere on the board
/Compressor_OUT: R6.2, U2.1 (OUT), U2.5 (OUT); also elsewhere on the board
/LeftDump_DIAG: R13.1, U3.3 (ST1); also elsewhere on the board
/LeftDump_ON: U3.2 (IN1); also elsewhere on the board
/LeftDump_OUT: R18.1, U3.10 (OUT1); also elsewhere on the board
/LeftFill_DIAG: R2.1, U1.3 (ST1); also elsewhere on the board
/LeftFill_ON: U1.2 (IN1); also elsewhere on the board
/LeftFill_OUT: R9.1, U1.10 (OUT1); also elsewhere on the board
/LeftSuck_DIAG: R21.1, U5.3 (ST1); also elsewhere on the board
/LeftSuck_ON: U5.2 (IN1); also elsewhere on the board
/LeftSuck_OUT: R26.1, U5.10 (OUT1); also elsewhere on the board
/RightDump_DIAG: R12.1, U3.5 (ST2); also elsewhere on the board
/RightDump_ON: U3.4 (IN2); also elsewhere on the board
/RightDump_OUT: R16.2, U3.8 (OUT2); also elsewhere on the board
/RightFill_DIAG: R1.1, U1.5 (ST2); also elsewhere on the board
/RightFill_ON: U1.4 (IN2); also elsewhere on the board
/RightFill_OUT: R7.2, U1.8 (OUT2); also elsewhere on the board
/RightSuck_DIAG: R20.1, U5.5 (ST2); also elsewhere on the board
/RightSuck_ON: U5.4 (IN2); also elsewhere on the board
/RightSuck_OUT: R25.2, U5.8 (OUT2); also elsewhere on the board
/Spare1_DIAG: R15.1, U4.5 (ST2); also elsewhere on the board
/Spare1_ON: U4.4 (IN2); also elsewhere on the board
/Spare1_OUT: R23.2, U4.8 (OUT2); also elsewhere on the board
GND: D5.2 (A), Q2.2 (E), R5.2, R54.1; also elsewhere on the board
GNDPWR: C1.2, C2.2, C3.1, C4.2, C5.2, C6.2, D1.1 (K), D3.1 (K), D4.1 (K), D6.1 (K), D7.1 (K), D8.1 (K), D9.1 (K), D10.1 (K), D11.1 (K), Q1.2 (S), R3.1, R14.1, R19.1, R22.1, VR1.2; also elsewhere on the board
unnamed: D1.2 (A), R7.1
unnamed: D2.1 (K), R5.1, R10.2, U2.4 (IS)
unnamed: D2.2 (A), R8.2
unnamed: D3.2 (A), R6.1
unnamed: D4.2 (A), R9.2
unnamed: D6.2 (A), R16.1
unnamed: D7.2 (A), R18.2
unnamed: D8.2 (A), R23.1
unnamed: D9.2 (A), R24.2
unnamed: D10.2 (A), R25.1
unnamed: D11.2 (A), R26.2
unnamed: Q1.3 (D), R4.2
unnamed: Q2.1 (B), R8.1, R54.2
unnamed: R3.2, U1.1 (GND)
unnamed: R4.1, U2.2 (IN)
unnamed: R14.2, U3.1 (GND)
unnamed: R19.2, U4.1 (GND)
unnamed: R22.2, U5.1 (GND)

Notes on the sheet:
Compressor softstart max 250Hz PWM
wait 500us after turn on before current measure

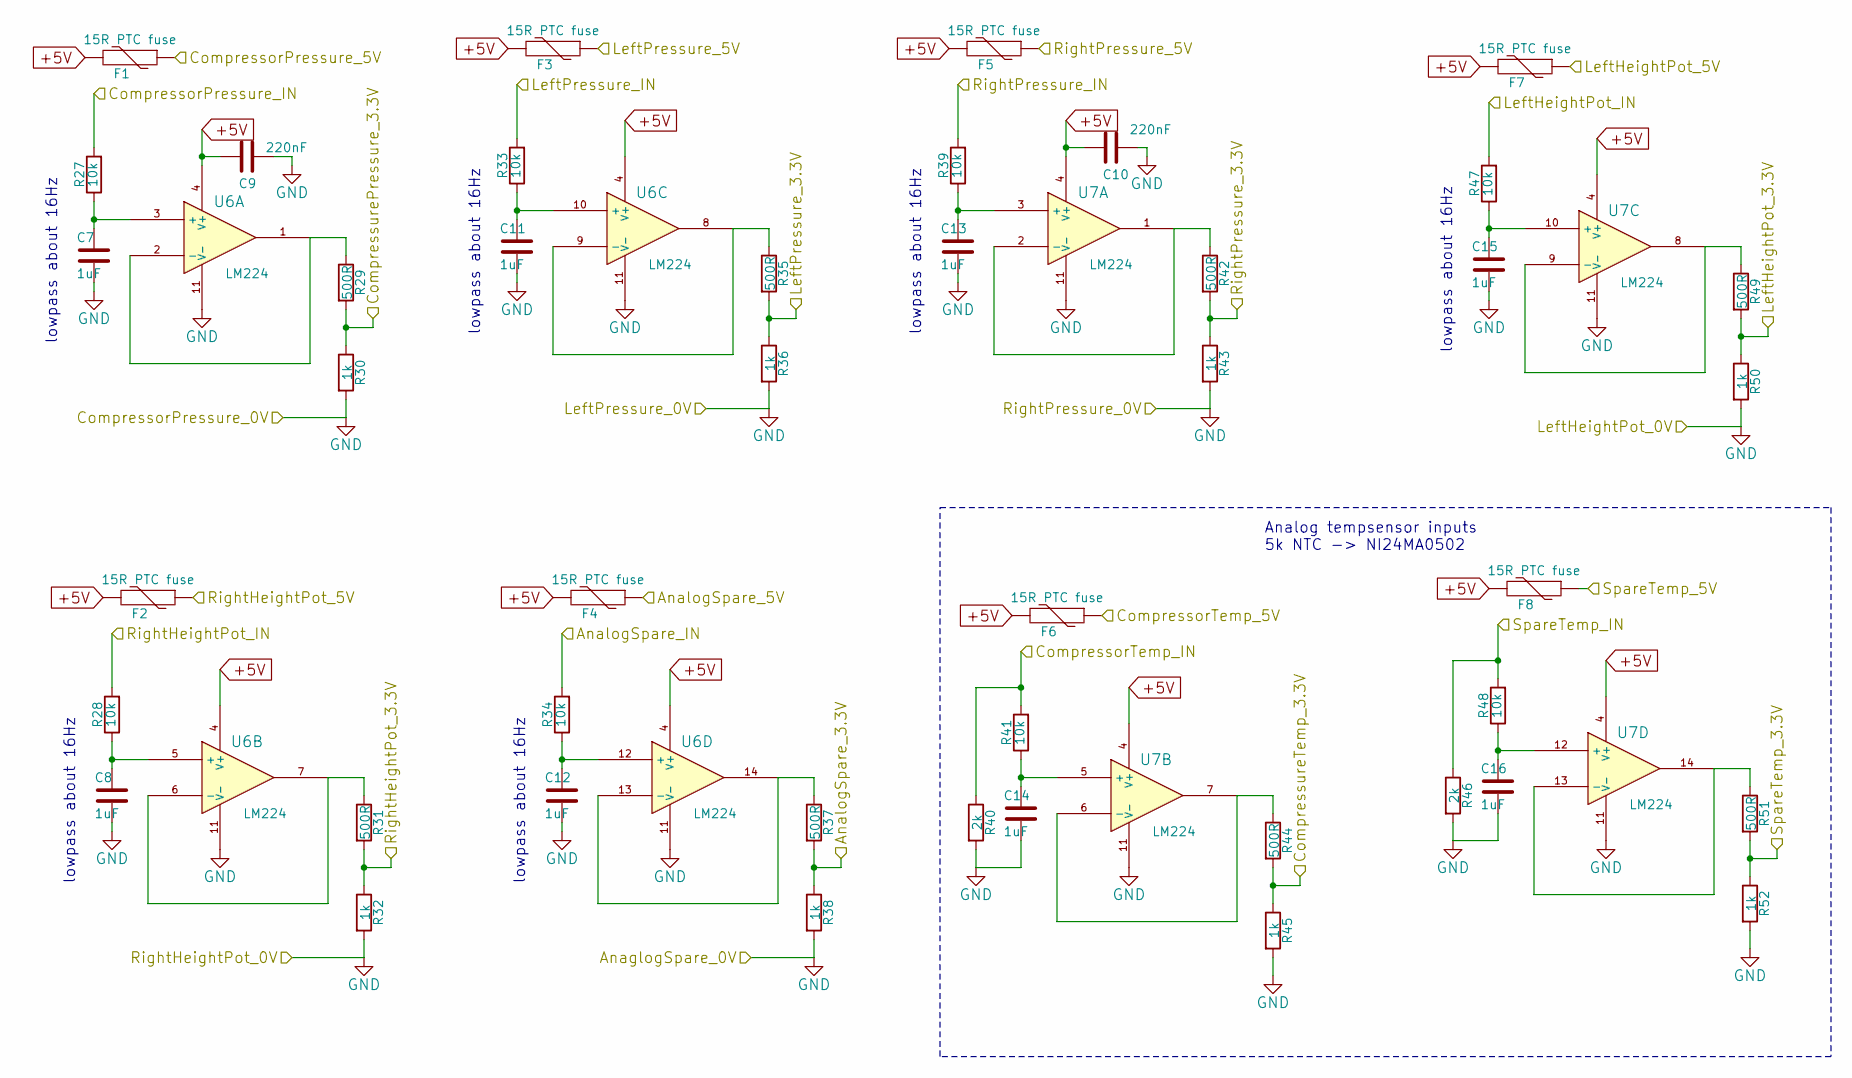
[picture p18: schematic airsupsension_inputs.sch]

Parts:
C7, C8, C11, C12, C13, C14, C15, C16: 1uF; C_0805; part C0805C105K5RACTU; farnell 2118131
C9, C10: 220nF; C_0805; part C0805C224K5RACTU; farnell 1288261
F1, F2, F3, F4, F5, F6, F7, F8: 15R PTC fuse; R_1210; part MICROSMD010F-2; farnell 1345917
R27, R28, R33, R34, R39, R41, R47, R48: 10k; R_0805; farnell 9332391
R29, R31, R35, R37, R42, R44, R49, R51: 500R; R_0805; farnell 1469936
R30, R32, R36, R38, R43, R45, R50, R52: 1k; R_0805; farnell 9332383
R40, R46: 2k; R_0805; farnell 9332766
U6, U7: LM224; SOIC-14_N; part LM224DR2G; farnell 1426352

Connections:
+5V: C9.2, C10.2, F1.2, F2.2, F3.2, F4.2, F5.2, F6.2, F7.2, F8.2, U6.4 (V+), U7.4 (V+); also elsewhere on the board
/AnalogSpare_3.3V: R37.2, R38.1; also elsewhere on the board
/AnalogSpare_5V: F4.1; also elsewhere on the board
/AnalogSpare_IN: R34.2; also elsewhere on the board
/CompressorPressure_3.3V: R29.2, R30.1; also elsewhere on the board
/CompressorPressure_5V: F1.1; also elsewhere on the board
/CompressorPressure_IN: R27.2; also elsewhere on the board
/CompressorTemp_3.3V: R44.2, R45.1; also elsewhere on the board
/CompressorTemp_5V: F6.1; also elsewhere on the board
/CompressorTemp_IN: R40.1, R41.2; also elsewhere on the board
/LeftHeightPot_5V: F7.1; also elsewhere on the board
/LeftHeightPot_IN: R47.2; also elsewhere on the board
/LeftHeight_3.3V: R49.2, R50.1; also elsewhere on the board
/LeftPressure_3.3V: R35.2, R36.1; also elsewhere on the board
/LeftPressure_5V: F3.1; also elsewhere on the board
/LeftPressure_IN: R33.2; also elsewhere on the board
/RightHeightPot_5V: F2.1; also elsewhere on the board
/RightHeightPot_IN: R28.2; also elsewhere on the board
/RightHeight_3.3V: R31.2, R32.1; also elsewhere on the board
/RightPressure_3.3V: R42.2, R43.1; also elsewhere on the board
/RightPressure_5V: F5.1; also elsewhere on the board
/RightPressure_IN: R39.2; also elsewhere on the board
/SpareTemp_3.3V: R51.2, R52.1; also elsewhere on the board
/SpareTemp_5V: F8.1; also elsewhere on the board
/SpareTemp_IN: R46.1, R48.2; also elsewhere on the board
GND: C7.2, C8.2, C9.1, C10.1, C11.2, C12.2, C13.2, C14.2, C15.2, C16.2, R30.2, R32.2, R36.2, R38.2, R40.2, R43.2, R45.2, R46.2, R50.2, R52.2, U6.11 (V-), U7.11 (V-); also elsewhere on the board
unnamed: C7.1, R27.1, U6.3 (+)
unnamed: C8.1, R28.1, U6.5 (+)
unnamed: C11.1, R33.1, U6.10 (+)
unnamed: C12.1, R34.1, U6.12 (+)
unnamed: C13.1, R39.1, U7.3 (+)
unnamed: C14.1, R41.1, U7.5 (+)
unnamed: C15.1, R47.1, U7.10 (+)
unnamed: C16.1, R48.1, U7.12 (+)
unnamed: R29.1, U6.1, U6.2 (-)
unnamed: R31.1, U6.6 (-), U6.7
unnamed: R35.1, U6.8, U6.9 (-)
unnamed: R37.1, U6.13 (-), U6.14
unnamed: R42.1, U7.1, U7.2 (-)
unnamed: R44.1, U7.6 (-), U7.7
unnamed: R49.1, U7.8, U7.9 (-)
unnamed: R51.1, U7.13 (-), U7.14

Notes on the sheet:
lowpass about 16Hz
Analog tempsensor inputs 5k NTC -> NI24MA0502

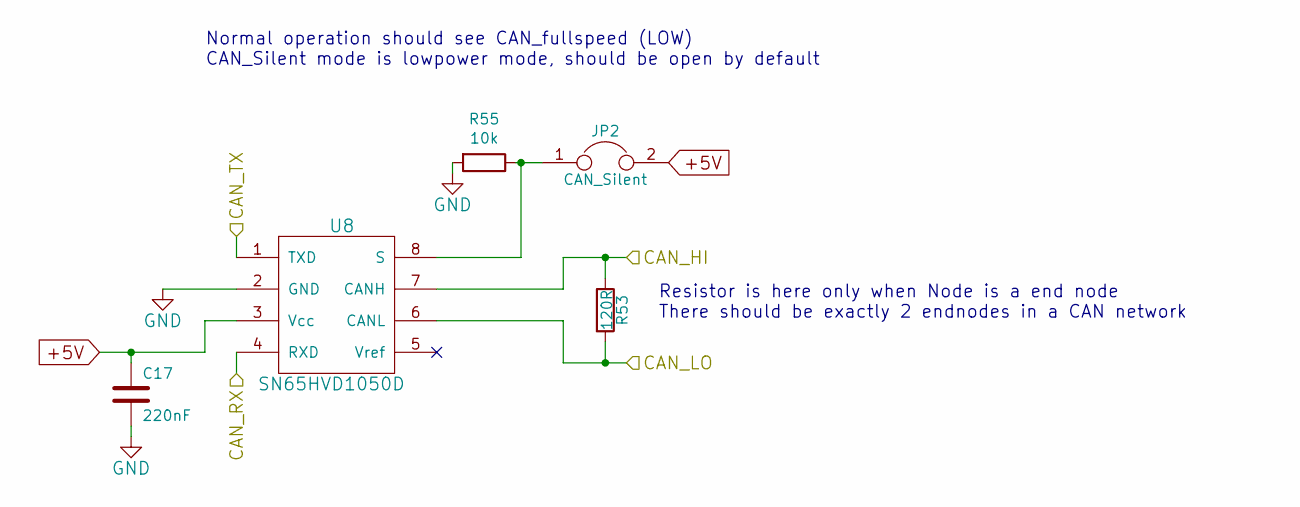
[picture p19: schematic airsuspension_CAN.sch]

Parts:
C17: 220nF; C_0805; part C0805C224K5RACTU; farnell 1288261
JP2: CAN_Silent; NetTie-I_SMD
R53: 120R; R_0805_HandSoldering; farnell 2303452
R55: 10k; R_0805_HandSoldering; farnell 9332391
U8: SN65HVD1050D; SOIC-8_3.9x4.9mm_Pitch1.27mm; part SN65HVD1050D; farnell 1220984

Connections:
+5V: C17.1, JP2.2, U8.3 (Vcc); also elsewhere on the board
/CAN_HI: R53.1, U8.7 (CANH); also elsewhere on the board
/CAN_LO: R53.2, U8.6 (CANL); also elsewhere on the board
/CAN_RX: U8.4 (RXD); also elsewhere on the board
/CAN_TX: U8.1 (TXD); also elsewhere on the board
GND: C17.2, R55.2, U8.2 (GND); also elsewhere on the board
unnamed: JP2.1, R55.1, U8.8 (S)

Notes on the sheet:
Normal operation should see CAN_fullspeed (LOW) CAN_Silent mode is lowpower mode, should be open by default
Resistor is here only when Node is a end node There should be exactly 2 endnodes in a CAN network
