mumme74/CarTransporter/electronics/AirSuspension/airsuspension_controller.kicad_pcb

## KiCad design electronics/AirSuspension/airsuspension_controller.kicad_pcb (continued)

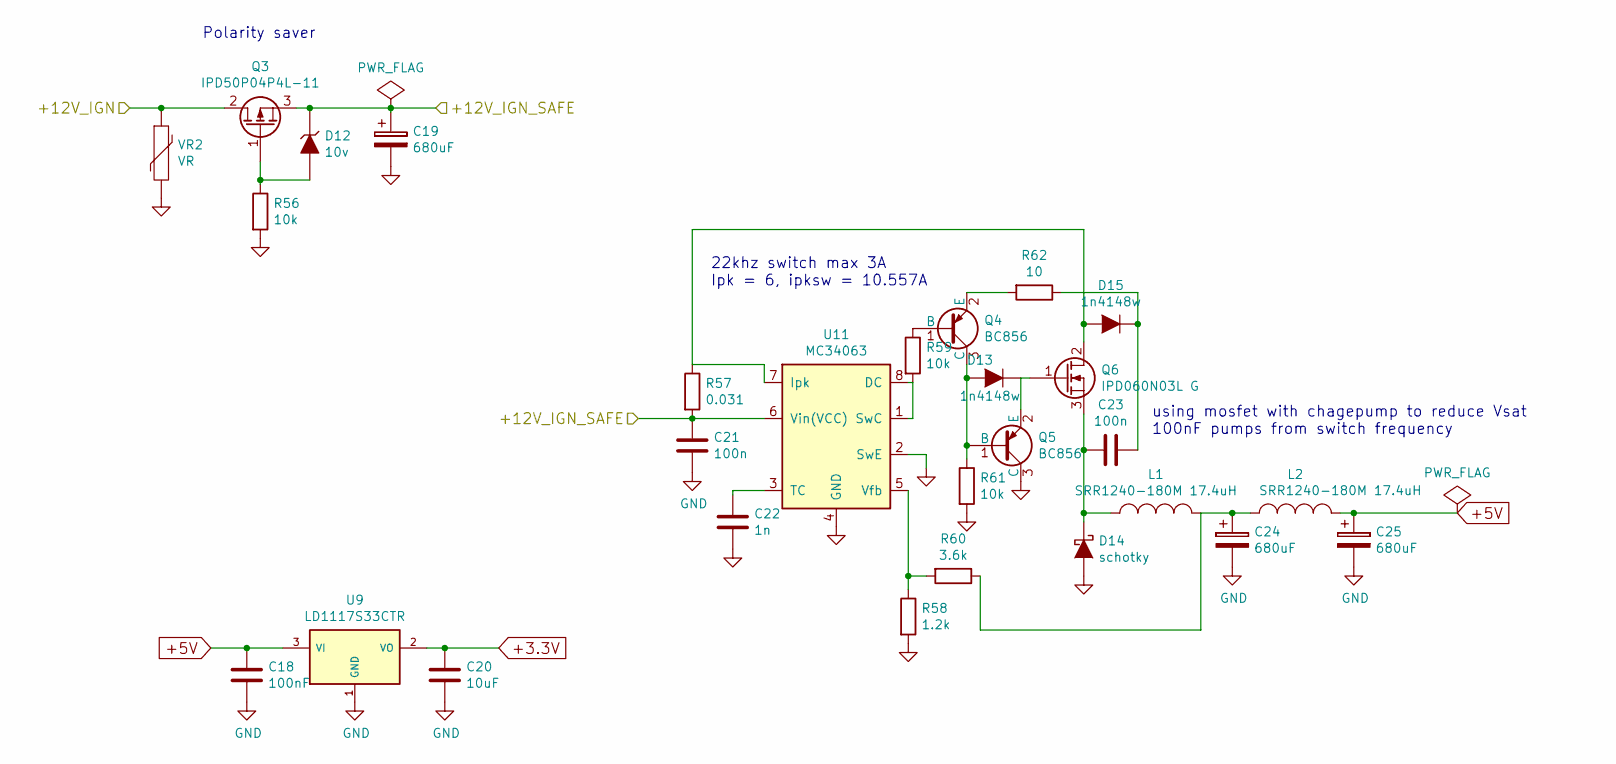
[picture p20: schematic Airsuspension_5V.sch]

Parts:
C18: 100nF; C_0805_HandSoldering; farnell 2496940
C19, C24, C25: 680uF; c_elec_10x10.5; part EEEHAC681UAP; farnell 2326228
C20: 10uF; C_1206_HandSoldering; farnell 1463368
C21, C23: 100n; C_0805_HandSoldering; part 0805B104J500CT; farnell 2496940
C22: 1n; C_0805_HandSoldering; part 0805B102J500CT; farnell 2496932
D12: 10v; SOD-323; part BZT52C10S; farnell 1466026
D13, D15: 1n4148w; SOD-323; farnell 1466524
D14: schotky; DO-214AB_Handsoldering; part MBRS340T3G; farnell 9557377
L1, L2: SRR1240-180M 17.4uH; Neosid_Inductor_SM-NE127; farnell 2333725
Q3: IPD50P04P4L-11; TO-252-2Lead; part IPD50P04P4L-11; farnell 2443434
Q4, Q5: BC856; SOT-23_Handsoldering; part BC856B-7-F; farnell 1773623
Q6: IPD060N03L G; TO-252-2Lead; farnell 1775575
R56, R59, R61: 10k; R_0805_HandSoldering; farnell 9332391
R57: 0.031; R_1206_HandSoldering; part LR1206-R033FW; farnell 1099911
R58: 1.2k; R_0805_HandSoldering; farnell 9332499
R60: 3.6k; R_0805_HandSoldering; farnell 9333118
R62: 10; R_0805_HandSoldering; farnell 9332766
U9: LD1117S33CTR; SOT-223; farnell 1467779
U11: MC34063; SOIC-8_3.9x4.9mm_Pitch1.27mm; part MC34063ABD-TR; farnell 1087205
VR2: VR; R_1206_HandSoldering; part VC120618A400DP; farnell 1301938

Connections:
+3.3V: C20.1, U9.2 (VO); also elsewhere on the board
+5V: C18.1, C25.1, L2.2, U9.3 (VI); also elsewhere on the board
/5V power/+12V_IGN_SAFE: C19.1, C21.1, D12.1 (K), Q3.3 (S), R57.2, U11.6 (Vin(VCC))
/+12V_IGN: Q3.2 (D), VR2.1; also elsewhere on the board
GND: C18.2, C19.2, C20.2, C21.2, C22.2, C24.2, C25.2, D14.2 (A), Q5.3 (C), R56.2, R58.2, R61.2, U9.1 (GND), U11.2 (SwE), U11.4 (GND), VR2.2; also elsewhere on the board
unnamed: C22.1, U11.3 (TC)
unnamed: C23.1, D15.1 (K), R62.1
unnamed: C23.2, D14.1 (K), L1.1, Q6.3 (S)
unnamed: C24.1, L1.2, L2.1, R60.1
unnamed: D12.2 (A), Q3.1 (G), R56.1
unnamed: D13.1 (K), Q5.2 (E), Q6.1 (G)
unnamed: D13.2 (A), Q4.3 (C), Q5.1 (B), R61.1
unnamed: D15.2 (A), Q6.2 (D), R57.1, U11.7 (Ipk)
unnamed: Q4.1 (B), R59.1
unnamed: Q4.2 (E), R62.2
unnamed: R58.1, R60.2, U11.5 (Vfb)
unnamed: R59.2, U11.1 (SwC), U11.8 (DC)

Notes on the sheet:
22khz switch max 3A Ipk = 6, ipksw = 10.557A
using mosfet with chagepump to reduce Vsat 100nF pumps from switch frequency
Polarity saver

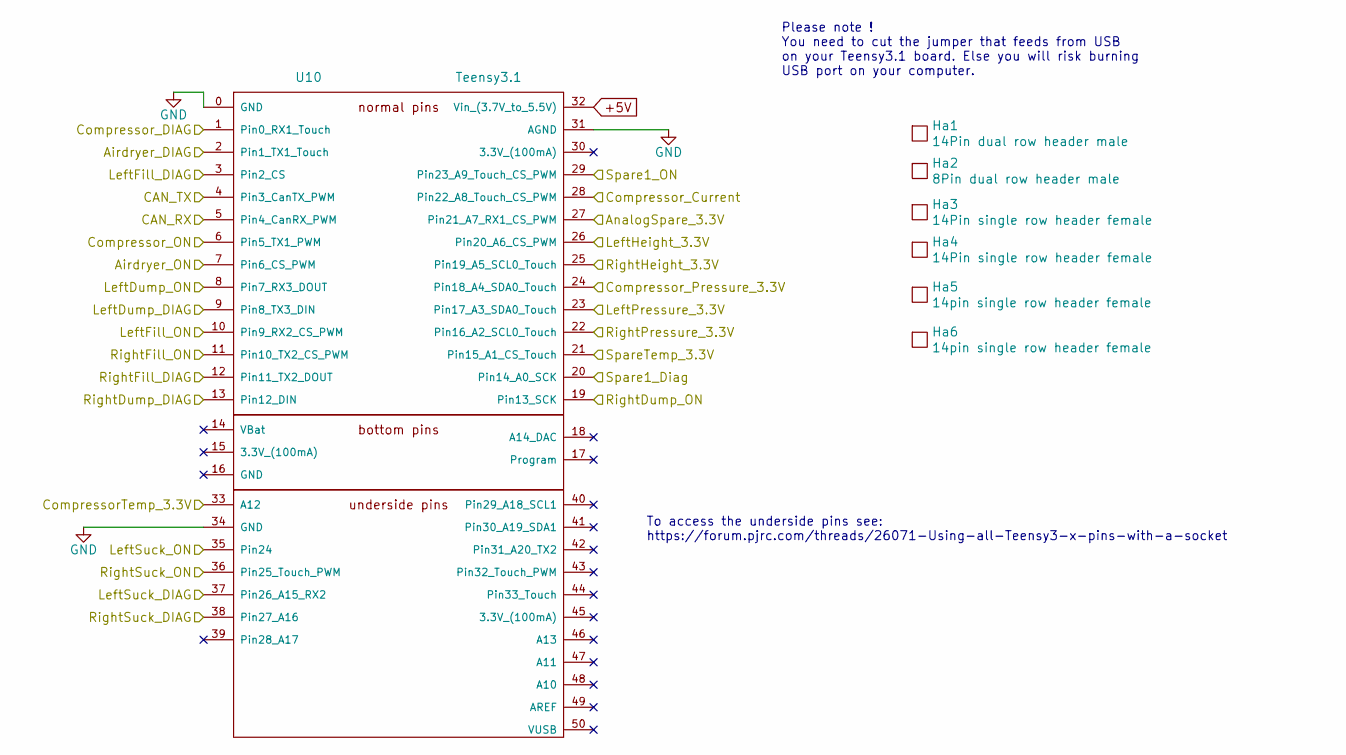
[picture p21: schematic airsuspension_MCU.sch]

Parts:
Ha1: 14Pin dual row header male; farnell 2356135
Ha2: 8Pin dual row header male; farnell 2356133
Ha3: 14Pin single row header female; farnell 1667519
Ha4: 14Pin single row header female; part CES-114-01-T-S; farnell 1667519
Ha5, Ha6: 14pin single row header female; farnell 1667519
U10: Teensy3.1; teensy3.1_w_underside; part Teensy3.1

Connections:
+5V: U10.32 (Vin_(3.7V_to_5.5V)); also elsewhere on the board
/Airdryer_DIAG: U10.2 (Pin1_TX1_Touch); also elsewhere on the board
/Airdryer_ON: U10.7 (Pin6_CS_PWM); also elsewhere on the board
/AnalogSpare_3.3V: U10.27 (Pin21_A7_RX1_CS_PWM); also elsewhere on the board
/CAN_RX: U10.5 (Pin4_CanRX_PWM); also elsewhere on the board
/CAN_TX: U10.4 (Pin3_CanTX_PWM); also elsewhere on the board
/CompressorCurrent_3.3V: U10.28 (Pin22_A8_Touch_CS_PWM); also elsewhere on the board
/CompressorPressure_3.3V: U10.24 (Pin18_A4_SDA0_Touch); also elsewhere on the board
/CompressorTemp_3.3V: U10.33 (A12); also elsewhere on the board
/Compressor_DIAG: U10.1 (Pin0_RX1_Touch); also elsewhere on the board
/Compressor_ON: U10.6 (Pin5_TX1_PWM); also elsewhere on the board
/LeftDump_DIAG: U10.9 (Pin8_TX3_DIN); also elsewhere on the board
/LeftDump_ON: U10.8 (Pin7_RX3_DOUT); also elsewhere on the board
/LeftFill_DIAG: U10.3 (Pin2_CS); also elsewhere on the board
/LeftFill_ON: U10.10 (Pin9_RX2_CS_PWM); also elsewhere on the board
/LeftHeight_3.3V: U10.26 (Pin20_A6_CS_PWM); also elsewhere on the board
/LeftPressure_3.3V: U10.23 (Pin17_A3_SDA0_Touch); also elsewhere on the board
/LeftSuck_DIAG: U10.37 (Pin26_A15_RX2); also elsewhere on the board
/LeftSuck_ON: U10.35 (Pin24); also elsewhere on the board
/RightDump_DIAG: U10.13 (Pin12_DIN); also elsewhere on the board
/RightDump_ON: U10.19 (Pin13_SCK); also elsewhere on the board
/RightFill_DIAG: U10.12 (Pin11_TX2_DOUT); also elsewhere on the board
/RightFill_ON: U10.11 (Pin10_TX2_CS_PWM); also elsewhere on the board
/RightHeight_3.3V: U10.25 (Pin19_A5_SCL0_Touch); also elsewhere on the board
/RightPressure_3.3V: U10.22 (Pin16_A2_SCL0_Touch); also elsewhere on the board
/RightSuck_DIAG: U10.38 (Pin27_A16); also elsewhere on the board
/RightSuck_ON: U10.36 (Pin25_Touch_PWM); also elsewhere on the board
/Spare1_DIAG: U10.20 (Pin14_A0_SCK); also elsewhere on the board
/Spare1_ON: U10.29 (Pin23_A9_Touch_CS_PWM); also elsewhere on the board
/SpareTemp_3.3V: U10.21 (Pin15_A1_CS_Touch); also elsewhere on the board
GND: U10.0 (GND), U10.31 (AGND), U10.34 (GND); also elsewhere on the board

Notes on the sheet:
Please note ! You need to cut the jumper that feeds from USB on your Teensy3.1 board. Else you will risk burning USB port on your computer.
To access the underside pins see: https://forum.pjrc.com/threads/26071-Using-all-Teensy3-x-pins-with-a-socket

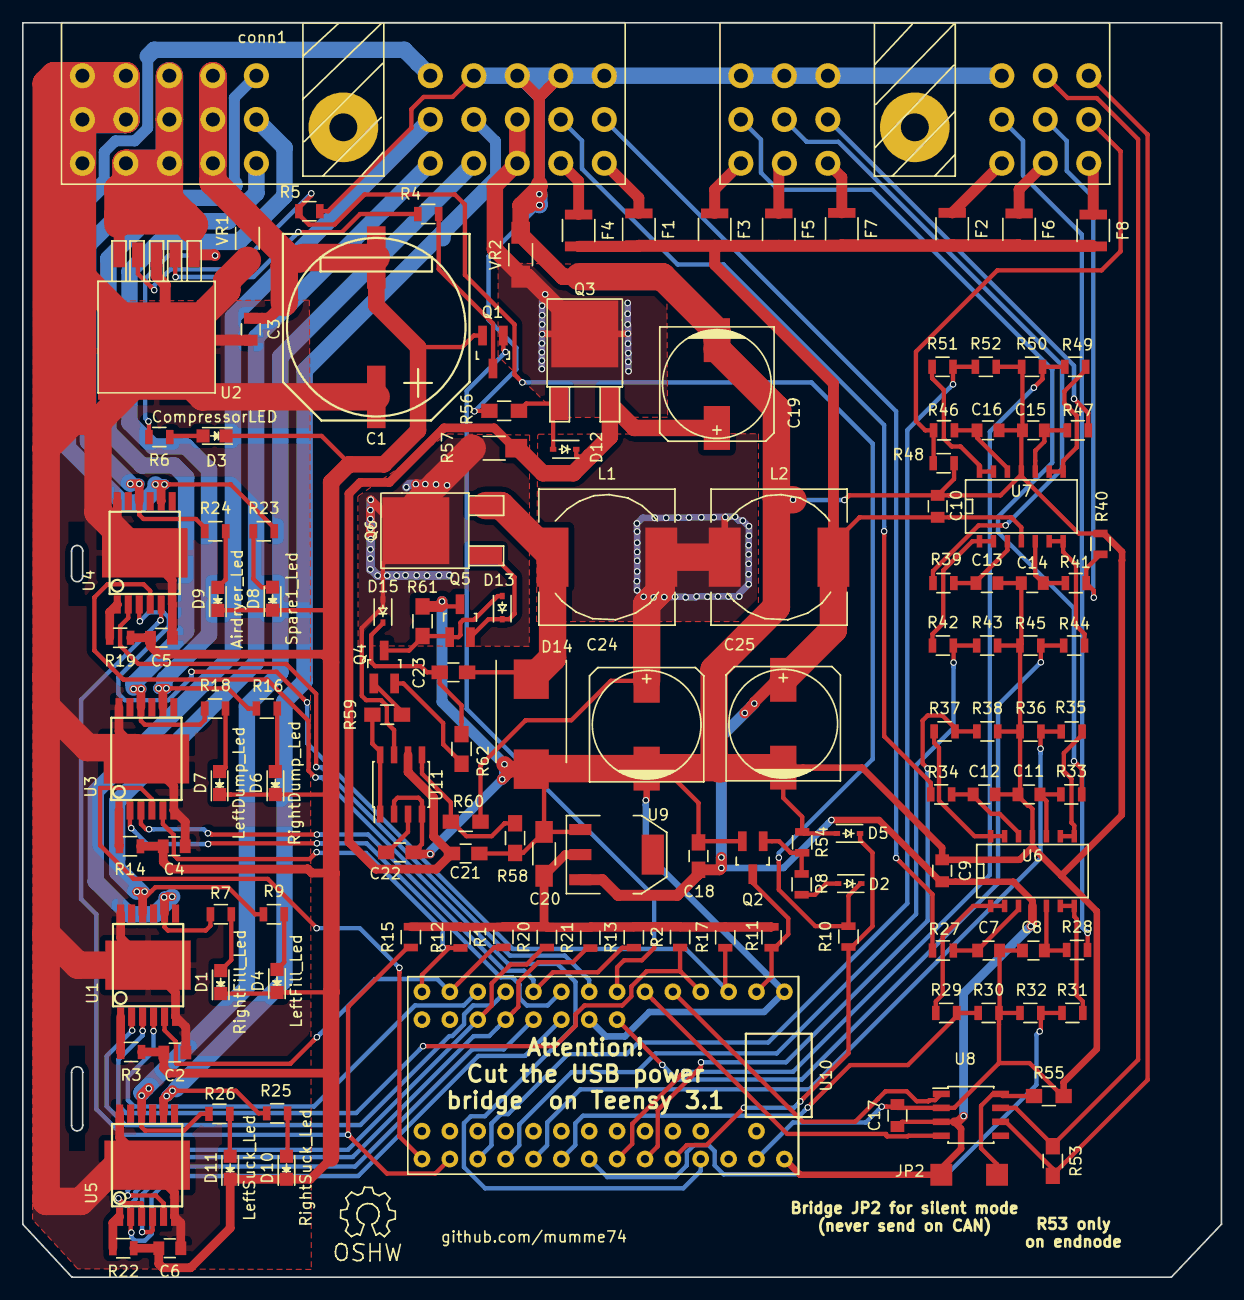
[picture p22: board airsuspension_controller.kicad_pcb from above]

Board: 2 copper layers, 109.2 x 114.3 mm, 133 parts (0 on the bottom side), 110 nets.
