mumme74/CarTransporter/firmware/display_NODE/canserial/canserial/main.c

/*
 * modified from candump.c
 *
 * Copyright (c) 2002-2009 Volkswagen Group Electronic Research
 * All rights reserved.
 *
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
 * Alternatively, provided that this notice is retained in full, this
 * software may be distributed under the terms of the GNU General
 * Public License ("GPL") version 2, in which case the provisions of the
 * GPL apply INSTEAD OF those given above.
 *
 * The provided data structures and external interfaces from this code
 * are not restricted to be used by modules with a GPL compatible license.
 *
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
 * Send feedback to <linux-can@vger.kernel.org>
 *
 */

#include <stdio.h>
#include <stdlib.h>
#include <stdint.h>
#include <unistd.h>
#include <string.h>
#include <signal.h>
#include <ctype.h>
#include <libgen.h>
#include <time.h>
#include <errno.h>

#include <sys/time.h>
#include <sys/types.h>
#include <sys/socket.h>
#include <sys/ioctl.h>
#include <sys/uio.h>
#include <net/if.h>

#include <linux/can.h>
#include <linux/can/raw.h>

#include "terminal.h"
#include "can_protocol.h"

/* for hardware timestamps - since Linux 2.6.30 */
#ifndef SO_TIMESTAMPING
#define SO_TIMESTAMPING 37
#endif

/* from #include <linux/net_tstamp.h> - since Linux 2.6.30 */
#define SOF_TIMESTAMPING_SOFTWARE (1<<4)
#define SOF_TIMESTAMPING_RX_SOFTWARE (1<<3)
#define SOF_TIMESTAMPING_RAW_HARDWARE (1<<6)

#define MAXSOCK 1     /* max. number of CAN interfaces given on the cmdline */
#define MAXIFNAMES 30 /* size of receive name index to omit ioctls */
#define MAXCOL 6      /* number of different colors for colorized output */
#define ANYDEV "any"  /* name of interface to receive from any CAN interface */
#define ANL "\r\n"    /* newline in ASC mode */

#define SILENT_INI 42 /* detect user setting on commandline */
#define SILENT_OFF 0  /* no silent mode */
#define SILENT_ANI 1  /* silent mode with animation */
#define SILENT_ON  2  /* silent mode (completely silent) */

#define MAX_NODENR 2


static char *cmdlinename[MAXSOCK];
static __u32 dropcnt[MAXSOCK];
static __u32 last_dropcnt[MAXSOCK];
static char devname[MAXIFNAMES][IFNAMSIZ+1];
static int  dindex[MAXIFNAMES];
static int  max_devname_len; /* to prevent frazzled device name output */
static const int canfd_on = 1;

extern int optind, opterr, optopt;

static volatile int running = 1;

// gets all frames for this string
typedef struct {
    uint8_t len;
    uint8_t written;
    char bufAll[7 * 0x7F + 1]; // +1 for \0 char
} complete_t;

void print_usage(char *prg)
{
    fprintf(stderr, "\nUsage: %s [options] <CAN interface>+\n", prg);
    fprintf(stderr, "  (use CTRL-C to terminate %s)\n\n", prg);
    fprintf(stderr, "Options: -n <nodeNr>  nodenr [0-7] ie: 0=parkbrakeNode\n");
    fprintf(stderr, "                                       1=suspensionNode\n");
    fprintf(stderr, "                                       2=displayNode <currently inactive>\n");
    fprintf(stderr, "                                       3-7=currently not used nodes\n");
    fprintf(stderr, "         -N <node>    nodename: parkbrakeNode | suspensionNode\n");
    fprintf(stderr, "         -i <ID>      CAN frameid to listen to in HEX\n");
    fprintf(stderr, "\n");
    fprintf(stderr, "A CAN interface must be specified\n");
    fprintf(stderr, "on the commandline in the form: <ifname>\n");
    fprintf(stderr, "\nCAN ID in hexadecimal values, or nodename  must be given.\n");
    fprintf(stderr, "\nUse interface name '%s' to receive from all CAN interfaces.\n", ANYDEV);
    fprintf(stderr, "\nExamples:\n");
    fprintf(stderr, "%s -N parkbrakeNode can0\n", prg);
    fprintf(stderr, "%s -n 0 can0\n", prg);
    fprintf(stderr, "%s -i 6a0 can0 for can serial on CANid 6a0\n", prg);
    fprintf(stderr, "\n");
}

void sigterm(int signo)
{
    (void)signo;
    running = 0;
}

int idx2dindex(int ifidx, int socket) {

    int i;
    struct ifreq ifr;

    for (i=0; i < MAXIFNAMES; i++) {
        if (dindex[i] == ifidx)
            return i;
    }

    /* create new interface index cache entry */

    /* remove index cache zombies first */
    for (i=0; i < MAXIFNAMES; i++) {
        if (dindex[i]) {
            ifr.ifr_ifindex = dindex[i];
            if (ioctl(socket, SIOCGIFNAME, &ifr) < 0)
                dindex[i] = 0;
        }
    }

    for (i=0; i < MAXIFNAMES; i++)
        if (!dindex[i]) /* free entry */
            break;

    if (i == MAXIFNAMES) {
        fprintf(stderr, "Interface index cache only supports %d interfaces.\n",
               MAXIFNAMES);
        exit(1);
    }

    dindex[i] = ifidx;

    ifr.ifr_ifindex = ifidx;
    if (ioctl(socket, SIOCGIFNAME, &ifr) < 0)
        perror("SIOCGIFNAME");

    if (max_devname_len < strlen(ifr.ifr_name))
        max_devname_len = strlen(ifr.ifr_name);

    strcpy(devname[i], ifr.ifr_name);

#ifdef DEBUG
    printf("new index %d (%s)\n", i, devname[i]);
#endif

    return i;
}

int main(int argc, char **argv)
{
    fd_set rdfs;
    int s[MAXSOCK];
    int bridge = 0;
    useconds_t bridge_delay = 0;
    unsigned char down_causes_exit = 1;
    int count = 0;
    int rcvbuf_size = 0;
    int opt, ret;
    int currmax;
    unsigned int canIdx;
    char *ptr, *nptr;
    struct sockaddr_can addr;
    char ctrlmsg[CMSG_SPACE(sizeof(struct timeval) + 3*sizeof(struct timespec) + sizeof(__u32))];
    struct iovec iov;
    struct msghdr msg;
    struct cmsghdr *cmsg;
    struct canfd_frame frame;
    int nbytes, i, maxdlen;
    struct ifreq ifr;
    struct timeval tv, last_tv;
    struct timeval timeout_config = { 0, 0 }, *timeout_current = NULL;

    signal(SIGTERM, sigterm);
    signal(SIGHUP, sigterm);
    signal(SIGINT, sigterm);

    last_tv.tv_sec  = 0;
    last_tv.tv_usec = 0;
    canIdx = 0;

    while ((opt = getopt(argc, argv, "i:n:N:h?")) != -1) {
        switch (opt) {
        case 'i': {
            long idx = strtol(optarg, NULL, 16);
            if (idx < 0 || idx > 0x7FFF) {
                print_usage(basename(argv[0]));
                exit(1);
            }
            canIdx = (unsigned int)idx;
        }   break;
        case 'n': {
            int idx = atoi(optarg);
            if (idx < 0 || idx > MAX_NODENR || !isdigit(optarg[0])) {
                print_usage(basename(argv[0]));
                exit(1);
            }
            switch (idx) {
            case 0:
                canIdx = CAN_MSG_TYPE_DIAG | C_parkbrakeDiagSerial | C_parkbrakeNode;
                break;
            case 1:
                canIdx = CAN_MSG_TYPE_DIAG | C_suspensionDiagSerial | C_suspensionNode;
                break;
            case 2:
                canIdx = CAN_MSG_TYPE_DIAG | C_displayDiag_LAST | C_displayNode;
                break;
            case 3:
                canIdx = CAN_MSG_TYPE_DIAG;
                break;
            case 4:
                canIdx = CAN_MSG_TYPE_DIAG;
                break;
            case 5:
                canIdx = CAN_MSG_TYPE_DIAG;
                break;
            case 6:
                canIdx = CAN_MSG_TYPE_DIAG;
                break;
            case 7:
                canIdx = CAN_MSG_TYPE_DIAG;
                break;
            default:
                break;
            }
        }   break;
        case 'N':
            if (strcmp(optarg, "parkbrakeNode") == 0)
                canIdx = CAN_MSG_TYPE_DIAG | C_parkbrakeDiagSerial | C_parkbrakeNode;
            else if (strcmp(optarg, "suspensionNode") == 0)
                canIdx = CAN_MSG_TYPE_DIAG | C_suspensionDiagSerial | C_suspensionNode;
            break;
        case '?':
            fprintf(stderr, "unknown option char at index:%d", optind);
            exit(1);
        case 'h':
        default:
            print_usage(basename(argv[0]));
            exit(1);
        }
    }

    if (optind == argc || canIdx <= 0) {
        print_usage(basename(argv[0]));
        exit(0);
    }

    currmax = argc - optind; /* find real number of CAN devices */

    fprintf(stdout, "using CANid:%x\r\n", canIdx);

    if (currmax > MAXSOCK) {
        fprintf(stderr, "More than %d CAN devices given on commandline!\n", MAXSOCK);
        return 1;
    }

    for (i=0; i < currmax; i++) {

        ptr = argv[optind+i];
        nptr = strchr(ptr, ',');

#ifdef DEBUG
        printf("open %d '%s'.\n", i, ptr);
#endif

        s[i] = socket(PF_CAN, SOCK_RAW, CAN_RAW);
        if (s[i] < 0) {
            perror("socket");
            return 1;
        }

        cmdlinename[i] = ptr; /* save pointer to cmdline name of this socket */

        if (nptr)
            nbytes = nptr - ptr;  /* interface name is up the first ',' */
        else
            nbytes = strlen(ptr); /* no ',' found => no filter definitions */

        if (nbytes >= IFNAMSIZ) {
            fprintf(stderr, "name of CAN device '%s' is too long!\n", ptr);
            return 1;
        }

        if (nbytes > max_devname_len)
            max_devname_len = nbytes; /* for nice printing */

        addr.can_family = AF_CAN;

        memset(&ifr.ifr_name, 0, sizeof(ifr.ifr_name));
        strncpy(ifr.ifr_name, ptr, nbytes);

#ifdef DEBUG
        printf("using interface name '%s'.\n", ifr.ifr_name);
#endif
        // set can interface
        if (strcmp(ANYDEV, ifr.ifr_name)) {
            if (ioctl(s[i], SIOCGIFINDEX, &ifr) < 0) {
                perror("SIOCGIFINDEX");
                exit(1);
            }
            addr.can_ifindex = ifr.ifr_ifindex;
        } else
            addr.can_ifindex = 0; /* any can interface */

        // filter out all other messages
        struct can_filter rcvfilter;
        if (canIdx < 0x800) {
            // 11 bit id
            rcvfilter.can_mask = 0x7FF; // filter in only this id
        } else {
            // 29 bit (extended frame)
            rcvfilter.can_mask = 0x7FFF;
        }
        rcvfilter.can_id = canIdx;
        setsockopt(s[i], SOL_CAN_RAW, CAN_RAW_FILTER, &rcvfilter, sizeof (struct can_filter));

        /* try to switch the socket into CAN FD mode */
        setsockopt(s[i], SOL_CAN_RAW, CAN_RAW_FD_FRAMES, &canfd_on, sizeof(canfd_on));

        if (rcvbuf_size) {

            int curr_rcvbuf_size;
            socklen_t curr_rcvbuf_size_len = sizeof(curr_rcvbuf_size);

            /* try SO_RCVBUFFORCE first, if we run with CAP_NET_ADMIN */
            if (setsockopt(s[i], SOL_SOCKET, SO_RCVBUFFORCE,
                       &rcvbuf_size, sizeof(rcvbuf_size)) < 0) {
#ifdef DEBUG
                printf("SO_RCVBUFFORCE failed so try SO_RCVBUF ...\n");
#endif
                if (setsockopt(s[i], SOL_SOCKET, SO_RCVBUF,
                           &rcvbuf_size, sizeof(rcvbuf_size)) < 0) {
                    perror("setsockopt SO_RCVBUF");
                    return 1;
                }

                if (getsockopt(s[i], SOL_SOCKET, SO_RCVBUF,
                           &curr_rcvbuf_size, &curr_rcvbuf_size_len) < 0) {
                    perror("getsockopt SO_RCVBUF");
                    return 1;
                }

                /* Only print a warning the first time we detect the adjustment */
                /* n.b.: The wanted size is doubled in Linux in net/sore/sock.c */
                if (!i && curr_rcvbuf_size < rcvbuf_size*2)
                    fprintf(stderr, "The socket receive buffer size was "
                        "adjusted due to /proc/sys/net/core/rmem_max.\n");
            }
        }

        if (bind(s[i], (struct sockaddr *)&addr, sizeof(addr)) < 0) {
            perror("bind");
            return 1;
        }
    }


    /* these settings are static and can be held out of the hot path */
    iov.iov_base = &frame;
    msg.msg_name = &addr;
    msg.msg_iov = &iov;
    msg.msg_iovlen = 1;
    msg.msg_control = &ctrlmsg;

    complete_t lineBuf;
    lineBuf.bufAll[0x80] = '\0';
    lineBuf.len = lineBuf.written = 0;

    while (running) {

        FD_ZERO(&rdfs);
        for (i=0; i<currmax; i++)
            FD_SET(s[i], &rdfs);

        if (timeout_current)
            *timeout_current = timeout_config;

        if ((ret = select(s[currmax-1]+1, &rdfs, NULL, NULL, timeout_current)) <= 0) {
            //perror("select");
            running = 0;
            continue;
        }

        for (i=0; i<currmax; i++) {  /* check all CAN RAW sockets */
            if (FD_ISSET(s[i], &rdfs)) {

                int idx;

                /* these settings may be modified by recvmsg() */
                iov.iov_len = sizeof(frame);
                msg.msg_namelen = sizeof(addr);
                msg.msg_controllen = sizeof(ctrlmsg);
                msg.msg_flags = 0;

                nbytes = recvmsg(s[i], &msg, 0);
                idx = idx2dindex(addr.can_ifindex, s[i]);

                if (nbytes < 0) {
                    if ((errno == ENETDOWN) && !down_causes_exit) {
                        fprintf(stderr, "%s: interface down\n", devname[idx]);
                        continue;
                    }
                    perror("read");
                    return 1;
                }

                if ((size_t)nbytes == CAN_MTU)
                    maxdlen = CAN_MAX_DLEN;
                else if ((size_t)nbytes == CANFD_MTU)
                    maxdlen = CANFD_MAX_DLEN;
                else {
                    fprintf(stderr, "read: incomplete CAN frame\n");
                    return 1;
                }

                if (count && (--count == 0))
                    running = 0;

                if (bridge) {
                    if (bridge_delay)
                        usleep(bridge_delay);

                    nbytes = write(bridge, &frame, nbytes);
                    if (nbytes < 0) {
                        perror("bridge write");
                        return 1;
                    } else if ((size_t)nbytes != CAN_MTU && (size_t)nbytes != CANFD_MTU) {
                        fprintf(stderr,"bridge write: incomplete CAN frame\n");
                        return 1;
                    }
                }

                for (cmsg = CMSG_FIRSTHDR(&msg);
                     cmsg && (cmsg->cmsg_level == SOL_SOCKET);
                     cmsg = CMSG_NXTHDR(&msg,cmsg)) {
                    if (cmsg->cmsg_type == SO_TIMESTAMP) {
                        memcpy(&tv, CMSG_DATA(cmsg), sizeof(tv));
                    } else if (cmsg->cmsg_type == SO_TIMESTAMPING) {

                        struct timespec *stamp = (struct timespec *)CMSG_DATA(cmsg);

                        /*
                         * stamp[0] is the software timestamp
                         * stamp[1] is deprecated
                         * stamp[2] is the raw hardware timestamp
                         * See chapter 2.1.2 Receive timestamps in
                         * linux/Documentation/networking/timestamping.txt
                         */
                        tv.tv_sec = stamp[2].tv_sec;
                        tv.tv_usec = stamp[2].tv_nsec/1000;
                    } else if (cmsg->cmsg_type == SO_RXQ_OVFL)
                        memcpy(&dropcnt[i], CMSG_DATA(cmsg), sizeof(__u32));
                }

                /* check for (unlikely) dropped frames on this specific socket */
                if (dropcnt[i] != last_dropcnt[i]) {

                    __u32 frames = dropcnt[i] - last_dropcnt[i];

                   printf("DROPCOUNT: dropped %d CAN frame%s on '%s' socket (total drops %d)\n",
                          frames, (frames > 1)?"s":"", devname[idx], dropcnt[i]);


                    last_dropcnt[i] = dropcnt[i];
                }

                int sendIdx;
                if (frame.data[0] & 0x80) {
                    // new message
                    // first send old
                    if (lineBuf.len) {
                        if (lineBuf.written < 0x80)
                            lineBuf.bufAll[lineBuf.written] = '\0';
                        printf("%s", lineBuf.bufAll);
                        fflush(stdout);
                    }
                    sendIdx = 0;
                    lineBuf.len = frame.data[0] & 0x7F;
                    lineBuf.written = frame.len -1;
                } else {
                    // continued msg
                    sendIdx = frame.data[0] & 0x7F;
                    lineBuf.written += frame.len -1;
                }

                // save this msg to buffer
                if (lineBuf.written <= lineBuf.len) {
                    for (int n = 1; n < frame.len; ++n) {
                        lineBuf.bufAll[(sendIdx*7) + n -1] = frame.data[n];
                    }
                }
                //printf("\nframeid:%x d[0]:%x new:%d f.len:%d", frame.can_id, frame.data[0], frame.data[0] & 0x80, frame.len);
                //printf(" sendIdx:%d lineBuf.len:%d linebuf.written:%d\n", sendIdx, lineBuf.len, lineBuf.written);


                // print this string
                if (lineBuf.written >= lineBuf.len) {
                    if (lineBuf.written < 0x80)
                        lineBuf.bufAll[lineBuf.written] = '\0';
                    printf("%s", lineBuf.bufAll);
                    //for(int n = 0; n < lineBuf.len;++n)
                    //    printf("%x,", lineBuf.bufAll[n]);
                    fflush(stdout);
                    lineBuf.written = lineBuf.len = 0;
                }
            }
        }

    } // running loop

    for (i=0; i<currmax; i++)
        close(s[i]);

    if (bridge)
        close(bridge);


    return 0;
}
