mumme74/CarTransporter/(commit log)

2013-01-07 Share spi bus for multiple peripherals
2013-01-09 Add 24xx(AA/LC) driver (up to 64KiB)
2015-03-15 Initial commit Only Airsuspension ECU schematic for now
    [Airsuspension_5V.sch, airsupsension_inputs.sch, airsuspension_CAN.sch, airsuspension_MCU.sch, airsuspension_controller.csv, airsuspension_controller.sch, airsuspension_outputs.sch]
2015-03-24 more footprints...
    [Airsuspension_5V.sch, airsupsension_inputs.sch, airsuspension_CAN.sch, airsuspension_MCU.sch, airsuspension_controller.sch, airsuspension_outputs.sch]
2015-04-07 Firmware and some changes in electronics schema
    [Airsuspension_5V.sch, airsupsension_inputs.sch]
2015-04-07 implemnt some weight calculation code based on pressure sensors
    [airsuspension_CAN.sch, airsuspension_MCU.sch, airsuspension_controller.csv, airsuspension_controller.sch, airsuspension_outputs.sch]
2015-04-19 First live test on a teensy ifxed some bugs that hanged initialization
    [suspension_ECU.ino]
2015-04-19 Some more fottprints added to PCB
    [Airsuspension_5V.sch, airsuspension_CAN.sch, airsuspension_outputs.sch]
2015-04-19 some fottprints and BOM changes
    [airsuspension_CAN.sch, airsuspension_controller.csv, airsuspension_outputs.sch]
2015-05-17 Some more footprints and beginning PCB work
    [Airsuspension_5V.sch, airsupsension_inputs.sch, airsuspension_CAN.sch, airsuspension_MCU.sch, airsuspension_controller.kicad_pcb, airsuspension_controller.sch, airsuspension_outputs.sch]
2016-03-29 Changed to a more stable powersupply (3Amps 5V and separate 3.3v) + some few cleanups due to updated kicad
    [Airsuspension_5V.sch, airsupsension_inputs.sch, airsuspension_CAN.sch, airsuspension_MCU.sch, airsuspension_controller.csv, airsuspension_controller.kicad_pcb, airsuspension_controller.sch, airsuspension_outputs.sch]
2016-03-31 First placement with a ModICE enclosure
    [Airsuspension_5V.sch, airsupsension_inputs.sch, airsuspension_CAN.sch, airsuspension_MCU.sch, airsuspension_controller.kicad_pcb, airsuspension_controller.sch, airsuspension_controller_hardware.ods, airsuspension_outputs.sch]
2016-04-01 PCB routing done
    [airsuspension_controller.kicad_pcb, airsuspension_controller.sch, airsuspension_outputs.sch]
2016-04-02 Some updates as some parts were not available
    [Airsuspension_5V.sch, airsupsension_inputs.sch, airsuspension_CAN.sch, airsuspension_MCU.sch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]
2016-04-03 first checkin of parkbrake module
    [Airsuspension_5V.sch, H-BridgeFront.sch, H-BridgeRear.sch, H-Bridge_logic.sch, Parkbrake.kicad_pcb, Parkbrake.sch, PowerRegulators.sch, airsupsension_inputs.sch]
2016-04-04 Fixes to Bat switch and polarity protection
    [H-BridgeFront.sch, H-BridgeRear.sch, Parkbrake.sch]
2016-04-17 Add currentlimit latching to avaoid current limit oscilation Start a mcu schema part
    [H-BridgeFront.sch, H-BridgeRear.sch, H-Bridge_logic.sch, Parkbrake.sch, PowerRegulators.sch, microcontroller.sch]
2016-07-17 Changed value of load sensing resistor for 5V switch do reduce system noise
    [Airsuspension_5V.sch, airsuspension_controller.csv]
2016-07-19 Added some documentation Schematic document
    [airsuspension_controller.sch]
2016-07-21 More work on parkbrake node
    [H-BridgeFront.sch, H-BridgeRear.sch, H-Bridge_logic.sch, Parkbrake.sch, PowerRegulators.sch, buttonlogic.sch, communication_and_debug.sch, input_things.sch]
2016-07-21 ordernr, type and footprints for all components
    [H-BridgeFront.sch, H-BridgeRear.sch, H-Bridge_logic.sch, Parkbrake.sch, PowerRegulators.sch, buttonlogic.sch, communication_and_debug.sch, input_things.sch]
2016-07-21 Make it pass DRC rule check
    [H-BridgeFront.sch, H-BridgeRear.sch, H-Bridge_logic.sch, Parkbrake.sch, PowerRegulators.sch, buttonlogic.sch, communication_and_debug.sch, input_things.sch]
2016-07-22 More fixes and chenged components eat less boardspace
    [H-BridgeFront.sch, H-BridgeRear.sch, H-Bridge_logic.sch, Parkbrake.csv, Parkbrake.kicad_pcb, Parkbrake.sch, PowerRegulators.sch, airsuspension_controller.sch]
2016-07-23 some more work on parkbrake pcb
    [H-BridgeFront.sch, H-BridgeRear.sch, H-Bridge_logic.sch, Parkbrake.kicad_pcb, Parkbrake.sch, PowerRegulators.sch, buttonlogic.sch, communication_and_debug.sch]
2016-07-28 more work on parkbrake ecu Rear H-bridge more or less finished
    [H-BridgeFront.sch, H-BridgeRear.sch, H-Bridge_logic.sch, Parkbrake.kicad_pcb, Parkbrake.sch, PowerRegulators.sch, buttonlogic.sch, communication_and_debug.sch]
2016-07-28 Front motors H-bridge finished
    [H-BridgeFront.sch, H-BridgeRear.sch, H-Bridge_logic.sch, Parkbrake.kicad_pcb, Parkbrake.sch, PowerRegulators.sch, buttonlogic.sch, communication_and_debug.sch]
2016-08-02 More work on inputs and 5 volt
    [Parkbrake.kicad_pcb, Parkbrake.sch, buttonlogic.sch, microcontroller.sch, wheelsensors.sch]
2016-08-04 traceroute finished although there probably is some errors
    [Parkbrake.kicad_pcb, PowerRegulators.sch, buttonlogic.sch, communication_and_debug.sch, input_things.sch, microcontroller.sch, wheelsensors.sch]
2016-08-04 DRC pass!
    [Parkbrake.kicad_pcb]
2016-08-04 Component ids moved and removed silkscreen for high current copper, solder strengthed copper
    [Parkbrake.kicad_pcb]
2016-08-05 Added copperareas
    [Parkbrake.kicad_pcb]
2017-01-03 Changed solder trace zones, was silkscreen now soldermask
    [Parkbrake.kicad_pcb]
2017-01-08 Some helper files
    [Parkbrake.csv, ordering.ods]
2017-01-08 Updated installation diagram files
    [ordering.ods]
2017-07-25 Some changes to suspension
    [ordering.ods]
2017-07-25 Initial commit starting a chibios firmware for parkbrake
    [Parkbrake-B.Cu.gbr, Parkbrake-B.Mask.gbr, Parkbrake-B.SilkS.gbr, Parkbrake-Edge.Cuts.gbr, Parkbrake-F.Cu.gbr, Parkbrake-F.Mask.gbr, Parkbrake-F.SilkS.gbr, Parkbrake.drl]
2017-07-27 More work, added control logic for motors and a settings interface Also switched eeprom lib
2017-07-28 More changes to parkbrake, added logic for controling button and refined motor activation logic
2017-07-31 Changed debug out to a separate file started Implement CAN Tried to make wheelsensors measurement work (not in a working state yet)
2017-07-31 More work on CAN, PID updates implemented
2017-08-04 More work on the diag interface via CAN bus Should be more or less feature complete now -> wheelspeeds info require pcb re-engineering
2017-08-06 Beginning raspberry3 displaynode
2017-08-08 Add support for settings and error notifications
    [can.c, can_protocol.h, cannodes.cpp, cannodes.h, eeprom_setup.c, eeprom_setup.h, main.cpp]
2017-08-13 Bug fix and unify can protocol
    [AirFeed.cpp, AirFeed.h, Height.cpp, Height.h, IOController.cpp, IOController.h, can_protocol.h, suspension_ECU.ino]
2018-04-01 DTC fixes for suspensionNode
    [can_protocol.h, cannodes.cpp, canparkbrakenode.cpp, cansuspensionnode.cpp]
2018-04-02 Added sensor reverse to suspensionNode config and some more bugfixes
    [Height.cpp, suspension_config.h]
2018-04-02 Spread workload on CAN network when a PID is updated
2018-04-02 Height status changes added, error messages when we cant send to CAN and many small bug fixes
    [caninterface.cpp, cannodes.cpp, cannodes.h, canparkbrakenode.cpp, canparkbrakenode.h, cansuspensionnode.cpp, cansuspensionnode.h]
2018-04-08 Bugfix DTC parkbrake erase button of screen Enhanched weight dialog
2018-07-11 Added pcb for parkbrake manuvering switch
    [Parkbrake_switch-B.Cu.gbr, Parkbrake_switch-B.Mask.gbr, Parkbrake_switch-B.SilkS.gbr, Parkbrake_switch-Edge.Cuts.gbr, Parkbrake_switch-F.Cu.gbr, Parkbrake_switch-F.Mask.gbr, Parkbrake_switch-F.SilkS.gbr, Parkbrake_switch-NPTH.drl]
2018-07-12 Removed old lib, is included in teensyduino now
2018-07-12 Fix crash on real hardware, beginning bughunt
    [IOController.cpp, IOController.h, suspension_ECU.ino]
2018-07-12 Bugfixes for NTC, pressure and CAN
    [Height.cpp]
2018-07-12 BOM files
    [Parkbrake.ods, airsuspension_controller.ods]
2018-07-13 Simplyfy API and avoid frames sent on wrong type
    [caninterface.cpp, caninterface.h, cannodes.cpp, canparkbrakenode.cpp, cansuspensionnode.cpp]
2018-07-13 Added a CAN error table to ui
    [caninfo.cpp, caninfo.h, caninterface.cpp, caninterface.h, keyboardevents.cpp, keyboardevents.h]
2018-07-13 many fixes to make CAN work more consistently with displaynode
    [IOController.cpp, pinouts.h, suspension_ECU.ino]
2018-07-13 Fixes to make displayNode work consitently with suspensionNode
    [caninterface.cpp, cannodes.cpp, cannodes.h, canparkbrakenode.cpp, cansuspensionnode.cpp, cansuspensionnode.h]
2018-07-18 Many bugfixes, for example make height statemachine work Re-engineer to exclude Compressor pwm controlled to relay control
    [AirFeed.cpp, AirFeed.h, Height.cpp, can_protocol.h, cansuspensionnode.cpp, cansuspensionnode.h, suspension_ECU.ino]
2018-07-18 forgot wiring documentation
2018-07-18 minor tweaks to pcb, had a cap on wrong polarity
    [H-Bridge_logic.sch, Parkbrake.kicad_pcb, Parkbrake.sch, PowerRegulators.sch, input_things.sch, wheelsensors.sch]
2018-07-18 Fix compiler warnings when build -O0
    [can.c, control.h, sensors.c, tmr_capture.c]
2018-07-20 reduce switching noise from 5v regulator circuit
    [H-BridgeFront.sch, H-BridgeRear.sch, H-Bridge_logic.sch, Parkbrake.kicad_pcb, Parkbrake.sch, PowerRegulators.sch, buttonlogic.sch, communication_and_debug.sch]
2018-07-21 Fix display of volts
    [cannodes.cpp]
2018-07-21 Tweak CAN inputs on board config
2018-07-21 Make sensors working
2018-07-21 Make CAN baudrate 250000 and fix some bugs in RPC mechanism
    [can.c]
2018-07-21 More bugfixes diag and control modules
    [control.c, diag.c]
2018-07-21 Attempt to make eeprom save nonblock to rx thread
2018-07-22 Wrong IC
    [H-BridgeFront.sch, H-BridgeRear.sch, H-Bridge_logic.sch, Parkbrake.sch, PowerRegulators.sch, buttonlogic.sch, communication_and_debug.sch, input_things.sch]
2018-07-23 Make parkbrake activation activate correct wheel
    [canparkbrakenode.cpp, diag.c]
2018-07-24 Made ADC bridge work somewhat very hard on processortime
2018-07-26 Tweak board pins
2018-07-26 Tweaks to motorcurrents measurement
2018-07-26 Fix hang due to lost variable after thd switch
    [control.c]
2018-07-26 Rethink hardware current limit, it didn't work as I rememberd
    [H-Bridge_logic.sch, microcontroller.sch]
2018-07-26 Made system able to reset from a CAN cmd Precursor for a bootloader
    [button_logic.c, button_logic.h, can.c, can.h, can_protocol.h, canserial.c, canserial.h, control.c]
2018-07-29 Made a bootloader application to run on raspberrypi (in terminal) Not yet complete and definetly not debugged
2018-07-30 Commenting code, minor fixes and spelling
    [can_protocol.h, commands.c]
2018-08-11 More work, still ha a race condition and loosing frames
2018-08-12 Fix problem with bin of odd size fail on write Fix problem with jump to application Fix bootloadermode hook when a valid bin is in flash (can filter problem)
    [can.h, can_protocol.h, can_stm32f373.c, commands.c, main.c]
2019-07-02 Starting to port bootloader to teensy3
2019-07-02 More work regarding teensy bootloader
2019-07-03 Broke out some common functions to a architecture common file
    [can.c, can.h, can_stm32f373.c, main_teensy3.cpp]
2019-07-03 Made bootloader node feature complete for teensy, untested though
2019-07-05 First attempt to abstract driver, eventually be able to use different drivers and port to macos and windows
2019-07-05 Tweaked drivers choice
2019-07-05 Begin new driver slcan (can over serialport ala lawicell)
2019-07-06 More work on slcan driver
2019-07-06 Better fault description when serial send errors
    [slcan.c]
2019-07-06 Activate slcan driver and apple fixes
    [canbridge.c, canbridge.h, commands.c, main.c, slcan.c]
2019-07-07 Latency issues with FTDI chips
    [slcan.c]
2019-07-09 Bugfixes CAN send and recieve
    [slcan.c]
2019-07-09 Debugging teensy can messages
2019-07-09 Compiler warnings, clock issue
    [canpids.cpp, canpids.h]
2019-07-09 Warning in schematic
    [PowerRegulators.sch]
2019-07-10 Implement error retrieval from device, and more bugfixes
    [slcan.c, slcan.h]
2019-07-10 Arduino makefile fixes for linux machine
    [AirFeed.cpp, IOController.cpp]
2019-07-10 Continue chasing can I/O bugs
    [can.c, commands.c, main_teensy3.cpp]
2019-07-10 More windows fixes, got a bit further
    [main.c, slcan.c]
2019-07-11 I think slan <-> canusb mostly works by now. More work on teensy node code
2019-07-12 Fix bug reset, reduce binzize and simplify debug printing
    [can.h, commands.c, main_teensy3.cpp, system.h, system_teensy3.cpp]
2019-07-13 A CAN driver standalone from FlexCAN lib
2019-07-13 Got FlexCAN to send and recieve, same loss of frame though
2019-07-14 Still chasing race issues, fixed a couple of bugsduring startup
    [commands.c, main.c, slcan.c]
2019-07-14 Fix bug on ID field, fix reset
    [can.c, commands.c, commands.h, system.h, system_teensy3.c]
2019-07-14 Last frame was off by 1
2019-07-15 Read and writes work on network level. Still issues with alignment in node code for teensy
    [can.c, can_protocol.h, can_teensy3.c, commands.c, system.h, system_teensy3.c]
2019-07-15 Fixed a error on read when requesting non aligned(uint32_t) size Fixed issue with writing to both block of a flash section
    [canbridge.c, canbridge.h, commands.c, slcan.c, slcan.h, socketcan.c, socketcan.h]
2019-07-16 Added filter option
2019-07-17 Fix a bug in write to node Tried to activate CAN filter
    [canbridge.c, canbridge.h, commands.c, main.c, slcan.c, slcan.h, socketcan.c, socketcan.h]
2019-07-18 Fixes to make suspension work with bootloader
    [IOController.cpp]
2019-07-18 Windows changes, compiles but still apear to have some timing issues
    [canbridge.c, commands.c, main.c, slcan.c, win_common.c, win_common.h]
2019-07-19 Reverse order prolonged bootloader time if DEBUG_PRINT
    [system.h]
2019-07-19 Fix lost frame issue
    [can_teensy3.c, fifo.h]
2019-07-20 introduce delay to make slow interfaces work even in socketcan mode
2019-07-21 Added a software pwm thread Also some cleanup
2019-07-22 Routed together control and pwm modules
2019-07-22 Tried to centralize byte shuffling unions to one file rename canframe_t -> can_frame_t to avoid name clash
    [can.c, can.h, can_stm32f373.c, can_teensy3.c, can_types.h, canbridge.h, commands.c, commands.h]
2019-07-23 More work on filtering, only want response from intended node
2019-07-23 got a bit further with filters in nodes
2019-07-23 Stm32 filter issues solved and some other bugs ironed out
    [can_stm32f373.c, commands.c]
